pavluchenkor/iDryer-X/docs/en/v3/pcb-pinout.md

# Pinout

!!! tip "Fan Connection"
    Make sure the fan connector polarity matches the pinout on the board (Fan header). If needed, repin the fan connector accordingly.

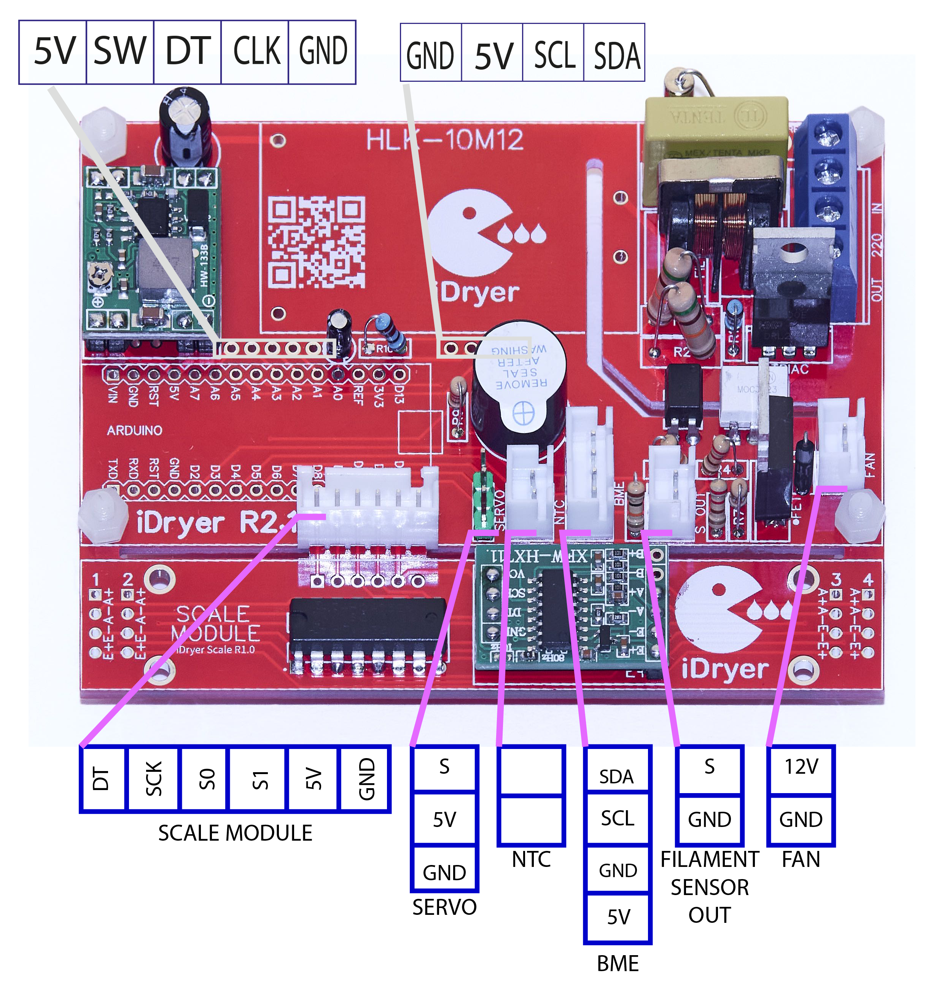
[picture p4: docs/img/pcb-pinout/pinout.png]


<!-- [![Telegram](https://img.shields.io/badge/Telegram-Join%20Group-blue)](https://t.me/iDryer)  [![YouTube](https://img.shields.io/badge/YouTube-Watch%20video-red)](https://www.youtube.com/@iDryerProject) [![Rutube](https://img.shields.io/badge/Rutube-Watch%20video-blue)](https://rutube.ru/channel/34401569/) -->
