pavluchenkor/iDryer-X/docs/ru/v3/pcb-pinout.md

# Pinout

!!! tip "Подлкючение кулера"
    Необходимо проверить соответствие полярности разъема вентилятора и разъема на плате(Fan). При необходимости следует перепиновать разъем вентилятора.
