pavluchenkor/iDryer-X/docs/en/v3/pcb.md

# Printed Circuit Board

## iDryer r2.1

You can independently order the manufacturing of the PCB and purchase the required components.
If you have basic soldering skills, assembly will be easy-components are all through-hole and large, and community members are always happy to help with advice.

!!! note "Download Files for r2.1"

```
PCB Design r2.1 on [jlcpcb.com](https://oshwlab.com/svet_team/idryer_copy_copy)

BOM for DIY assembly r2.1 on [Google Docs](https://docs.google.com/spreadsheets/d/1Y0MG9n_SadcK8cb_-e9J9ABQYqM_iH7iXZHlKbaz7wk/edit?usp=sharing)
```

## Appearance

<div class="grid cards" markdown>
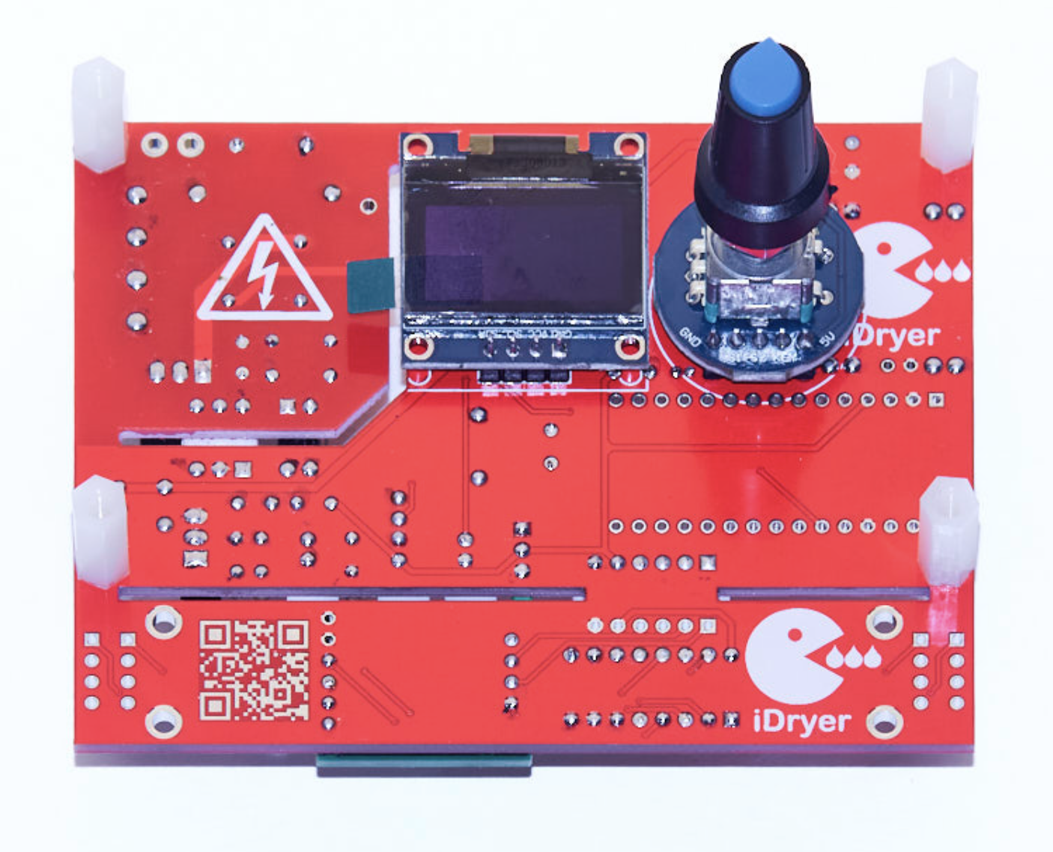
[picture p5: docs/img/pcb/img2023-12-12-1.png]
- 
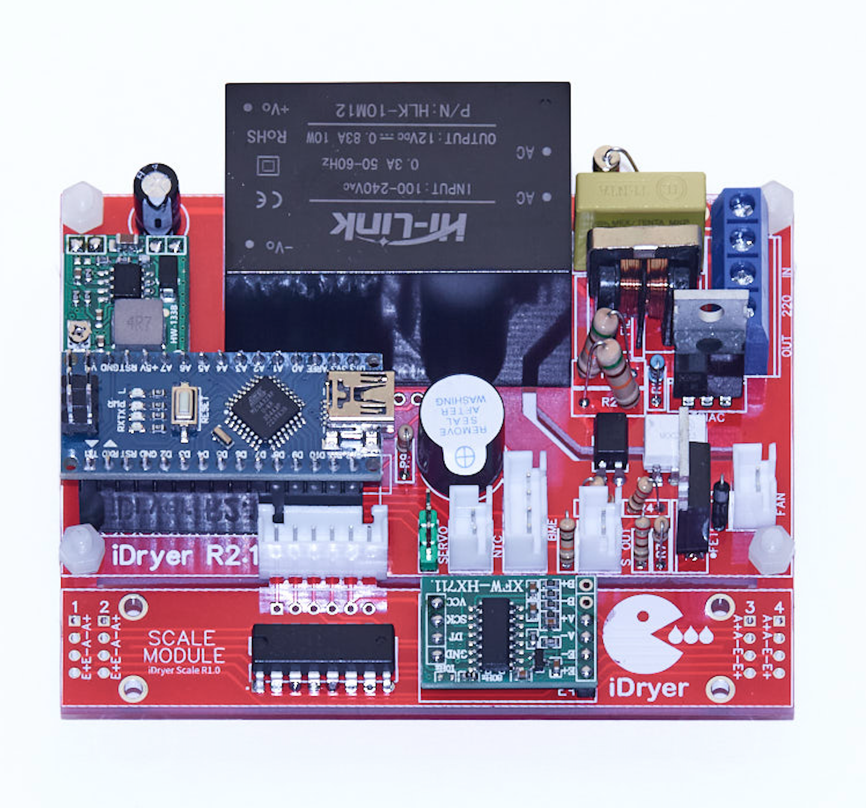
[picture p6: docs/img/pcb/img2023-12-12.png]
- 
</div>

!!! warning "Display and Encoder"
In the current case design, the display and encoder are connected using the wires included in the DIY kit.

<!-- [![Telegram](https://img.shields.io/badge/Telegram-Join%20Group-blue)](https://t.me/iDryer)  [![YouTube](https://img.shields.io/badge/YouTube-Watch%20video-red)](https://www.youtube.com/@iDryerProject) [![Rutube](https://img.shields.io/badge/Rutube-Watch%20video-blue)](https://rutube.ru/channel/34401569/) -->
