pavluchenkor/iDryer-X/docs/de/v3/before.md

# Vor der Montage

!!! warning "Bereiten Sie die erforderlichen Materialien und Geräte vor und überprüfen Sie die Vollständigkeit des Satzes."

## Materialien und Geräte

Für die Montage des Geräts benötigen Sie:

- Hochtemperatur-Silikon-Dichtstoff (z. B. Kamin- oder Automobilsilikon) mit guten Klebeigenschaften für PIR-Panel-basierte Materialien.

- 3D-Drucker und eine kleine Menge ABS-Kunststoff zum Drucken fehlender Gehäuseteile.

- Computer mit installiertem Visual Studio Code und PlatformIO

- USBASP-Programmer zum Flashen des Arduino Nano-basierten Steuerkarte.

- Lötausrüstung, einschließlich Lötkolben, Lot, Flussmittel und Reinigungsmittel für die Leiterplatte nach dem Löten.

- Multimeter zur Einstellung der Versorgungsspannung.

- Standard-Werkzeugsatz wie Schraubendreher, Messer, Seitenschneider, Elektroschrauber oder Bohrmaschine.

- Crimpzange zum Crimpen von Steckern und Verbindungen (bei Nichtvorhandensein können Hilfsmittel verwendet werden, jedoch wird eine Crimpzange für höhere Verbindungsqualität empfohlen).

## Montageempfehlungen

Lesen Sie die Anleitung und drucken Sie die erforderlichen Teile aus.

Bevor Sie Komponenten endgültig fixieren, müssen Sie sie vorher anpassen, anprobieren und überprüfen, dass sie richtig sitzen und kompatibel sind. Stellen Sie sicher, dass alle Teile korrekt installiert sind, dass nichts ihre Befestigung und weitere Montage behindert. Führen Sie erst nach vollständiger Überprüfung die endgültige Fixierung und Befestigung durch.

Wenn die Montage Elektronikkomponenten betrifft, müssen alle Arbeiten am Arbeitsplatz durchgeführt werden. Alle Baugruppen werden auf der Arbeitsfläche zusammengesetzt: Lüfter, Heizelement, Sensoren werden angeschlossen, Display, Encoder und andere Systemelemente. Nach Abschluss der Montage am Arbeitsplatz wird die Funktionsfähigkeit aller angeschlossenen Komponenten überprüft.

Dieser Ansatz vermeidet die Notwendigkeit, das bereits montierte Gerät beim Auffinden von Fehlern zu zerlegen, und macht den Montageprozess bequemer, sauberer und vorhersehbarer.
