pavluchenkor/iDryer-X/docs/de/v3/kit.md

# KIT

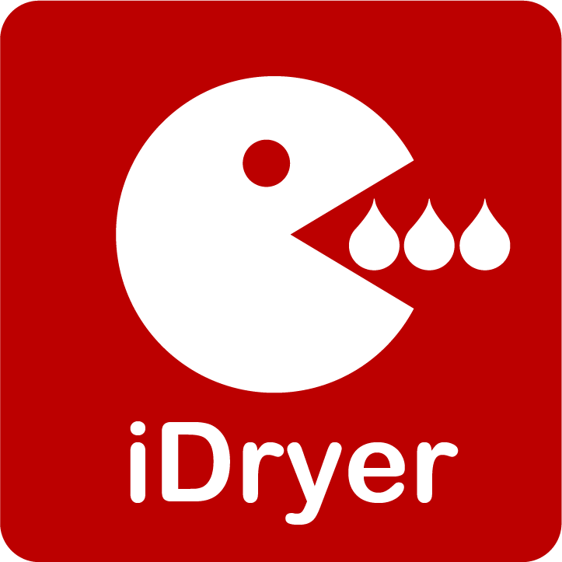
[picture p17: docs/img/kit/logoWeb1.png]


Das KIT-Set iDryer v3 enthält alle notwendigen Komponenten für den eigenständigen Aufbau des iDryer-Controllers sowie die Leiterplatte, das Display, den Encoder und Sensoren, gefräste PIR-Paneele für T-Nut- und Schwalbenschwanz-Verbindungen, Metallelemente für den Boden und Fadenhalter.
Alle elektronischen Komponenten sind bedrahtet und groß, was sie für Anfänger und fortgeschrittene Hobbybastler einfach zu montieren macht.

Erhältlich sowohl als fertig montierte Einheit als auch als Bausatz zum eigenständigen Zusammenbau.

[Inhalt des Elektronik-Kartons](https://youtube.com/shorts/1hu8ouUc0jI?si=bNsCUIabV3f5F1-T)

[iDryer-Trockner zusammenbauen](https://www.youtube.com/watch?v=QL7AUkCoISA&list=PLv8eJa-BRh3z09ve9bOKYYc3aWBMgUUt0&index=1)

KIT

!!! note "KIT-Inhalt vollständig"

    - Leiterplatte
    - ARDUINO_NANO
    - OLED-128X64-I2C
    - Rotary Encoder EC11
    - Servo SG-90 180 Grad
    - DC-DC Step Down MP1584
    - HX711
    - BME-280
    - Thermostat NC 130C
    - BLS-4 2.54mm 30cm
    - BLS-5 2.54mm 30cm
    - XH-4P-2.54 30cm
    - Thermistor
    - HLK-10M12
    - PTC-Keramikheizer (oder) wird in der PIR-Montage verwendet
    - Lüfter 7530
    - CD74HC4052E
    - MOC3023
    - 814
    - Active Buzzer 5V
    - Schalter
    - 2А 250В
    - BT137-600E
    - N Channel FET IRF840
    - Filter 10MH
    - 0.1uF 280V
    - 220uF 16-25V
    - 10uF 5-16V
    - 1N4007
    - 51K 2W
    - 10K
    - 4,7K
    - 1K
    - 220
    - XH-4P-2.54
    - XH-2P-2.54
    - KF128L-5.08-4P
    - DB301V-3.5-2P
    - PLS-5 (encoder)
    - PLS-4 (oled)
    - PLS-3 (servo)
    - 100K 5% 3950
    - Rotary encoder ЕС11
    - GY-BME280-5В
    - Delta 7530 BFB0712H
    - Heizer 220V/100W
    - KSD9700 130C
    - XH2.54 4P
    - Dupont 4P 30cm Stecker am Kabel
    - Dupont 5P 30cm Stecker am Kabel
    - Servo SG90 180
    - KF128 5.08/4P
    - Gehäusepaneele
    - Metallfußplatte
    - Metallische Fadenhalter-Wippe
    - Aluminiumrohr 10х1 86mm
    - Lager 623
    - Drucksensor
    - Verbindungsstück
    - Stromkabel mit Stecker

[KIT bestellen](https://store.idryer.org/)
