pavluchenkor/iDryer-X/docs/de/v3/load-cell.md

# Boden und Spulenhalteclips

Metallteile für Boden und Spulenhalteclips

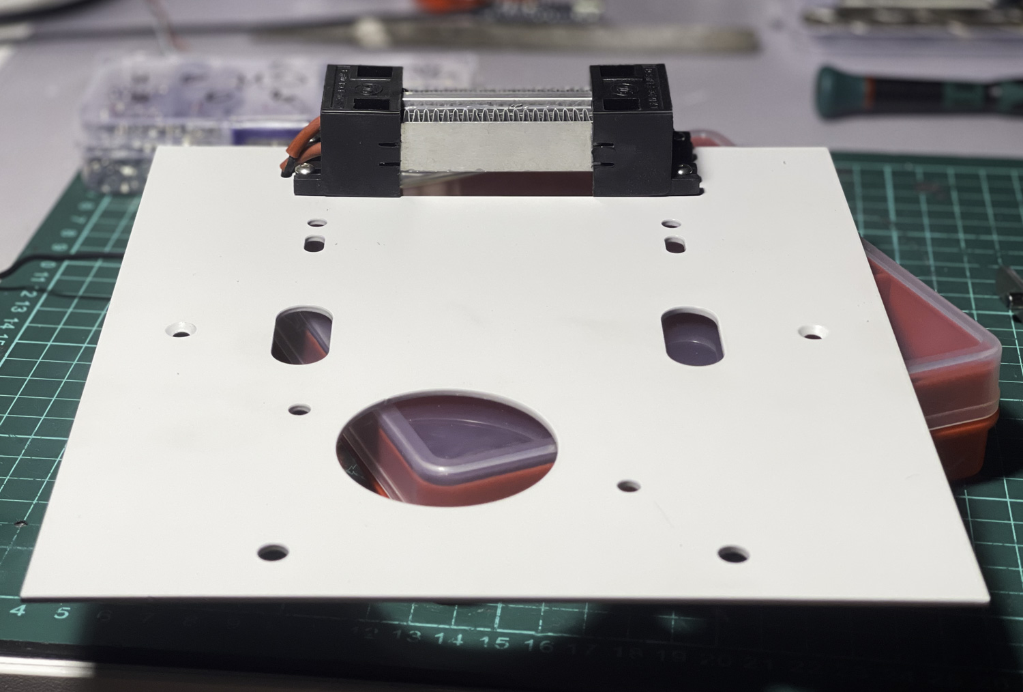
[picture p18: docs/img/load-cell/IMG_2438.jpg]

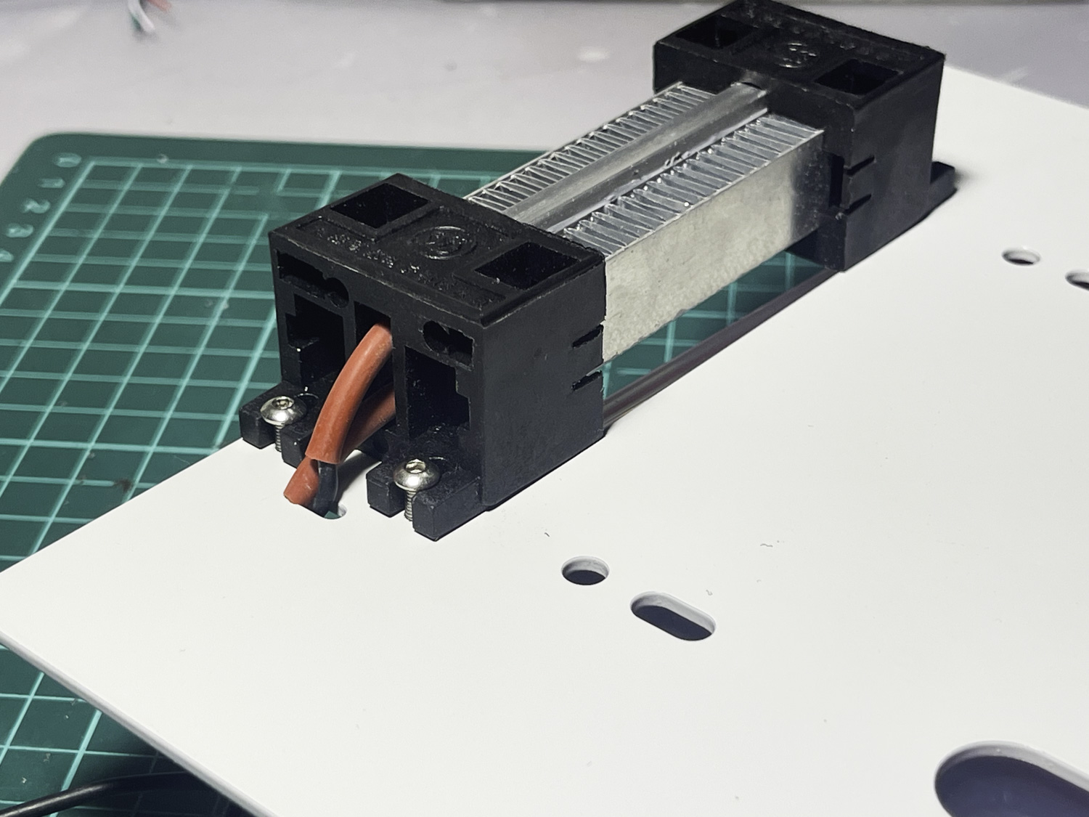
[picture p19: docs/img/load-cell/IMG_2439.jpg]

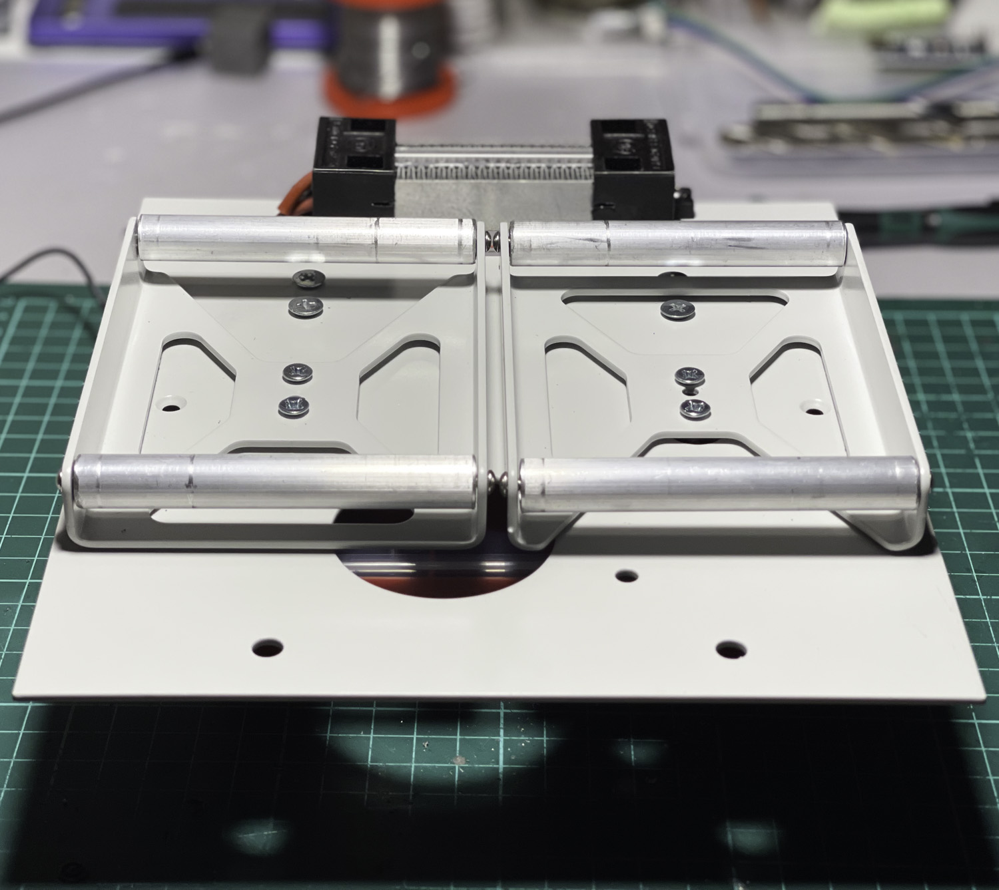
[picture p20: docs/img/load-cell/IMG_2442.jpg]

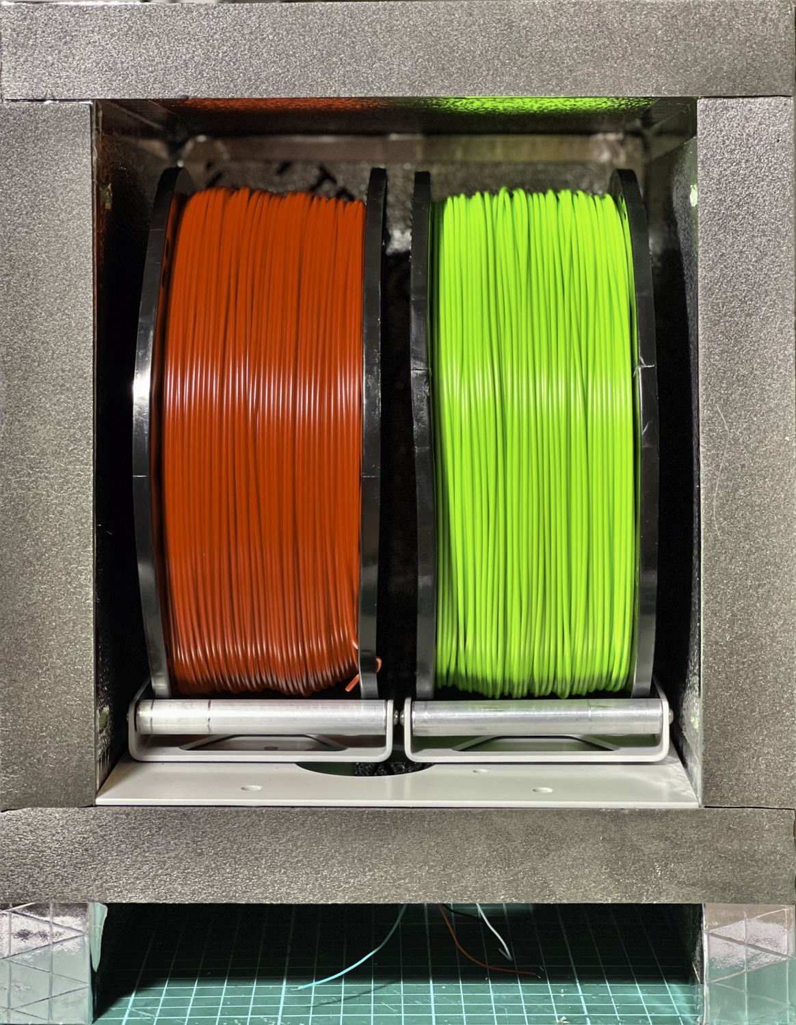
[picture p21: docs/img/load-cell/UEQO8811.jpg]


## Installation der Kraftaufnehmer

Es werden 5-kg-Kraftaufnehmer verwendet. Die Kraftaufnehmer werden mit Pfeil nach unten installiert.

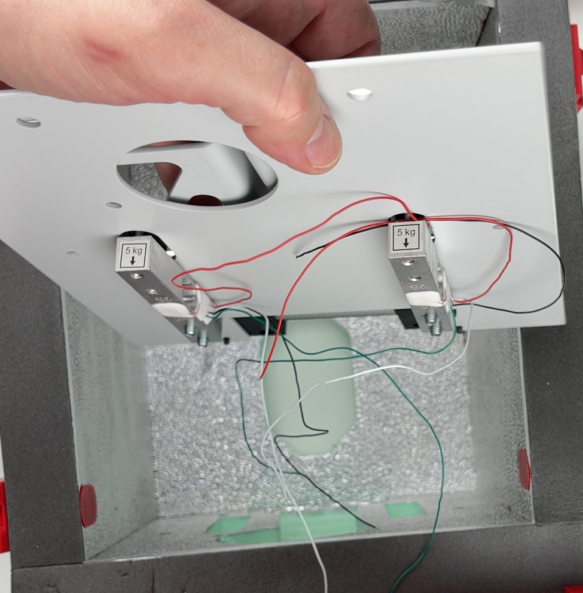
[picture p22: docs/img/load-cell/0002.png]


Es ist notwendig, mit Unterlegscheiben einen Spalt zwischen dem Boden und dem Kraftaufnehmer einzustellen, sodass das Harz, unter dem sich der Messwiderstand befindet, den Boden nicht berührt.

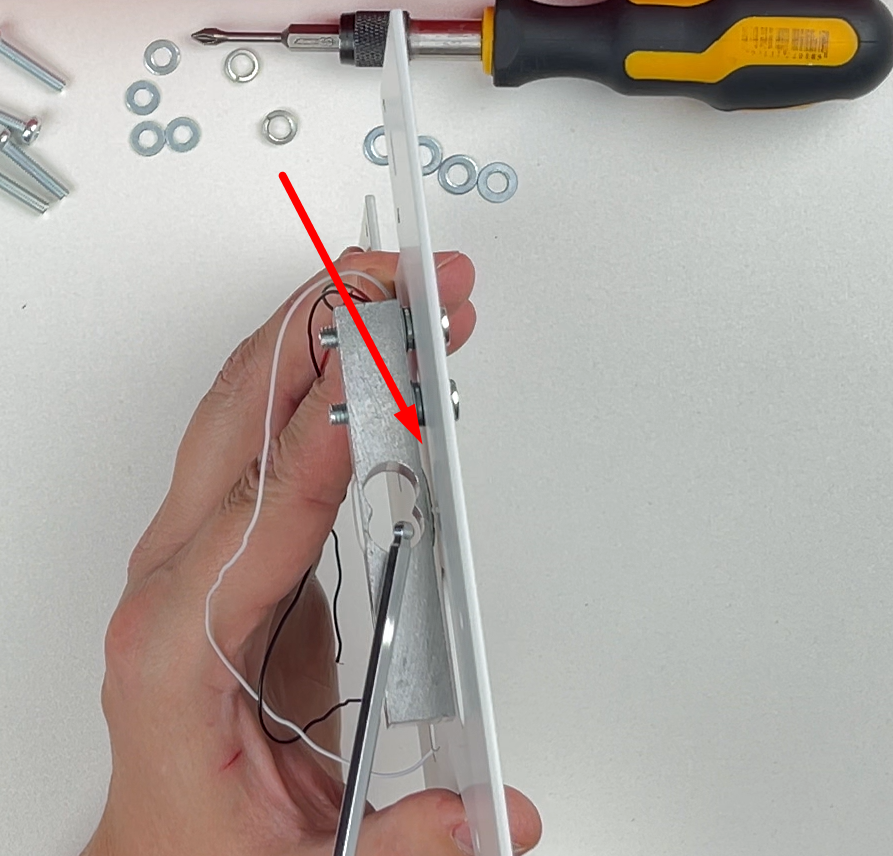
[picture p23: docs/img/load-cell/0001.png]


Je nach Hersteller des Sensors können zur Befestigung am Boden Schrauben M5 oder M4 mit einer Länge von 20 mm verwendet werden. Die Befestigung des Spulenhalteclips erfolgt meist mit M4-Schrauben, Schraubenlänge 16-20 mm.

Der Spalt zwischen dem Spulenhalteclip und dem Boden wird durch gedruckte Abstandshalter oder Unterlegscheiben eingestellt und sollte 2-4 mm betragen und die freie Bewegung des Spulenhalteclips unter dem Gewicht der Spule nicht behindern.

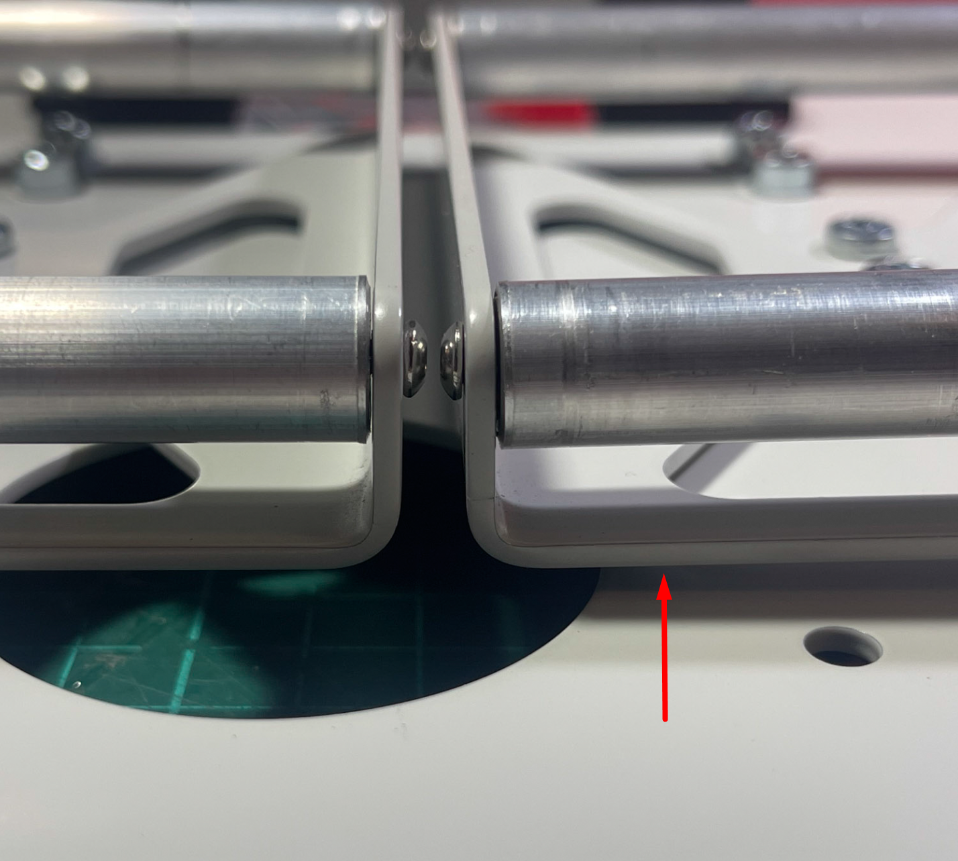
[picture p24: docs/img/load-cell/0003.png]


## Verkabelung

Die Kabel werden durch Einstiche in den Kraftaufnehmer-Nuten in den Keller geführt. Die Einstiche auf der Kellersseite werden mit Aluminiumklebeband abgedeckt.
