pavluchenkor/iDryer-X/docs/en/v3/cabinet.md

# Assembly

Before starting the assembly process, review the following materials to understand the upcoming steps:

[Assembly video on Rutube](https://rutube.ru/video/b7bb53ed416722cbda444a9ed7b17bde/)

[Assembly video on YouTube](https://www.youtube.com/watch?v=QL7AUkCoISA&list=PLv8eJa-BRh3z09ve9bOKYYc3aWBMgUUt0&ab_channel=iDryer)

## Assembling PIR Panels

Check all parts and fit them together without glue.

Prepare the floor panel as shown in the images:

<div class="grid cards" markdown>
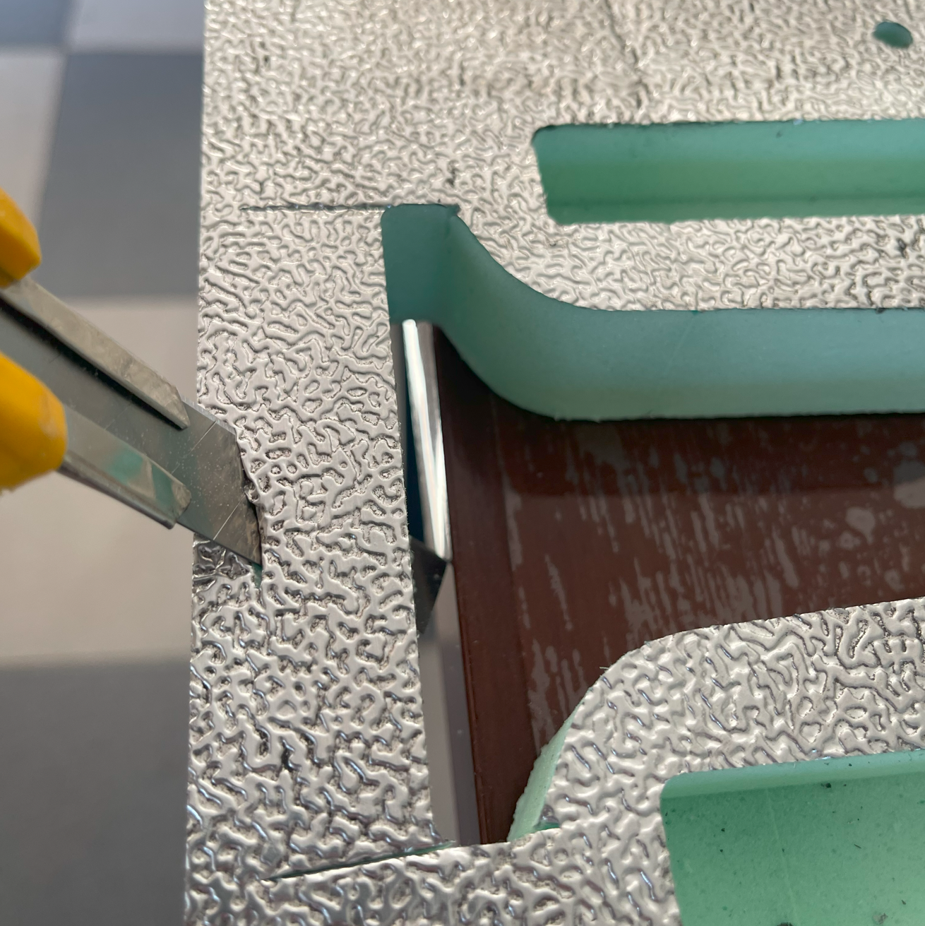
[picture p25: docs/img/cabinet/0004.png]
Preparing the iDryer floor part
- 
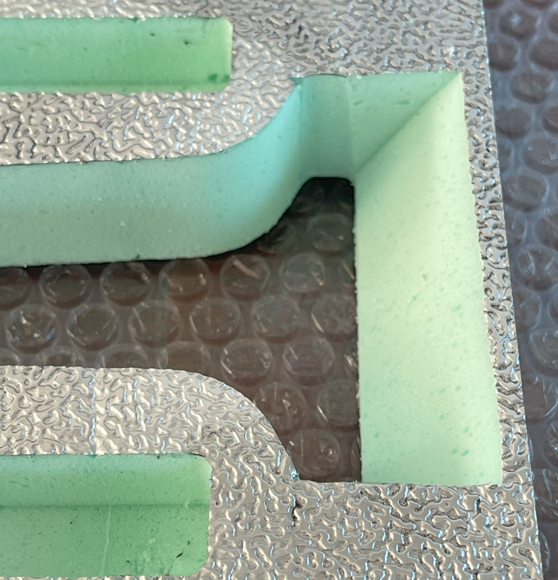
[picture p26: docs/img/cabinet/0005.png]
Preparing the floor part
- 
</div>

Alternatively, use the rotating insert from the file [iDryer\_set2.3mf](../../../CAD/v3/iDryer_set2.3mf). With this method, you don't need to bevel the floor part-just cut out the missing rectangle in the milled air duct. The offset from the edge of the floor panel should be 5 mm (groove depth in the back wall).

<div class="grid cards" markdown>
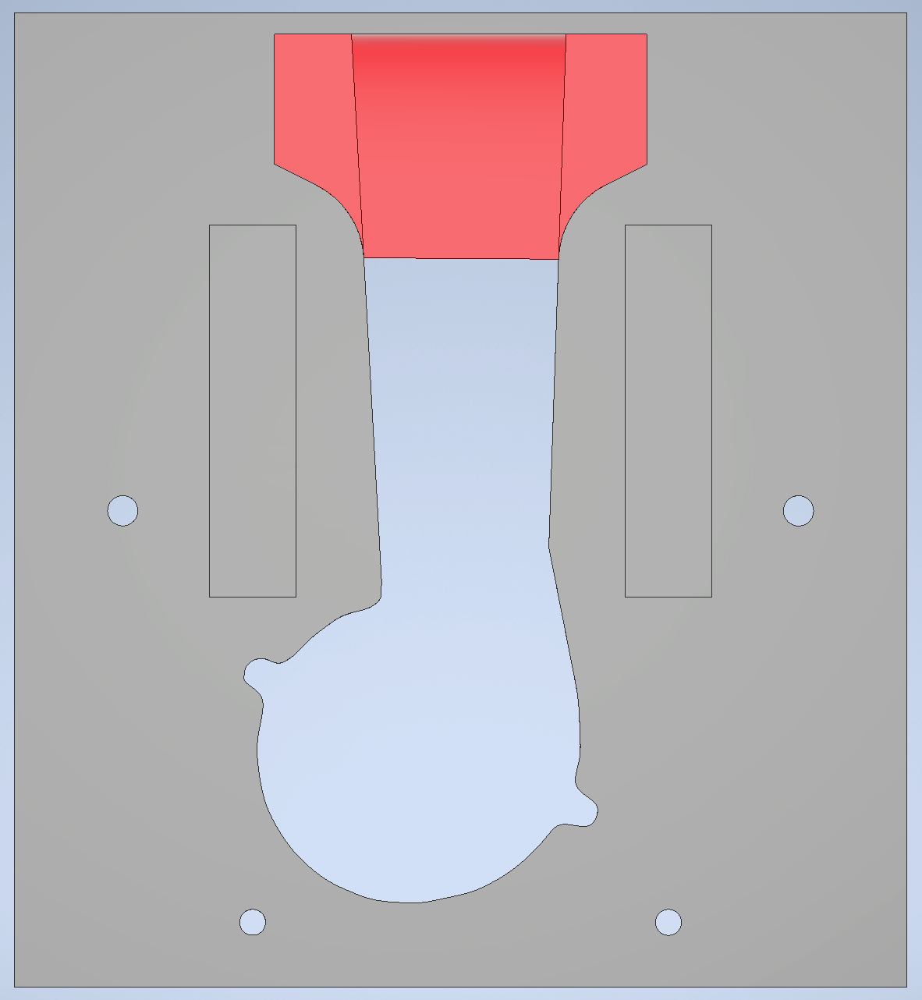
[picture p27: docs/img/cabinet/0015.png]
iDryer
- 
</div>

You will need a spatula from the printed parts kit and heat-resistant sealant.

Apply sealant to the parts:

<div class="grid cards" markdown>
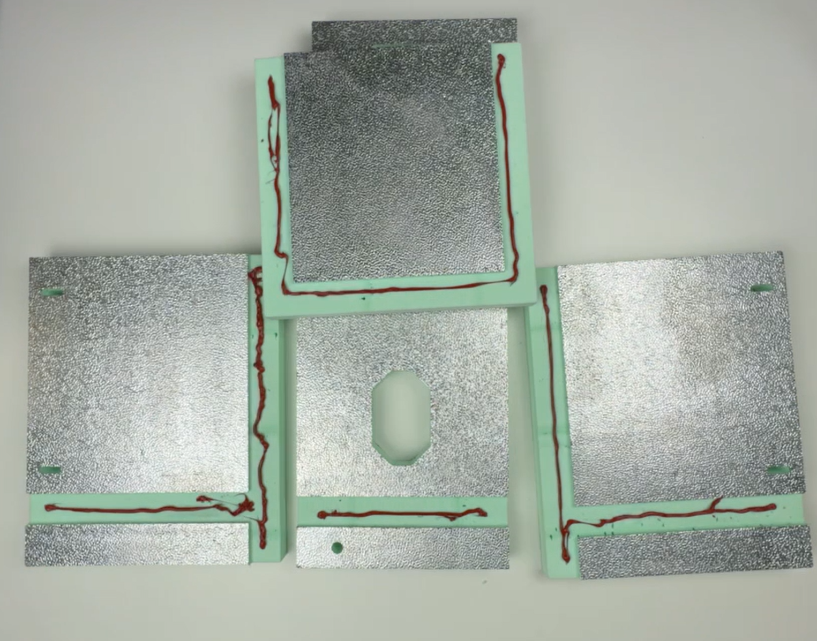
[picture p28: docs/img/cabinet/0006.png]
- 
</div>

Spread it using the spatula:

<div class="grid cards" markdown>
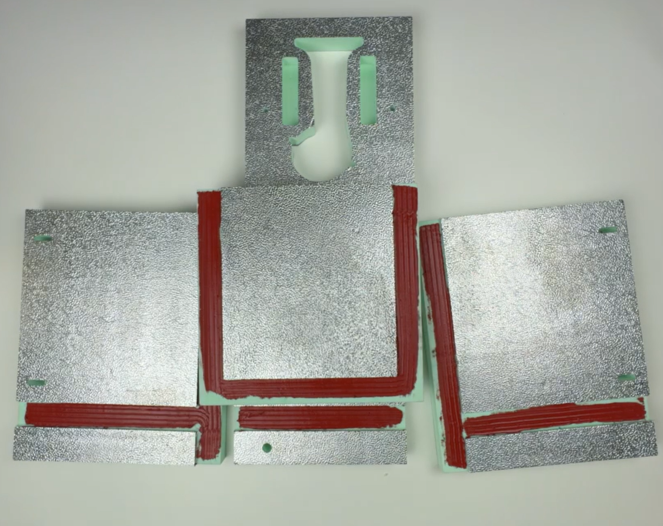
[picture p29: docs/img/cabinet/0007.png]
- 
</div>

Assemble the box:

<div class="grid cards" markdown>
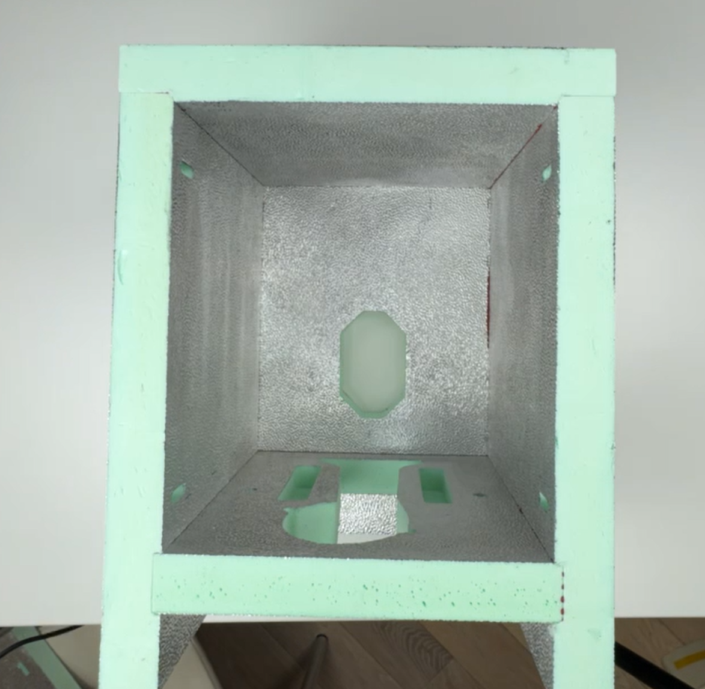
[picture p30: docs/img/cabinet/0008.png]
- 
</div>

Tape all sides of the box with masking tape:

<div class="grid cards" markdown>
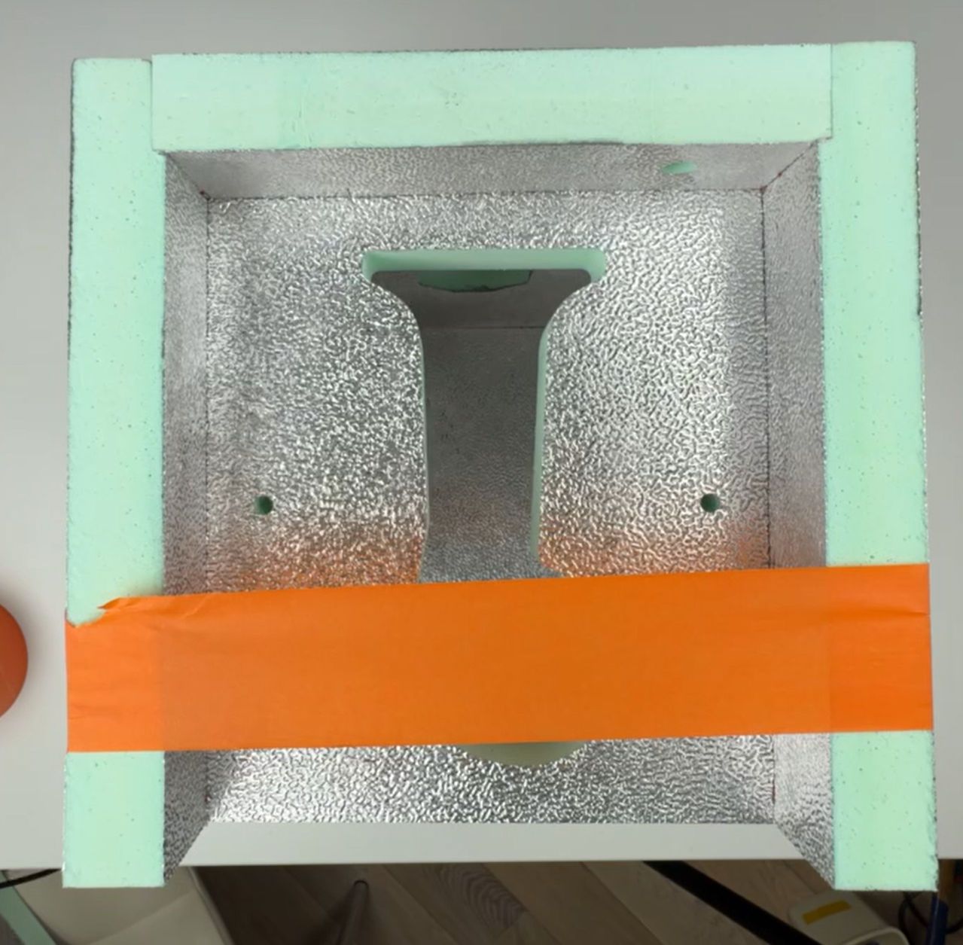
[picture p31: docs/img/cabinet/0009.png]
- 
</div>

Glue the cap and printed part:

<div class="grid cards" markdown>
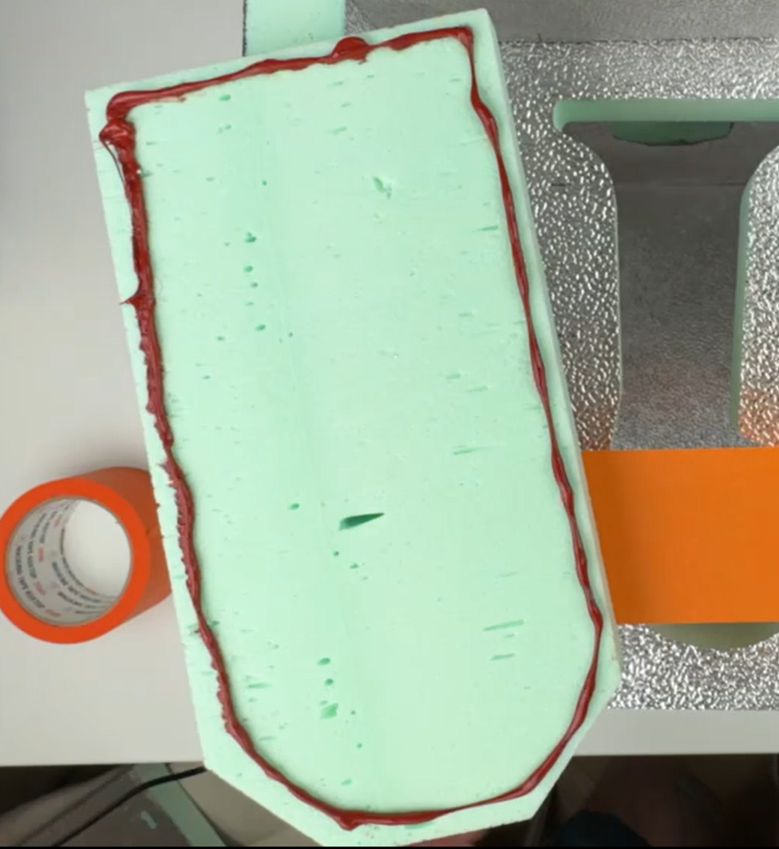
[picture p32: docs/img/cabinet/0010.png]
- 
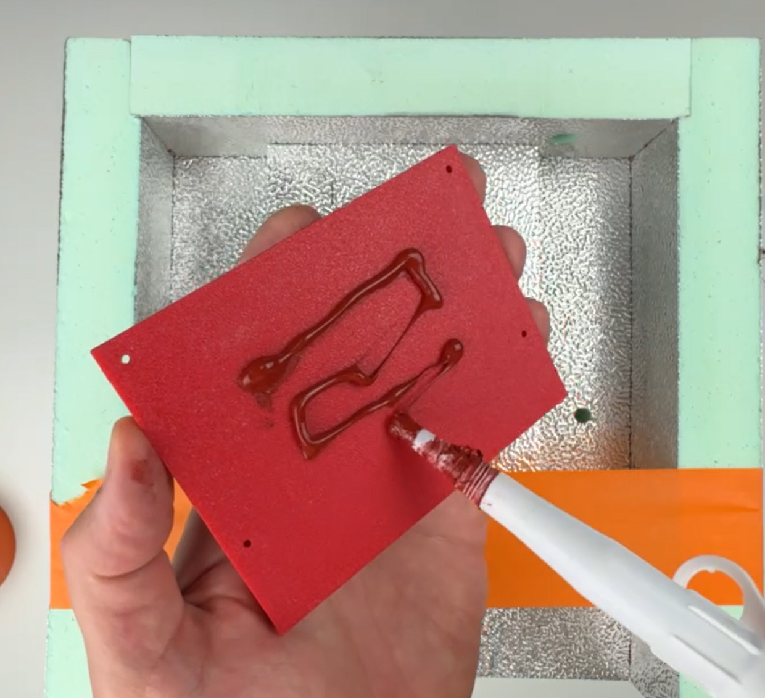
[picture p33: docs/img/cabinet/0011.png]
- 
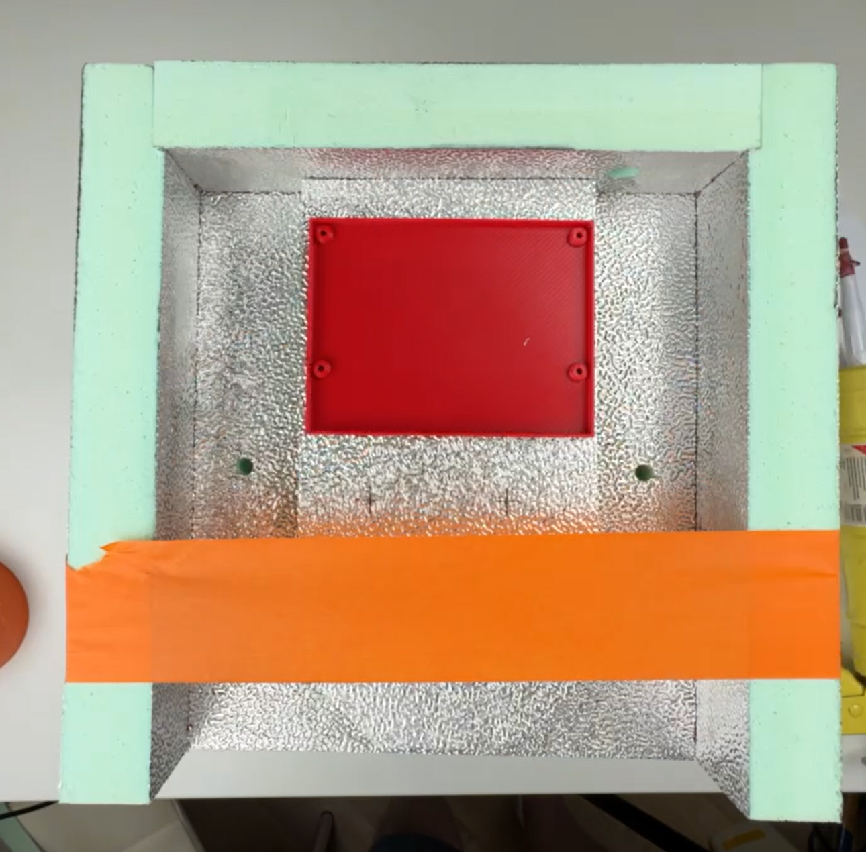
[picture p34: docs/img/cabinet/0012.png]
- 
</div>

Allow the sealant to cure fully.

## Applying Foil Tape

Cover the edge areas with aluminum tape.

Use a marking gauge for layout:

<div class="grid cards" markdown>
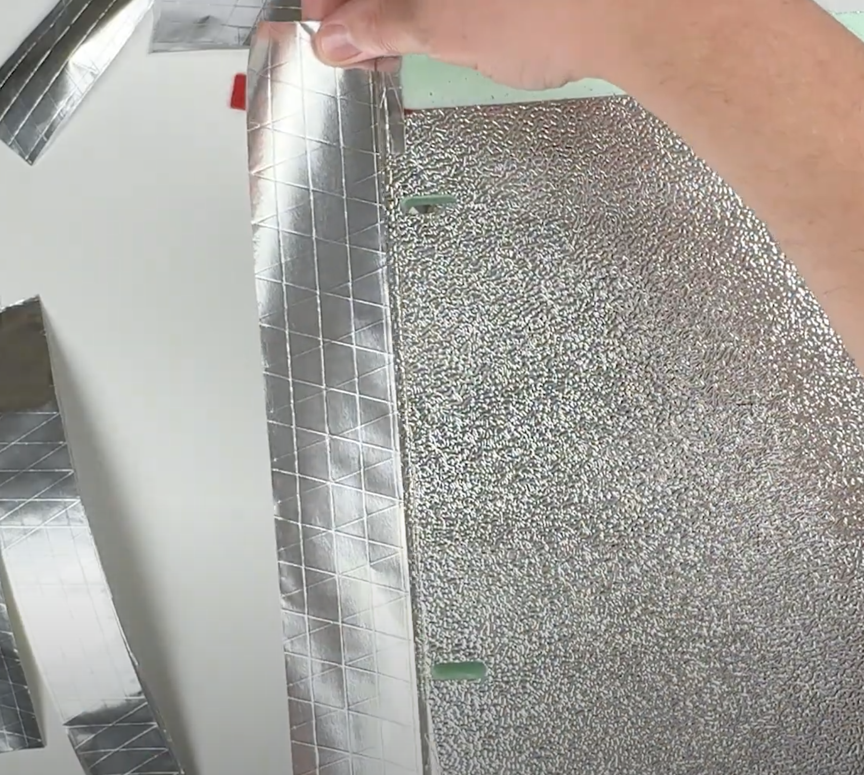
[picture p35: docs/img/cabinet/0013.png]
- 
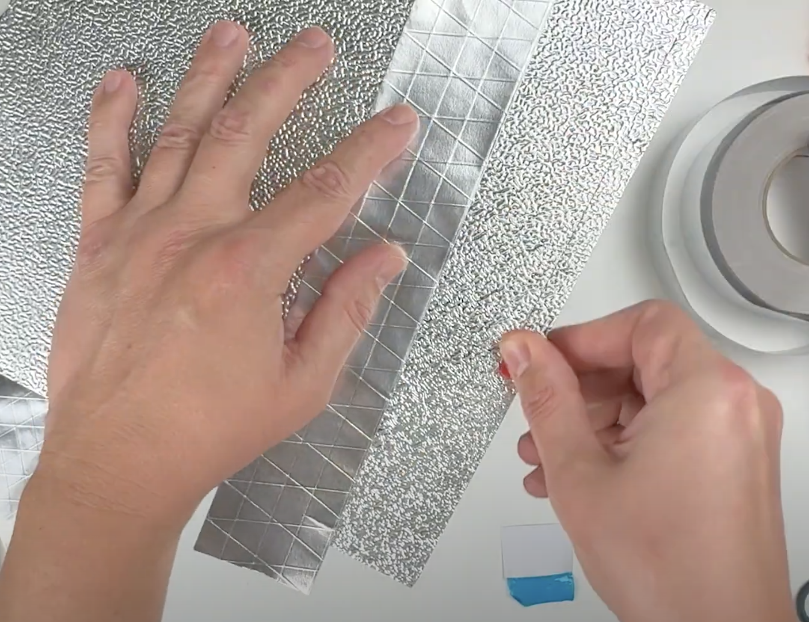
[picture p36: docs/img/cabinet/0014.png]
- 
</div>
