pavluchenkor/iDryer-X/docs/en/v3/pir-box-cad.md

# Printable Parts

Download the necessary parts and make sure you print everything you need.

!!! quote annotate "Parts in 3mf format"

    :material-download:</i> **[iDryer_set1.3mf](../../../CAD/v3/iDryer_set1.3mf)**

    :material-download:</i> **[iDryer_set2.3mf](../../../CAD/v3/iDryer_set2.3mf)**

    :material-download:</i> **[LogoPlate.3mf](../../../CAD/v3/LogoPlate.3mf)**

    :material-download:</i> **[clips.3mf](../../../CAD/v3/clips.3mf)**

    :material-download:</i> **[panel_x2.3mf](../../../CAD/v3/panel_x2.3mf)**

    :material-download:</i> **[panel_x3.3mf](../../../CAD/v3/panel_x3.3mf)**

    :material-download:</i> **[panel_x4.3mf](../../../CAD/v3/panel_x4.3mf)**

## Filament Selection

Enclosure parts should be printed from ABS, ABS CF, or other heat-resistant filaments.

## CAD Files

Full assembly models are also available for download. Use these files if you have questions about part purpose or the complete print set.

!!! quote annotate "Full enclosure model x2"

    **[PIR Enclosure x2.stp](../../../CAD/v3/x2.stp)**

!!! quote annotate "Full enclosure model x3"

    **[PIR Enclosure x3.stp](../../../CAD/v3/x3.stp)**

!!! quote annotate "Full enclosure model x4"

    **[PIR Enclosure x4.stp](../../../CAD/v3/x4.stp)**

## PIR Panel Drawings for CNC Cutting

DWG drawings of PIR foam panels for CNC routing. Before running, adjust the part layout to match your machine's table size, slab dimensions, and router bit diameter.

!!! quote annotate "PIR panel drawings (.dwg)"

    :material-download: **[Panels x2 (DWG)](../../../CAD/v3/DWG-PIR/x2.dwg)**

    :material-download: **[Panels x3 (DWG)](../../../CAD/v3/DWG-PIR/x3.dwg)**

    :material-download: **[Panels x4 (DWG)](../../../CAD/v3/DWG-PIR/x4.dwg)**

## Metal Parts Drawings for Laser Cutting

DWG drawings of metal parts for laser cutting.

!!! quote annotate "Metal laser cutting (.dwg)"

    :material-download: **[Base plate x2 (DWG)](../../../CAD/v3/DWG-LASERCUT/x2.dwg)**

    :material-download: **[Base plate x3 (DWG)](../../../CAD/v3/DWG-LASERCUT/x3.dwg)**

    :material-download: **[Base plate x4 (DWG)](../../../CAD/v3/DWG-LASERCUT/x4.dwg)**

    :material-download: **[Spool Holder (DWG)](../../../CAD/v3/DWG-LASERCUT/spoolholder.dwg)**

<!-- [![Telegram](https://img.shields.io/badge/Telegram-Join%20Group-blue)](https://t.me/iDryer)  [![YouTube](https://img.shields.io/badge/YouTube-Watch%20video-red)](https://www.youtube.com/@iDryerProject) [![Rutube](https://img.shields.io/badge/Rutube-Watch%20video-blue)](https://rutube.ru/channel/34401569/) -->
