pavluchenkor/iDryer-X/docs/en/v3/pir-box.md

# v3

## Housing Components

Housing material consists of milled PIR panels

<!-- !!! info Details for milling
    [X2 dwg](../../../CAD/v3/DWG-PIR/x2.dwg)
    [X3 dwg](../../../CAD/v3/DWG-PIR/x3.dwg)
    [X4 dwg](../../../CAD/v3/DWG-PIR/x4.dwg) -->

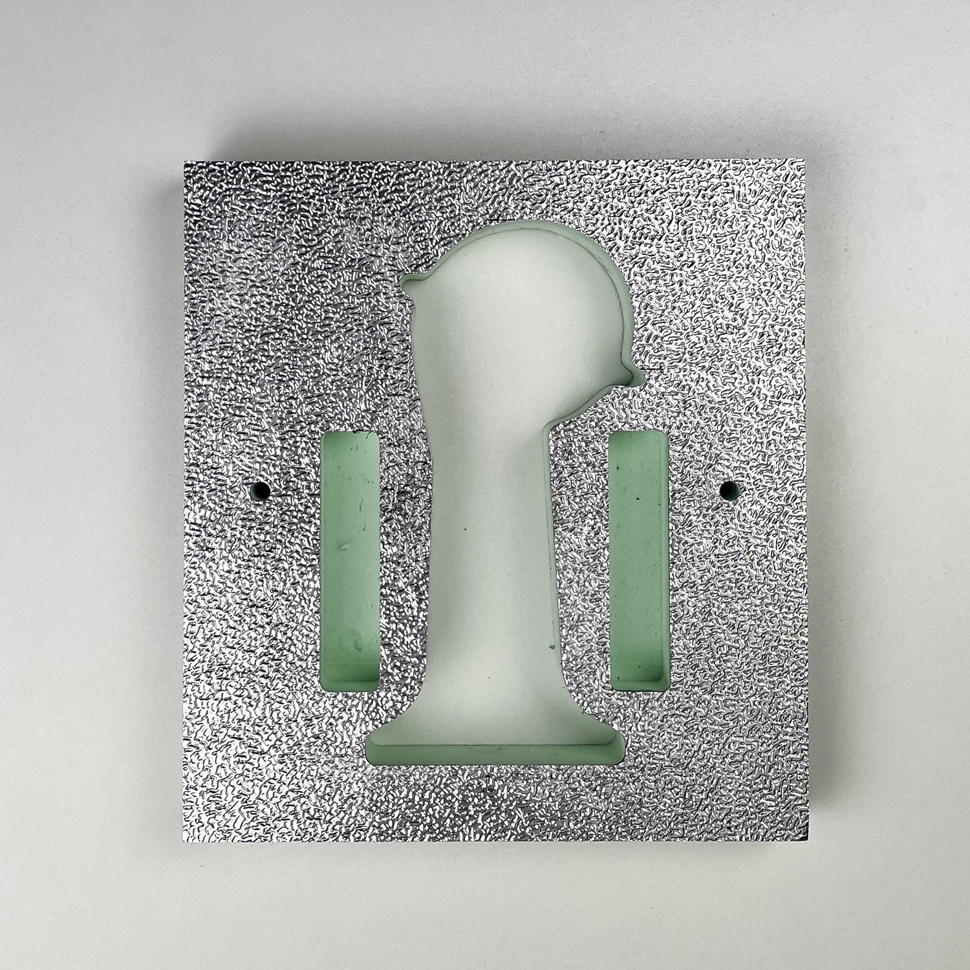
[picture p37: docs/img/pir-box-v3/IMG_2916.jpg]

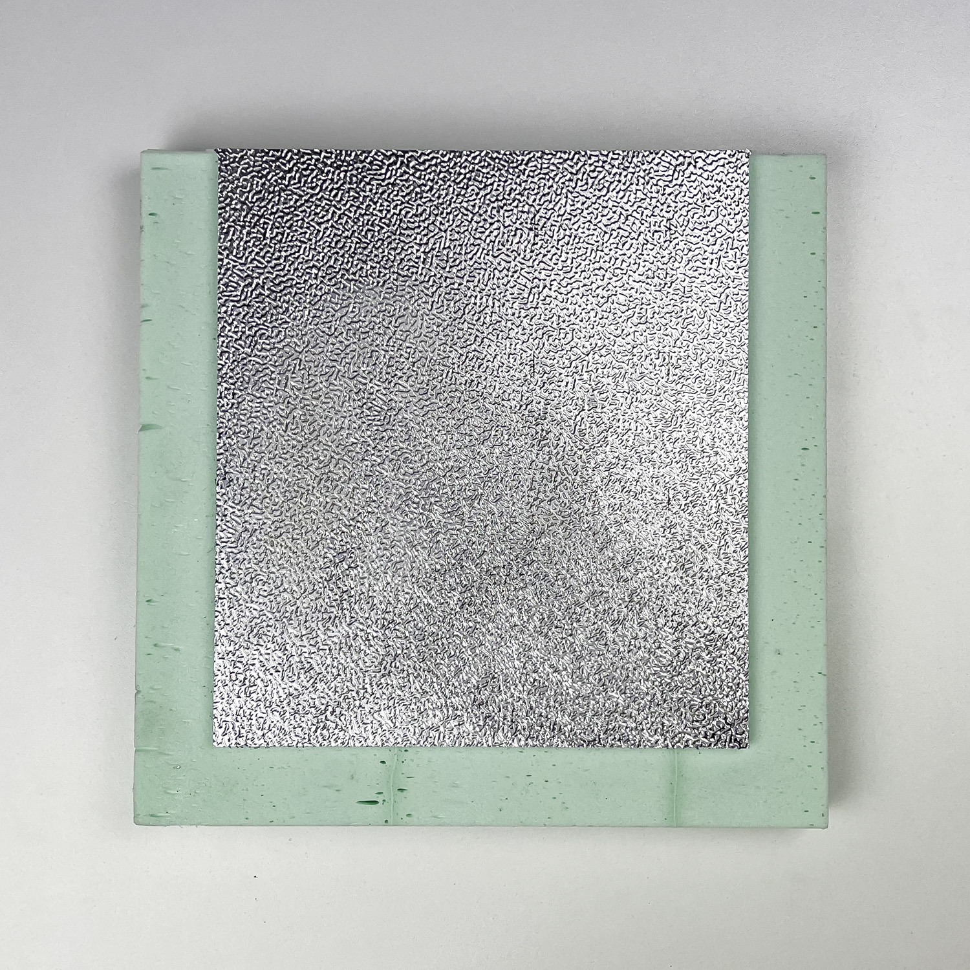
[picture p38: docs/img/pir-box-v3/IMG_2917.jpg]

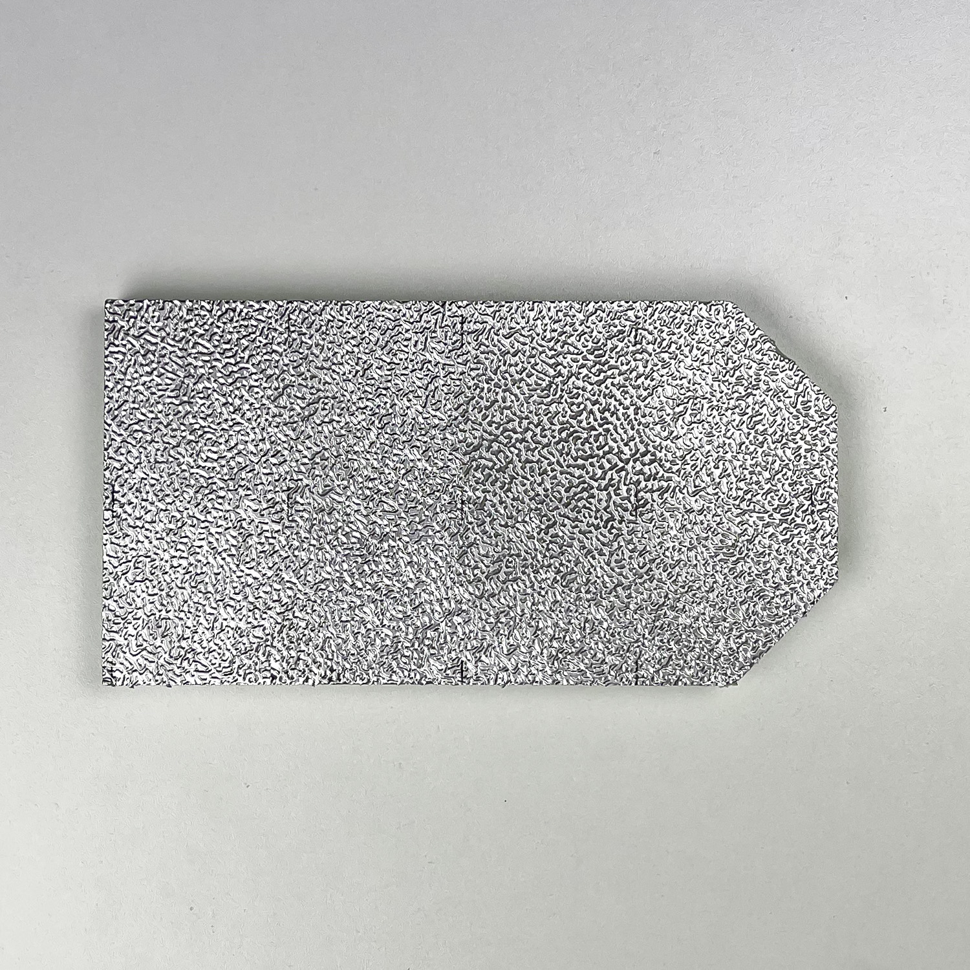
[picture p39: docs/img/pir-box-v3/IMG_2918.jpg]

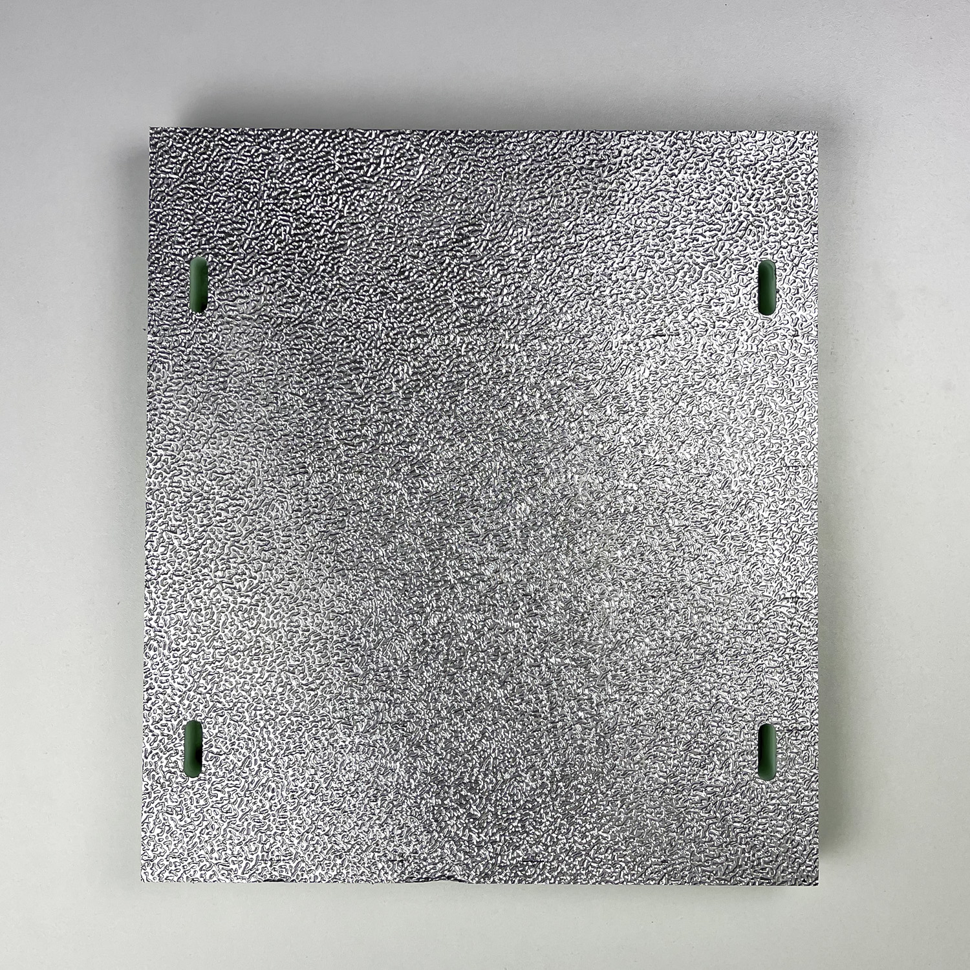
[picture p40: docs/img/pir-box-v3/IMG_2919.jpg]

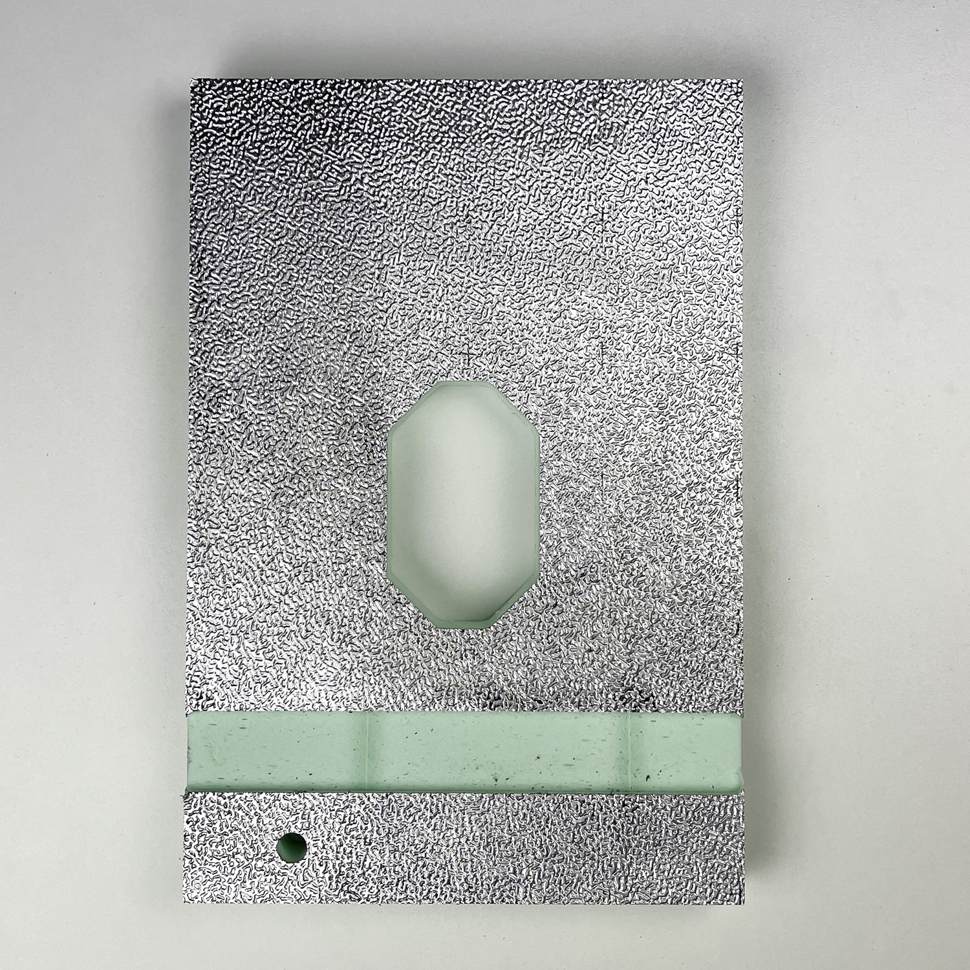
[picture p41: docs/img/pir-box-v3/IMG_2920.jpg]

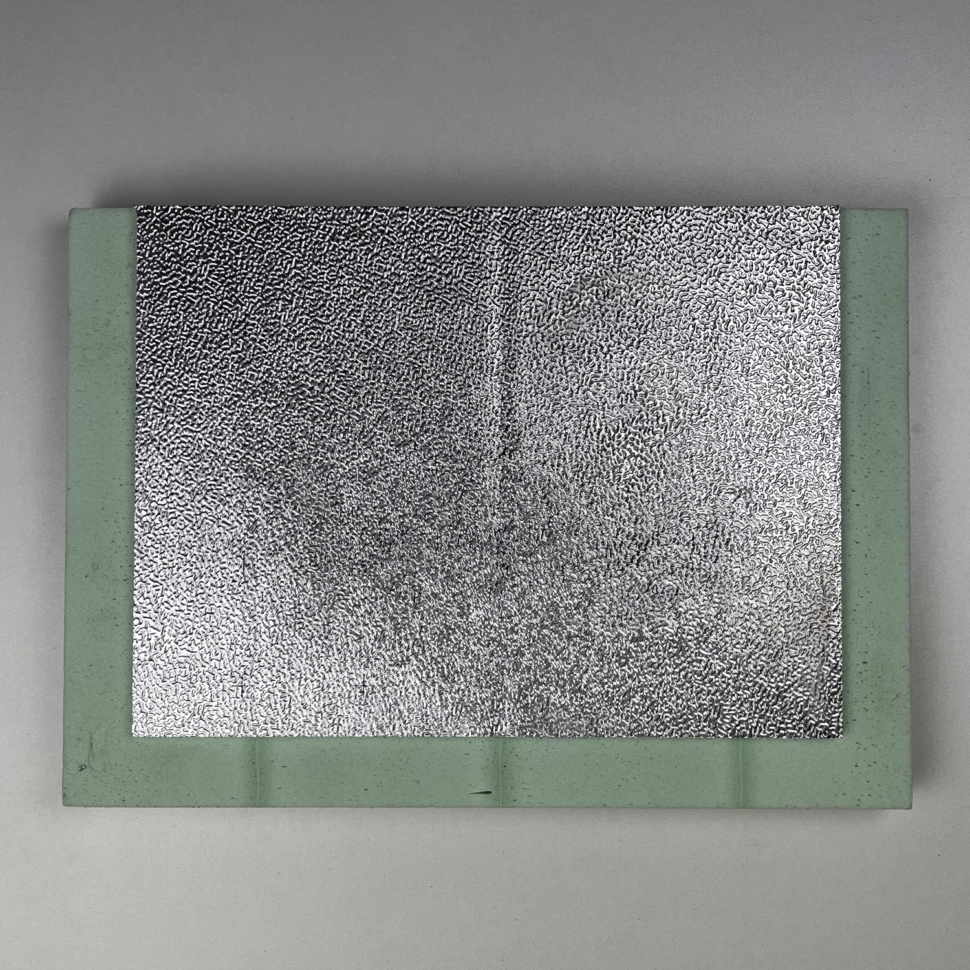
[picture p42: docs/img/pir-box-v3/IMG_2921.jpg]

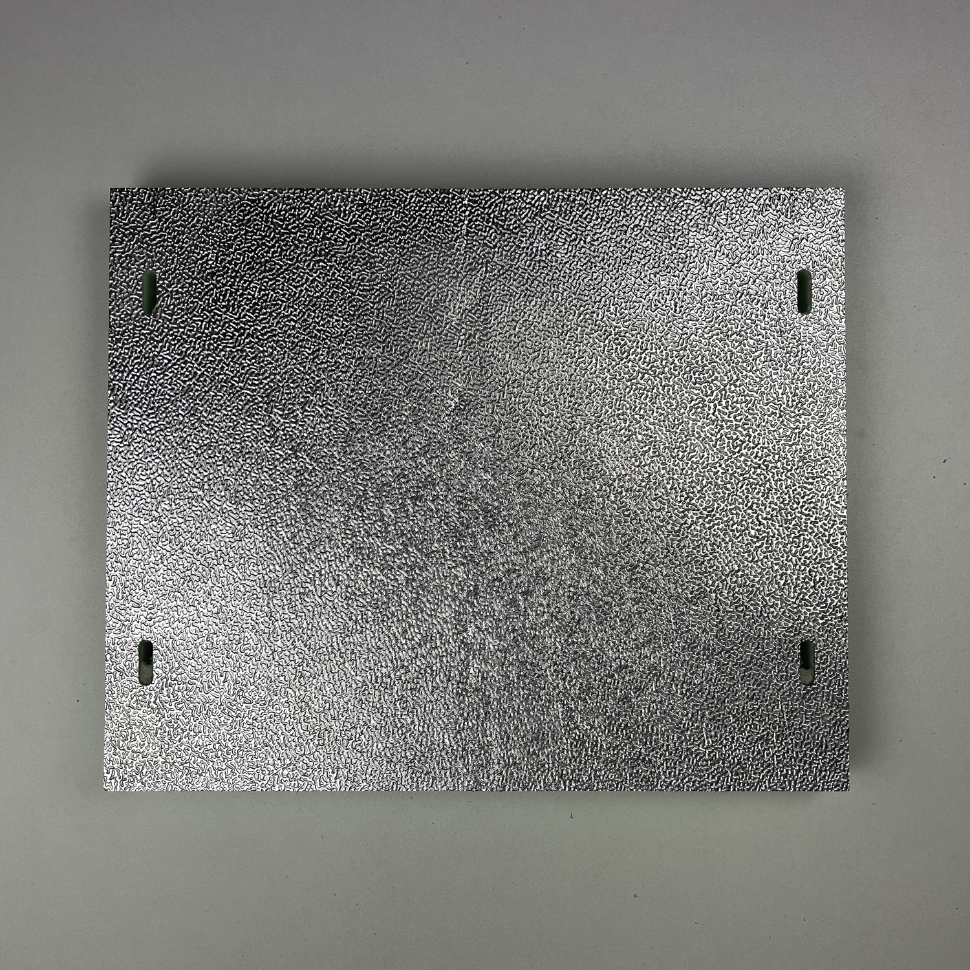
[picture p43: docs/img/pir-box-v3/IMG_2922.jpg]

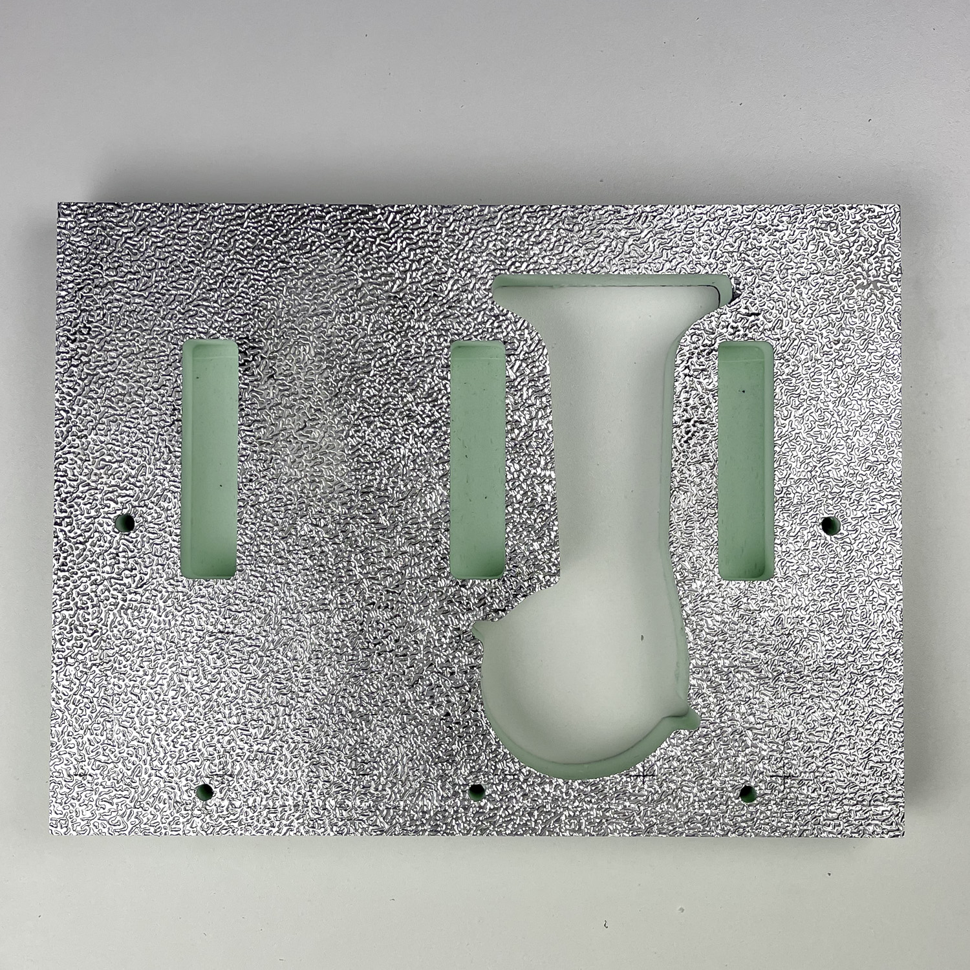
[picture p44: docs/img/pir-box-v3/IMG_2923.jpg]

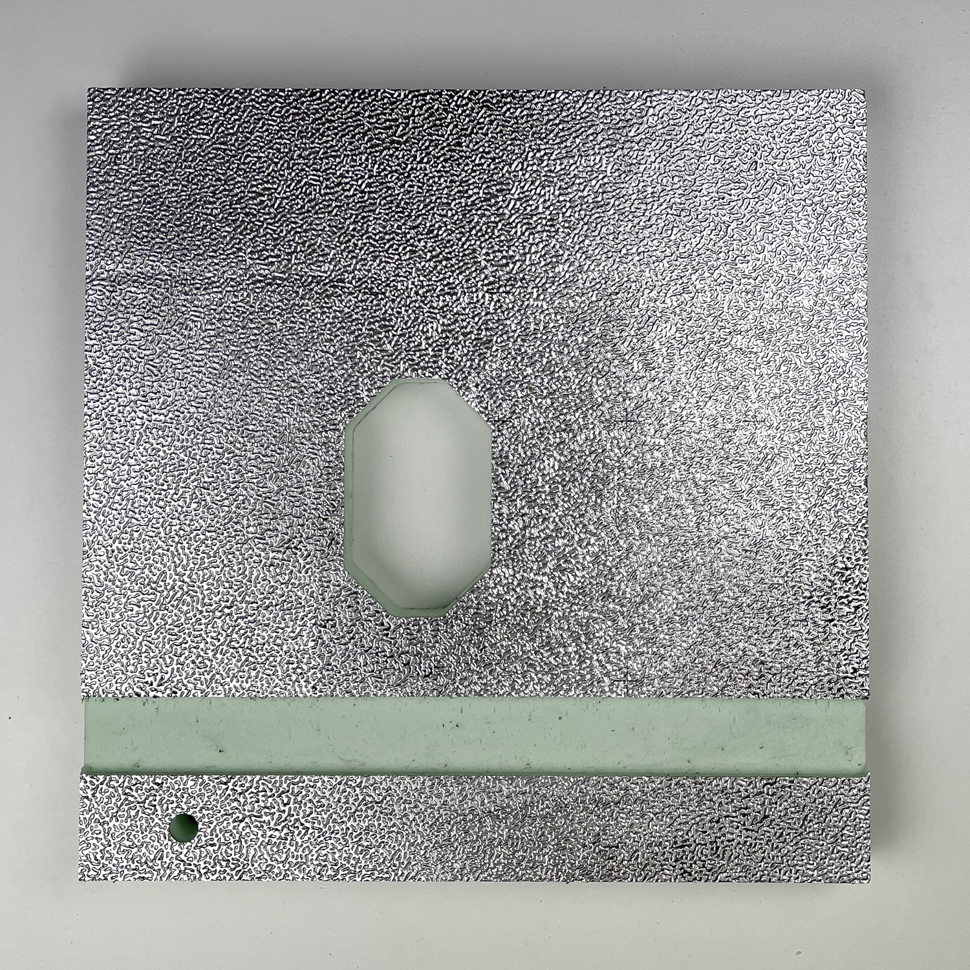
[picture p45: docs/img/pir-box-v3/IMG_2924.jpg]

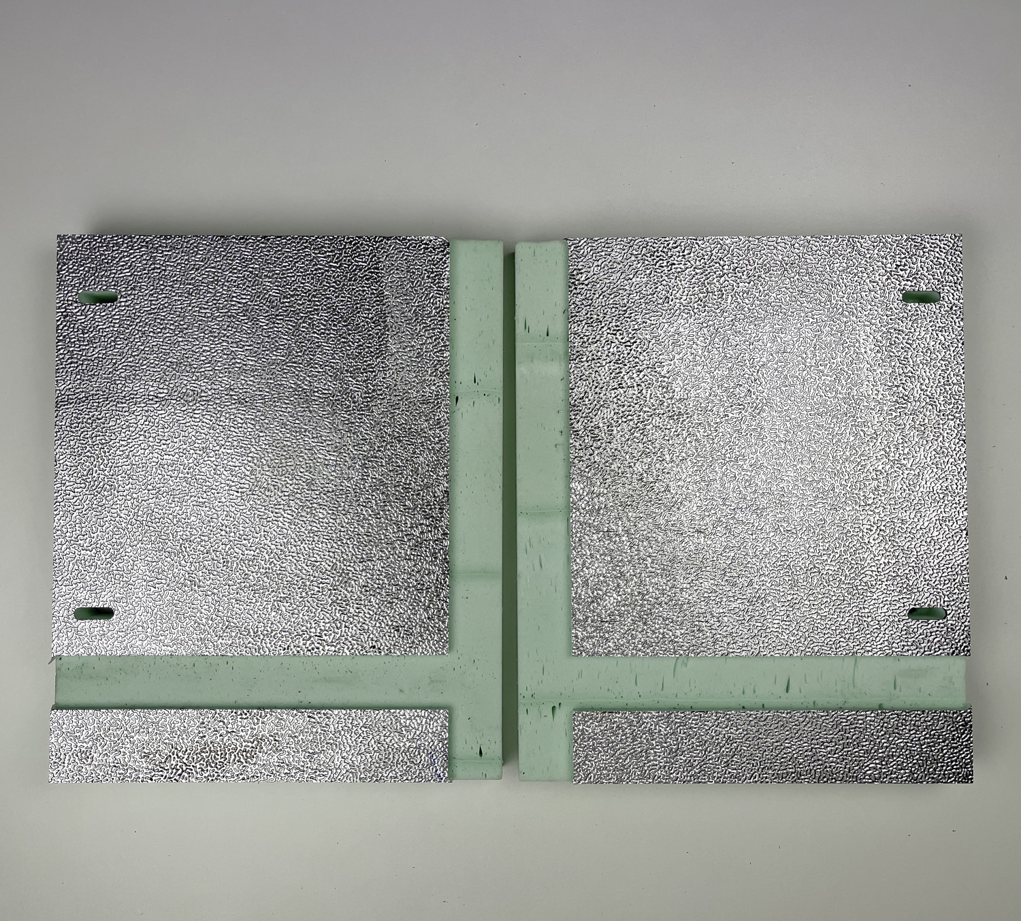
[picture p46: docs/img/pir-box-v3/IMG_2925.jpg]

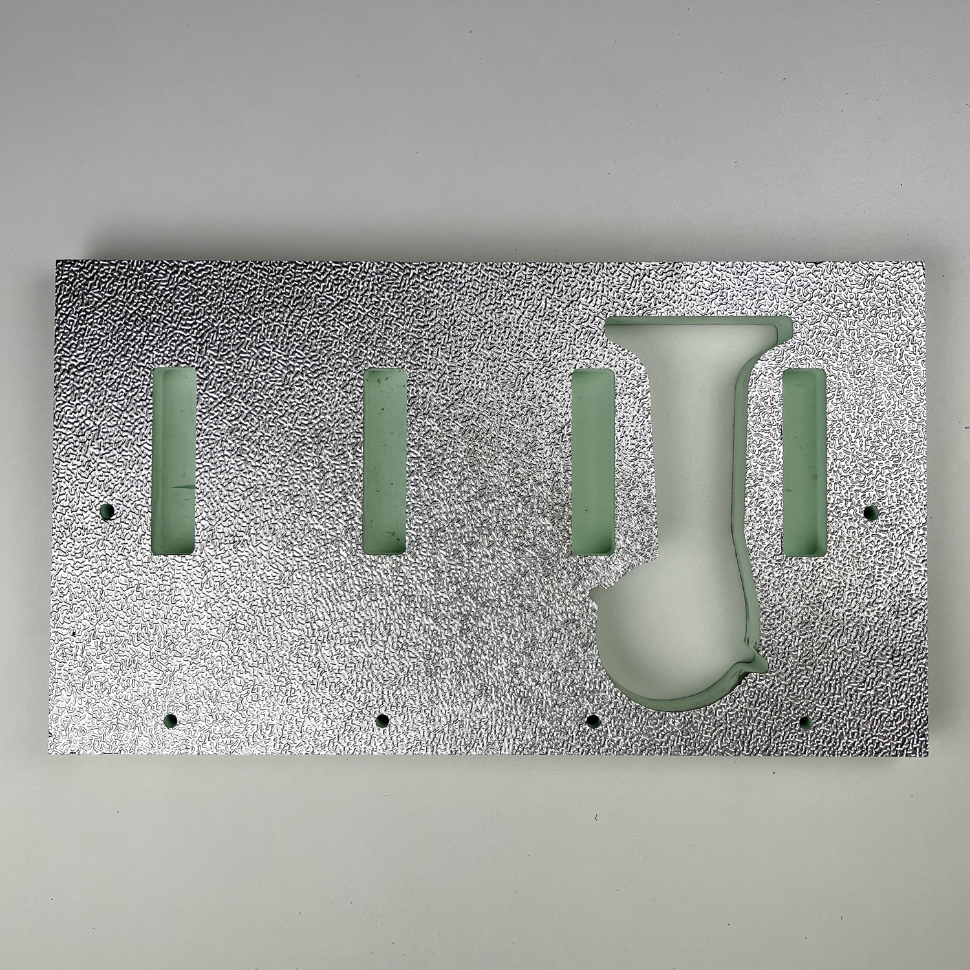
[picture p47: docs/img/pir-box-v3/IMG_2926.jpg]

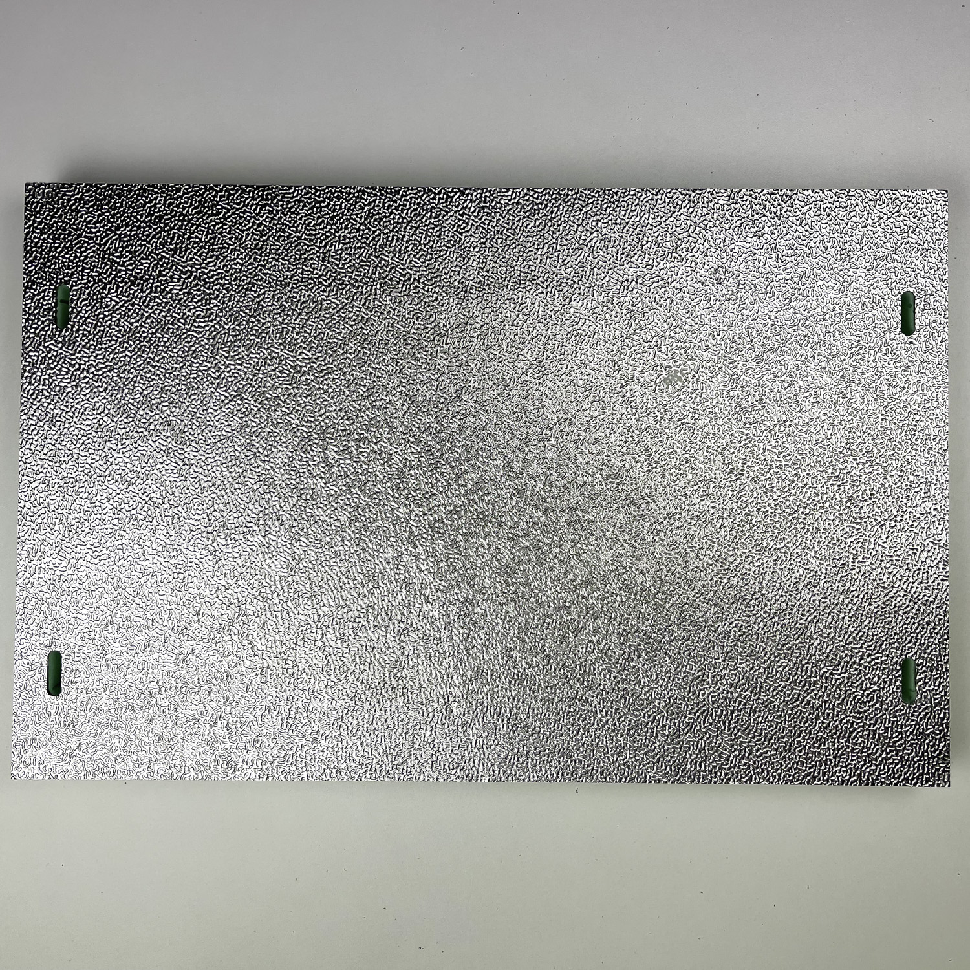
[picture p48: docs/img/pir-box-v3/IMG_2927.jpg]

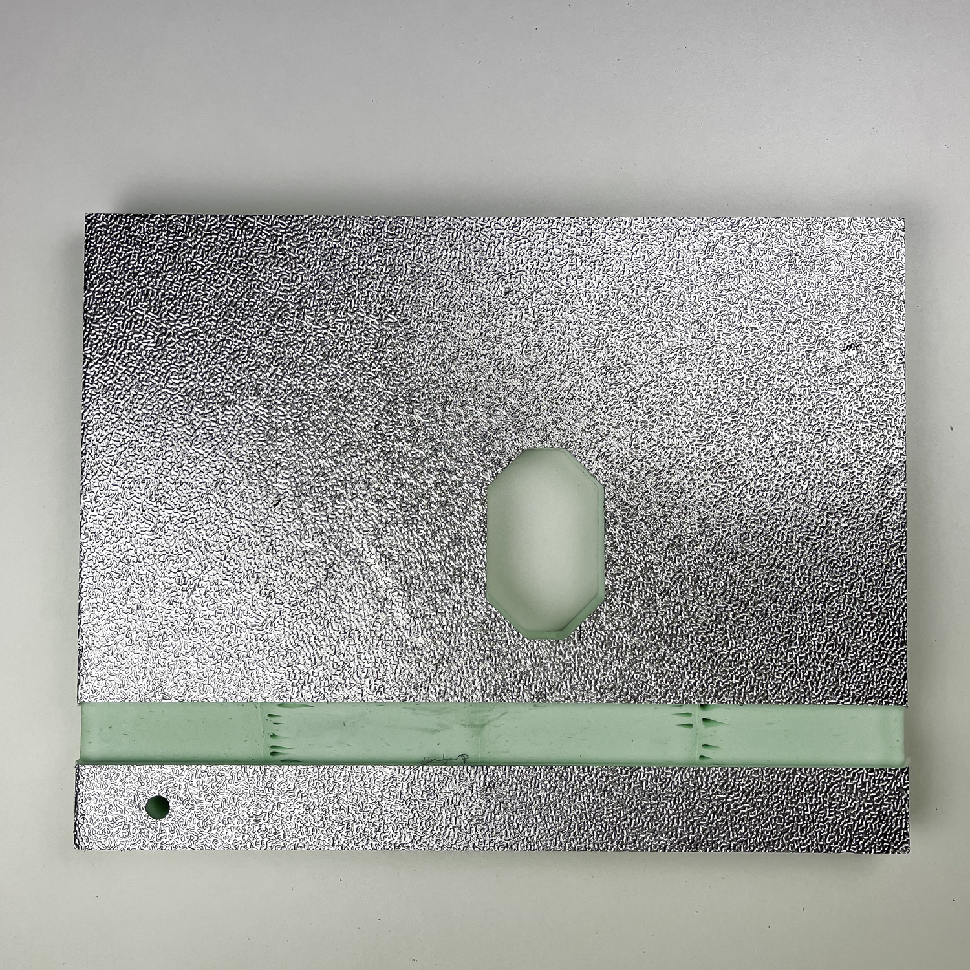
[picture p49: docs/img/pir-box-v3/IMG_2928.jpg]

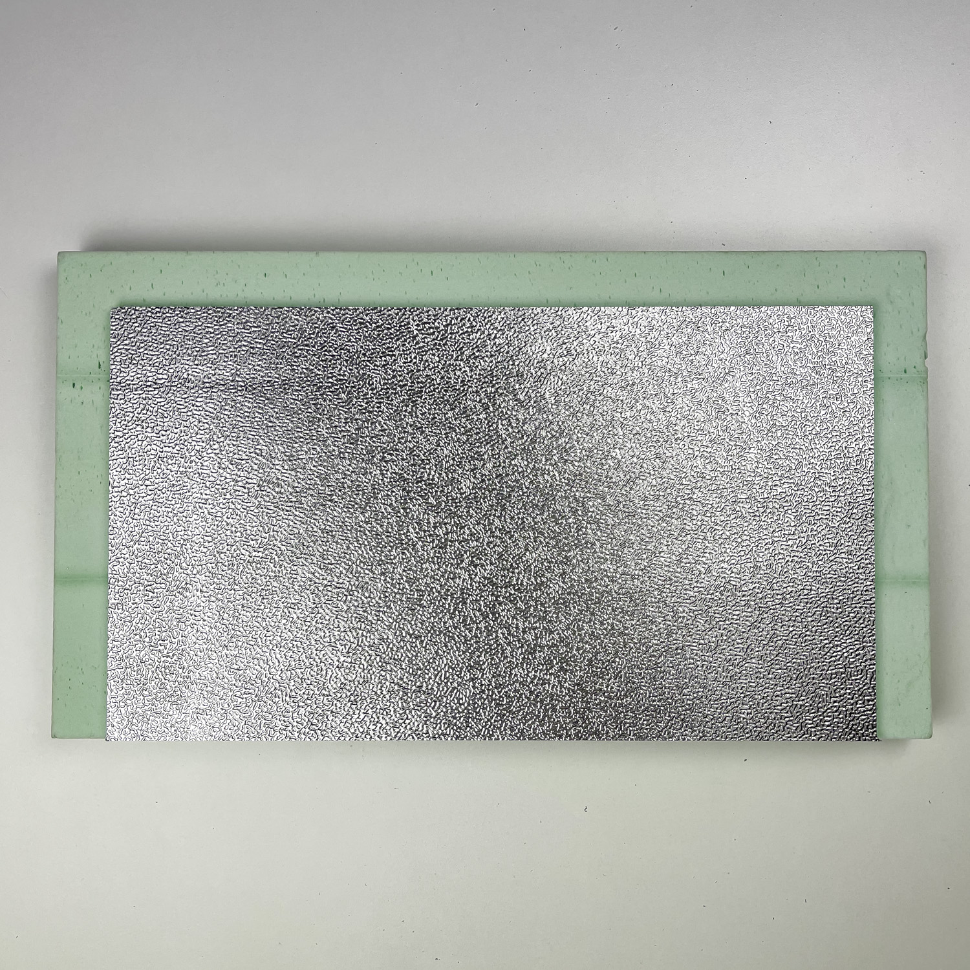
[picture p50: docs/img/pir-box-v3/IMG_2929.jpg]


## Package Contents

Supplied as a KIT set
- [KIT x2](https://store.idryer.org/product/diy-%d1%81%d1%83%d1%88%d0%b8%d0%bb%d0%ba%d0%b0-%d1%84%d0%b8%d0%bb%d0%b0%d0%bc%d0%b5%d0%bd%d1%82%d0%b0-idryer-x2-%d0%bf%d0%be%d0%bb%d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)
- [KIT x3](https://store.idryer.org/product/diy-%d1%81%d1%83%d1%88%d0%b8%d0%bb%d0%ba%d0%b0-%d1%84%d0%b8%d0%bb%d0%b0%d0%bc%d0%b5%d0%bd%d1%82%d0%b0-idryer-x3-%d0%bf%d0%be%d0%bb%d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)
- [KIT x4](https://store.idryer.org/product/diy-%d1%81%d1%83%d1%88%d0%b8%d0%bb%d0%ba%d0%b0-%d1%84%d0%b8%d0%bb%d0%b0%d0%bc%d0%b5%d0%bd%d1%82%d0%b0-idryer-x4-%d0%bf%d0%be%d0%bb%d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)

[Assembly video for KIT set](https://www.youtube.com/playlist?list=PLv8eJa-BRh3z09ve9bOKYYc3aWBMgUUt0)
