pavluchenkor/iDryer-X/docs/ru/v3/kit.md

# KIT



KIT набор iDryer v3 включает необходимые для самостоятельной сборки контроллера iDryer элементы, печатную плату, экран, энкодер и датчики, фрезерованные PIR панели для сборки в L-паз и шип-паз, металлические элементы пола и катушкодержателей.
Все электронные компоненты выводные и крупные, удобны для сборки новичками и продвинутым любителями.

Как в собранном виде так и в виде набора для самостоятельной сборки.

[Состав коробки с электроникой](https://youtube.com/shorts/1hu8ouUc0jI?si=bNsCUIabV3f5F1-T)

[Сборка сушилки iDryer](https://www.youtube.com/watch?v=QL7AUkCoISA&list=PLv8eJa-BRh3z09ve9bOKYYc3aWBMgUUt0&index=1)

KIT

!!! note "Состав KIT полный"

    - Печатная плата
    - ARDUINO_NANO
    - OLED-128X64-I2C
    - Rotary Encoder EC11
    - Сервопривод SG-90 180 градусов
    - DC-DC Step Down MP1584
    - HX711
    - BME-280
    - Thermostat NC 130C
    - BLS-4 2.54mm 30cm
    - BLS-5 2.54mm 30cm
    - XH-4P-2.54 30cm
    - Термистор
    - HLK-10M12
    - PTC керамический нагреватель (или) используется в сборке PIR
    - Кулер 7530
    - CD74HC4052E
    - MOC3023
    - 814
    - Active Buzzer 5V
    - Выключатель
    - 2А 250В
    - BT137-600E
    - N Channel FET IRF840
    - Filter 10MH
    - 0.1uF 280V
    - 220uF 16-25V
    - 10uF 5-16V
    - 1N4007
    - 51K 2W
    - 10K
    - 4,7K
    - 1K
    - 220
    - XH-4P-2.54
    - XH-2P-2.54
    - KF128L-5.08-4P
    - DB301V-3.5-2P
    - PLS-5 (encoder)
    - PLS-4 (oled)
    - PLS-3 (servo)
    - 100K 5% 3950
    - Rotary encoder ЕС11
    - GY-BME280-5В
    - Delta 7530 BFB0712H
    - Нагреватель 220V/100W
    - KSD9700 130C
    - XH2.54 4P
    - Dupont 4P 30cm разъем на проводе
    - Dupont 5P 30cm разъем на проводе
    - Серво SG90 180
    - KF128 5.08/4P
    - Панели корпуса
    - Пол  металлический
    - Качеля катушкоджателя металлическая
    - Трубка алюминиевая 10х1 86мм
    - Подшипник 623
    - Тензодатчик
    - Фиттинг
    - Кабель с вилкой

[Заказать кит](https://store.idryer.org/)
