pavluchenkor/iDryer-X/docs/ru/v3/pir-box-cad.md

# Детали для печати

Скачайте необходимы детали и удостоверьтесь, что печатаете все необходимые детали

!!! note "Детали в формате 3mf"

    [iDryer_set1.3mf](../../../CAD/v3/iDryer_set1.3mf)

    [iDryer_set2.3mf](../../../CAD/v3/iDryer_set2.3mf)

    [LogoPlate.3mf](../../../CAD/v3/LogoPlate.3mf)

    [клипсы.3mf](../../../CAD/v3/clips.3mf)

    [панель_х2.3mf](../../../CAD/v3/panel_x2.3mf)

    [панель_х3.3mf](../../../CAD/v3/panel_x3.3mf)

    [панель_х4.3mf](../../../CAD/v3/panel_x4.3mf)

## Выбор филамента

Детали корпуса печатаются из ABS или ABS CF или других температуростойких филаментов

## CAD

Так же доступны для скачивания полные сборки корпусов. Воспользуйтесь этими файлами в случае возникновения вопросов о назначении деталей и комплекте для печати.

!!! note "Полная модель корпуса x2"

    [Корпус PIR x2.stp](../../../CAD/v3/x2.stp)

!!! note "Полная модель корпуса x3"

    [Корпус PIR x3.stp](../../../CAD/v3/x3.stp)

!!! note "Полная модель корпуса x4"

    [Корпус PIR x4.stp](../../../CAD/v3/x4.stp)

## Чертежи ПИР-панелей для ЧПУ-резки

Чертежи панелей из ПИР-пенопласта в формате DWG для раскройки на ЧПУ-станке. Перед запуском раскладку деталей необходимо скорректировать в соответствии с размером рабочего стола станка, размером используемой плиты и диаметром фрезы.

!!! note "Чертежи ПИР-панелей (.dwg)"

    [Панели x2 (DWG)](../../../CAD/v3/DWG-PIR/x2.dwg)

    [Панели x3 (DWG)](../../../CAD/v3/DWG-PIR/x3.dwg)

    [Панели x4 (DWG)](../../../CAD/v3/DWG-PIR/x4.dwg)

## Чертежи металлических деталей для лазерной резки

Чертежи металлических деталей в формате DWG для лазерной резки.

!!! note "Металл лазерная резка (.dwg)"

    [Base plate x2 (DWG)](../../../CAD/v3/DWG-LASERCUT/x2.dwg)

    [Base plate x3 (DWG)](../../../CAD/v3/DWG-LASERCUT/x3.dwg)

    [Base plate x4 (DWG)](../../../CAD/v3/DWG-LASERCUT/x4.dwg)

    [Держатель катушки (DWG)](../../../CAD/v3/DWG-LASERCUT/spoolholder.dwg)
