pavluchenkor/iDryer-X/docs/ru/v3/overview.md

# iDryer V3

!!! note 

    адаптирована для работы с iDryerController и iDryerControllerV2

iDryer

## Актуальная версия

### Отличительные особенности

- высокая степень готовности документации
- файлы для самостоятельной фрезеровки и лазерной резки
- высокая степень готовности KIT набора
- детали изготовлены промышленным способом
- полная комплектация набора включает:
    - фрезерованные детали корпуса из ПИР
    - металлические детали пола и катушкодержателей
    - печатаная плата
    - электронные компоненты
    - датчики
    - метизы
    - алюминиевый скотч и уплотнитель для портала двери

### Преимущества
- Максимально адаптированы для самостоятельной сборки
- Открытый [исходный код](https://github.com/pavluchenkor/iDryerController) прошивки
- Открытый [проект электроники](https://oshwlab.com/svet_team/idryer_copy_copy)

[Доступно для покупки в виде набора для самостоятельной сборки](https://store.idryer.org/)
