pavluchenkor/iDryer-X/docs/de/v3/cabinet.md

# Montage

Lesen Sie die folgenden Materialien vor der Montage und machen Sie sich mit den weiteren Schritten vertraut

[Montagevideo Rutube](https://rutube.ru/video/b7bb53ed416722cbda444a9ed7b17bde/)

[Montagevideo Youtube](https://www.youtube.com/watch?v=QL7AUkCoISA&list=PLv8eJa-BRh3z09ve9bOKYYc3aWBMgUUt0&ab_channel=iDryer)

## Montage der PIR-Paneele

Überprüfen Sie alle Teile und verbinden Sie sie ohne Klebstoff

Bereiten Sie das Bodenteil wie im Bild gezeigt vor

Vorbereitung des iDryer-Bodenteils

Vorbereitung des Bodenteils

Oder verwenden Sie einen drehbaren Einsatz aus der Datei [iDryer_set2.3mf](../../../CAD/v3/iDryer_set2.3mf). Für die Installation muss das Bodenteil nicht unter einem Winkel zugeschnitten werden, es genügt, das fehlende Rechteck in dem gefrästen Luftkanal auszuschneiden. Der Abstand vom Rand des Bodenteils sollte 5 mm betragen (Nutentiefe in der Rückwand)

iDryer

Für die Montage wird ein Spatel aus dem Satz der gedruckten Teile und hitzebeständiger Dichtstoff benötigt

Tragen Sie den Dichtstoff auf die Teile auf

Vorbereitung der iDryer-Teile zur Montage

Glätten Sie mit dem Spatel

Vorbereitung der iDryer-Teile zur Montage

Montieren Sie die Box

Vorbereitung der iDryer-Teile zur Montage

Ziehen Sie alle Seiten der Box mit Abdeckband zusammen

Vorbereitung der iDryer-Teile zur Montage

Kleben Sie den Stöpsel und das gedruckte Teil auf

Vorbereitung der iDryer-Teile zur Montage

Vorbereitung der iDryer-Teile zur Montage

Vorbereitung der iDryer-Teile zur Montage

Lassen Sie den Dichtstoff aushärten

## Kleben mit Band

Kleben Sie die Endflächen mit Aluminiumband ab

Verwenden Sie zum Markieren eine Markiervorrichtung

iDryer mit Band abkleben

iDryer mit Band abkleben
