pavluchenkor/iDryer-X/docs/ru/v3/cabinet.md

# Сборка

Перед сборкой ознакомьтесь с данными материалами и составьте представление о дальнейших действиях

[Видео сборки Rutube](https://rutube.ru/video/b7bb53ed416722cbda444a9ed7b17bde/)

[Видео сборки Youtube](https://www.youtube.com/watch?v=QL7AUkCoISA&list=PLv8eJa-BRh3z09ve9bOKYYc3aWBMgUUt0&ab_channel=iDryer)

## Сборка PIR панелей

Проверьте все детали и соедините их без клея

Подготовьте деталь пола как показано на картинке

Подготовка детали пола iDryer

Подготовка детали пола

Или воспользуйтесь поворотной вставкой из файла [iDryer_set2.3mf](../../../CAD/v3/iDryer_set2.3mf), для установки деталь пола подрезать под углом не нужно, достаточно вырезать недостающий прямоугольник в фрезерованном воздуховоде. Отступ от края детали пола должен быть 5мм(глубина паза в задней стенке)

iDryer

Для сборки потребуется шпатель из комплекта печатных деталей и термостойкий герметик

Нанесите герметик на детали

Подготовка деталей iDryer к сборке

Разровняйте шпателем

Подготовка деталей iDryer к сборке

Соберите коробку

Подготовка деталей iDryer к сборке

Стяните малярным скотчем все стороны коробки

Подготовка деталей iDryer к сборке

Приклейте заглушку и печатаную деталь

Подготовка деталей iDryer к сборке

Подготовка деталей iDryer к сборке

Подготовка деталей iDryer к сборке

Дайте герметику время затвердеть

## Оклейка скотчем

Оклейте торцевые участки алюминиевым скотчем.

Для разметки воспользуйтесь разметочным рейсмусом

Оклейка iDryer скотчем

Оклейка iDryer скотчем
