pavluchenkor/iDryer-X/docs/ru/v3/load-cell-connect.md

# Подключение тензодатчиков

Для корректной работы системы взвешивания в iDryer требуется правильно подключить провода от тензодатчика к модулю HX711. Следуйте приведённой ниже инструкции.

## Структура подключения

В системе используются тензодатчики только с четырьмя проводами. Как правило, цветовая схема следующая:

- **Красный**: питание + (Excitation+, E+)
- **Черный**: питание - (Excitation-, E-)
- **Зеленый**: выход сигнала + (Signal+, A+)
- **Белый**: выход сигнала - (Signal-, A-)

## Схема подключения к модулю HX711

| Провод от тензодатчика | Контакт на модуле HX711 |
|:---|:---|
| Красный (E+) | E+ |
| Черный (E-) | E- |
| Зеленый (A+) | A+ |
| Белый (A-) | A- |

## Методика проверки проводов с помощью мультиметра

Если вы не уверены в цветах проводов, можно определить назначение с помощью мультиметра:

**Установите мультиметр в режим измерения сопротивления (Ом)**.

**Найдите пары проводов с близким сопротивлением**:

- Измерьте сопротивление между всеми возможными парами проводов.
- Найдите две пары проводов, между которыми сопротивление составляет около 350-450 Ом (для большинства стандартных тензодатчиков).

**Определение цепей**:

- Одна пара  - это питание (Excitation+, Excitation-).
- Другая пара - это сигнальные выходы (Signal+, Signal-).
- Как правило, черный и красный это gnd и питание соответственно

**Как определить какой провод A+, а какой A-**:

- Подключите мультиметр в режим измерения милливольт постоянного тока (mV DC).
- Подключите питание  5В к паре питающих проводов (например, от DC-DC преобразователя платы контроллера).
- Подключите щупы мультиметра к сигнальной паре.
- Если напряжение положительное, то провод к которому подключен красный щуп это и есть А+, если напряжение отрицательное, поменяйте местами щупы.
Дополнительно:
- Надавите на тензодатчик.
- Если при нажатии на тензодатчик напряжение на мультиметре увеличивается, тот провод, который подключён к красному щупу мультиметра, является A+.
- Если напряжение уменьшается (уходит в минус), поменяйте щупы местами.

## Порядок действий при подключении

- **Определите назначение каждого провода**, используя методику, описанную выше.
- **Подготовьте провода**: очистите концы от изоляции на 3-5 мм.
- **Припаяйте провода к плате HX711** в соответствии с таблицей подключения.
- **Соблюдайте правильную нумерацию тензодатчиков в соответствии с маркировкой на плате**
- **Проверьте качество пайки**: убедитесь в отсутствии замыканий между соседними контактами.

## Важные замечания

- В устройстве используются только четырёхпроводные тензодатчики.
- Неверное подключение может привести к некорректной работе весов или повреждению модулей.
- После подключения необходимо выполнить калибровку весов через меню устройства. Для этого перейдите в режим калибровки весов и следуйте указаниям на экране.
- при перезаписи EEPROM калибровка весов выполняется заново.
