pavluchenkor/iDryer-X/docs/ru/v3/load-cell.md

# Пол и катушкодержатели

Металлические детали пола и катушкодержателей

iDryer
iDryer
iDryer
iDryer

## Установка тензодатчиков

Используются тензодатчики на 5кг. Тензодатчики устанавливаются стрелкой вниз.

Зазор

Необходимо задать зазор шайбами между полом и тензодатчиком таким образом чтобы компаунд, под которым находится тензо резистор, не прикасался к полу

Зазор

В зависимости от модели производителя датчика, для крепления к полу могут применяться винты и М5 и М4 длина 20мм, крепление катушкодержателя чаще всего 4мм, длина винта 16-20мм

Зазор между катушкодержателем и полом задается печатными проставками или шайбами и должен быть 2-4мм и не препятствовать свободному перемещению катушкодержателя под весом катушки

Зазор

## Проводка

Провода проводятся в подвал через проколы в пазах для тензодатчиков. Проколы со стороны подвала закрываются алюминиевым скотчем.
