pavluchenkor/iDryer-X/PDF/v2/cut_plan_x2.pdf

Результаты раскроя ••• Cutting 3 • Версия 1.50, ноябрь, 2008 • 27.03.2024 17:52:46 | Стр. 1

1.160 0.560

0.547 0.847 0.268 0.000

0.000 0.250

Лист №: 1 (1) Количество копий: 1 Материал: Silver Размер: 1.160 x 0.560 m.
Площадь листа: 0.650 sq.m. Количество деталей: 6 Отходы: 0.245 (37.7%) Маркированные остатки: 0.000 (0.0%) Длина реза: 0.000 m. Заметки:

### Детали

№ 4 300x250 Кол-во: 2 (2) боковина | № 5 300x208 Кол-во: 1 (1) зад
№ 3 268x250 Кол-во: 1 (1) верх | № 2 268x297 Кол-во: 1 (1) дверь

### № 1 208x220 Кол-во: 1 (1) пол

4

300 250

боковина

4

300 250

боковина

5

300 208

зад

3

250 268 | верх

2

297 268

дверь | 1
220 208

пол
