pavluchenkor/iDryer-X/PDF/v2/cut_plan_x3.pdf

Результаты раскроя ••• Cutting 3 • Версия 1.50, ноябрь, 2008 • 27.03.2024 17:50:13 | Стр. 1

1.160 0.560

0.250 0.300 0.000 250 300 боковина | 368 297 2 дверь | 308 300 зад
368 250 3 верх | 300 250 4 боковина | 308 220 1 пол

0.000 0.618

Лист №: 1 (1) Количество копий: 1 Материал: Silver Размер: 1.160 x 0.560 m.
Площадь листа: 0.650 sq.m. Количество деталей: 6 Отходы: 0.138 (21.3%) Маркированные остатки: 0.000 (0.0%) Длина реза: 0.000 m. Заметки:

### Детали

№ 2 368x297 Кол-во: 1 (1) дверь | № 3 368x250 Кол-во: 1 (1) верх
№ 4 300x250 Кол-во: 2 (2) боковина | № 5 300x308 Кол-во: 1 (1) зад

### № 1 308x220 Кол-во: 1 (1) пол

4

5
