pavluchenkor/iDryer-X/PDF/v2/cut_plan_x4.pdf

Результаты раскроя ••• Cutting 3 • Версия 1.50, ноябрь, 2008 • 27.03.2024 17:42:38 | Стр. 1

1.160 0.560

0.250 0.300 0.000 250 300 | 468 297 2 | 408 300 5
408 220 1 | 468 250 3

0.000 0.718

Лист №: 1 (1) Количество копий: 1 Материал: Silver Размер: 1.160 x 0.560 m.
Площадь листа: 0.650 sq.m. Количество деталей: 5 Отходы: 0.106 (16.4%) Маркированные остатки: 0.000 (0.0%) Длина реза: 0.000 m. Заметки:

### Детали

№ 2 468x297 Кол-во: 1 (1) | № 1 408x220 Кол-во: 1 (1)
№ 3 468x250 Кол-во: 1 (1) | № 4 300x250 Кол-во: 1 (1)

### № 5 300x408 Кол-во: 1 (1)

4

Результаты раскроя ••• Cutting 3 • Версия 1.50, ноябрь, 2008 • 27.03.2024 17:42:38 | Стр. 2

1.160 0.560 0.000

0.000

Лист №: 1 (2) Количество копий: 1 Материал: Silver Размер: 1.160 x 0.560 m.
Площадь листа: 0.650 sq.m. Количество деталей: 1 Отходы: 0.575 (88.5%) Маркированные остатки: 0.000 (0.0%) Длина реза: 0.000 m. Заметки:

### Детали № 4 300x250 Кол-во: 1 (1)

4

250 300
