pavluchenkor/iDryer-X/PDF/v2/cut_plan_x4_single_sheet.pdf

Результаты раскроя ••• Cutting 3 • Версия 1.50, ноябрь, 2008 • 27.03.2024 17:57:12 | Стр. 1

1.160 0.560 0.300 0.000

0.000 | 0.250 | 0.718

Лист №: 1 (1) Количество копий: 1 Материал: Silver Размер: 1.160 x 0.560 m.
Площадь листа: 0.650 sq.m. Количество деталей: 7 Отходы: 0.031 (4.8%) Маркированные остатки: 0.000 (0.0%) Длина реза: 0.000 m. Заметки:

### Детали

№ 6 260x250 Кол-во: 1 (1) боковина 2 склеить | № 4 300x250 Кол-во: 1 (1) боковина
№ 1 408x220 Кол-во: 1 (1) пол | № 3 468x250 Кол-во: 1 (1) верх
№ 5 300x408 Кол-во: 1 (1) зад | № 2 468x297 Кол-во: 1 (1) дверь

### № 7 40x250 Кол-во: 1 (1) боковина 1 склеить

6

4

250 300 боковина | 468 297 2 дверь | 408 300 зад
250 260 боковина 2 склеить | 468 250 3 верх | 408 220 1 пол

5

боковина 1 склеить18
