pavluchenkor/iDryer-X/docs/de/v1/alternative-case.md

# Gehäuse aus EPP

Trocknungsgehäuse aus EPP (extrudiertes Polypropylen)

Polypropylen hat eine geringe Feuchtigkeitsaufnahme. Es ist durch gute elektroiusolierungseigenschaften in einem breiten Temperaturbereich gekennzeichnet.
Maximale Betriebstemperatur: 120 °C
Es gibt ein breites Sortiment an vorgefertigten Boxen verschiedener Größen auf dem Markt.

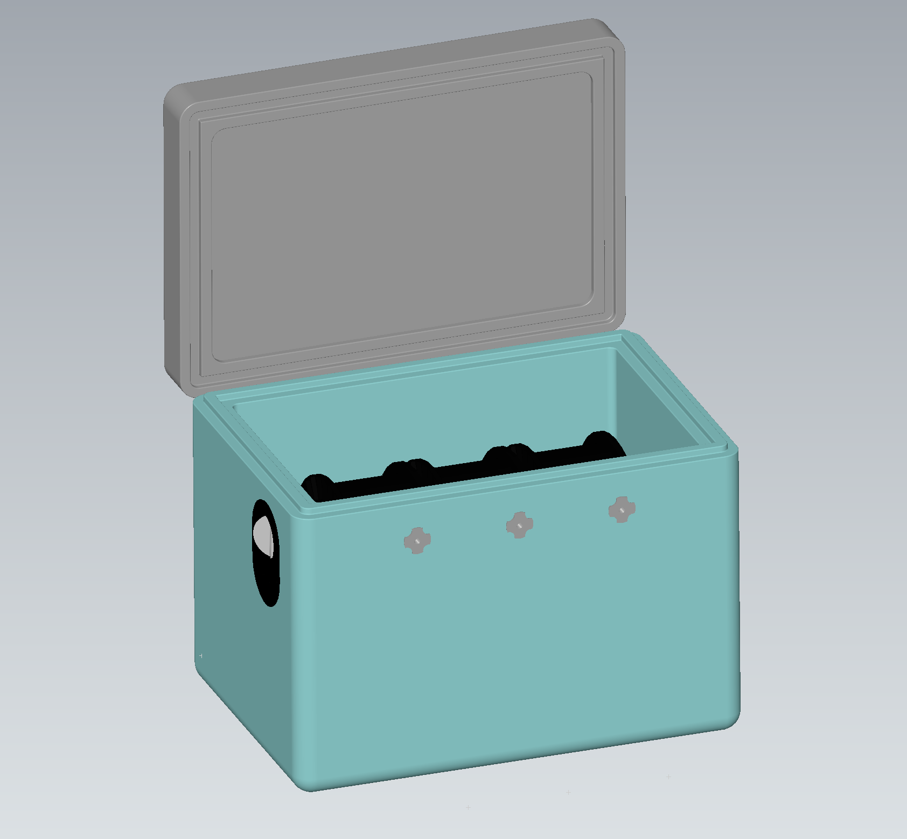
[picture p52: docs/img/alternative-case/alternativeCase1.png]


Diskussion hier

[Gruppe](https://t.me/iDryer){ .md-button }

[Diskussion 2 ](https://t.me/iDryer/2175)

[Diskussion 3 ](https://t.me/iDryer/2304)

[Diskussion 4 ](https://t.me/iDryer/1244)

[Diskussion 5 ](https://t.me/iDryer/1244)
