pavluchenkor/iDryer-X/docs/de/v1/heater.md

# Heizer mit Kühler
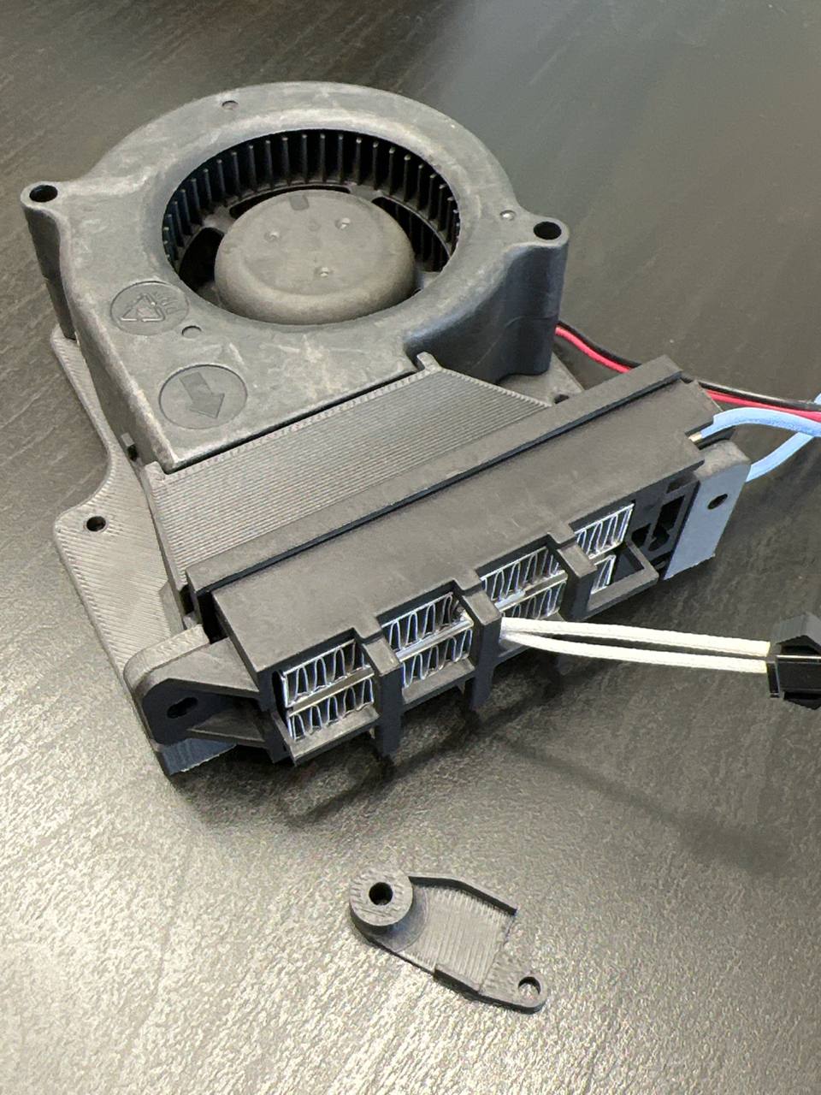
[picture p53: docs/img/heater/photo_2023-09-15_15-37-05.jpg]
Auslegung


Modul von [@gungrel](https://t.me/gungrel)

!!! note "Druckdateien"

    [BME280-Halterung.stl](../../../CAD/common/heater/mount_bme280.stl)

    [PTC-Heizer-Modul 100W 220V 7530 7525.stp](../../../CAD/common/heater/PTC_100W_220V_7530_7525.stp)

## Komponenten kaufen

[Lüfter für das Modul auf AliExpress](https://aliexpress.ru/item/1691802504.html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)

[2 Lüfter für das Modul auf AliExpress](https://aliexpress.ru/item/1005002255060284.html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)

[Heizelement auf AliExpress](https://aliexpress.ru/item/32319632955.html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)
