pavluchenkor/iDryer-X/docs/de/v1/pcb-case.md

# Gehäuse des Controllers r2

Laden Sie die beiden Dateien herunter und drucken Sie diese aus [entwickelt von @gungrel](https://t.me/gungrel)

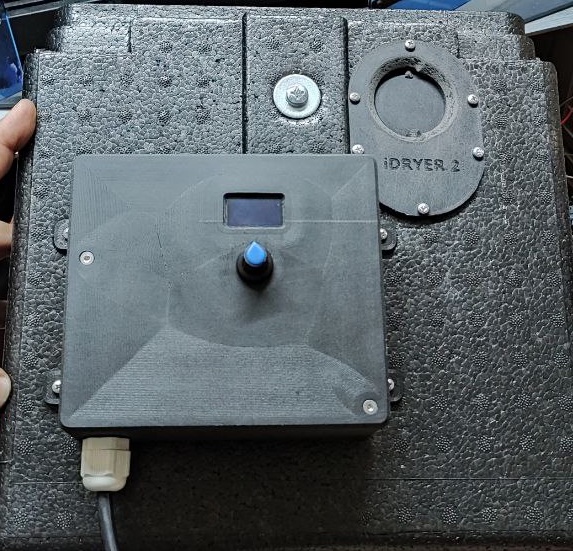
[picture p54: docs/img/pcb-case/Assembly_ebox.jpg]
Assembly ebox

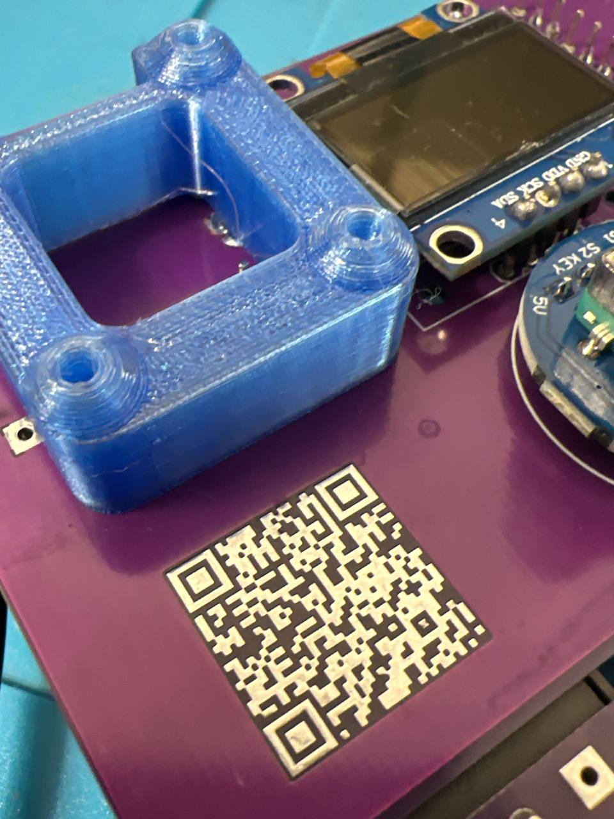
[picture p55: docs/img/pcb-case/screen_stand.jpg]
screen stand


## Dateien

!!! note "Druckdateien"

    [iDryer v1 prototype](../../../CAD/common/pcb-case/Assembly_ebox.stp) - Gehäuse

    [iDryer v2](../../../CAD/common/pcb-case/screen_stand.stp) - Bildschirmabstandshalter
