pavluchenkor/iDryer-X/docs/de/v1/pcb-r2.md

# Leiterplatte

## r2

***Veraltete Version ohne Waage, Filamentendschalter, aber mit Unterstützung für 24V-Heizer***

!!! warning annotate "Download-Dateien r2"

    PCB Design r2 
    [oshwlab](https://oshwlab.com/svet_team/idryer) 
    [easyeda](https://easyeda.com/editor#project_id=2e5c7e9f855c4382b6348d0dd1a322dc)

    Stückliste für den manuellen Zusammenbau r2 [google docs](https://docs.google.com/spreadsheets/d/13WdUZXiJUIk1PS-rFiE8_W3LRcMZVskWiTUnrRRYlAE/edit?usp=sharing)

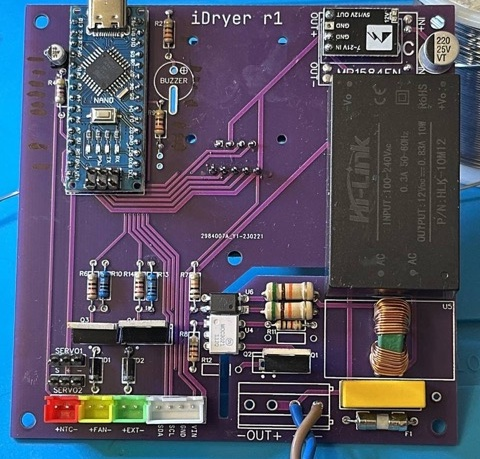
[picture p56: docs/img/pcb-r2/photo_2023-09-15_15-46-01-web.jpeg]


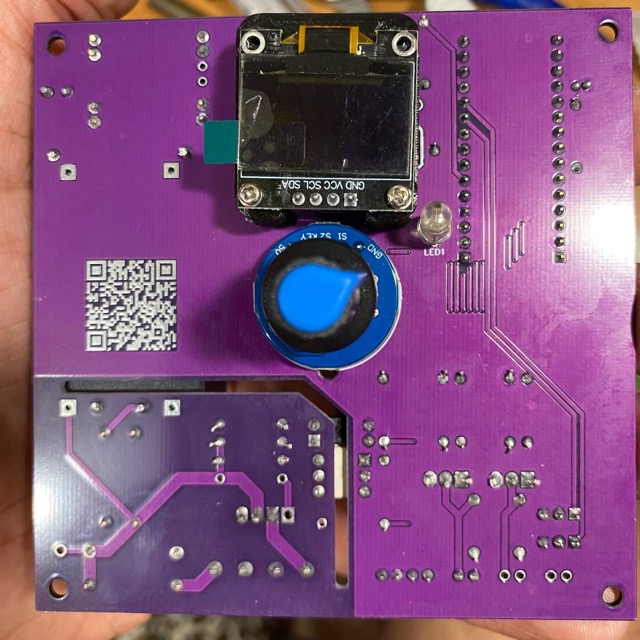
[picture p57: docs/img/pcb-r2/photo_2023-09-15_15-45-55-web.jpeg]


Weitere Fotos können Sie in unserer Telegram-Gruppe in diesem Beitrag ansehen:
[Zusammenbauergebnis eines Gruppenmitglieds](https://t.me/iDryer/3103)
