pavluchenkor/iDryer-X/docs/de/v2/pir.md

# Vorteile von PIR

PIR-Platte ist ein kostengünstiges und leicht erhältliches Material für die Herstellung des Trocknergehäuses.

### Vorteile
- Preis
- Bearbeitungskomfort und Einfachheit
- akzeptables Aussehen
- Wärmeleitfähigkeit zählt zu den niedrigsten unter Dämmstoffen
- Keine Abgabe schädlicher Stoffe beim Erhitzen

### Nachteile
- Kann durch Stoßbelastung verformt werden

Dies macht PIR-Platten insgesamt zu einem geeigneten Material für die Verwendung als Trocknergehäuse sowie als Wärmeisolierung der aktiven Thermokammer.
