pavluchenkor/iDryer-X/docs/de/v2/x3.md

# iDryer x3 Filamenttrockner

## Merkmale

- Anzahl der Spulen: 3
- Trocknungstemperatur: bis 110 °C
- Heizerkontrolle der Temperatur: ja
- Kammerlufttemperaturkontrolle: ja
- Trocknungszeit: unbegrenzt
- Erzwungene Belüftung: ja
- Filamentwägung: ja
- Voreinstellungen: ja
- Filamenttypen: PLA, ABS, HIPS, PETG, SBS, Flex, PA6, PA12, PC, ABS, ASA, PP, POM und weitere

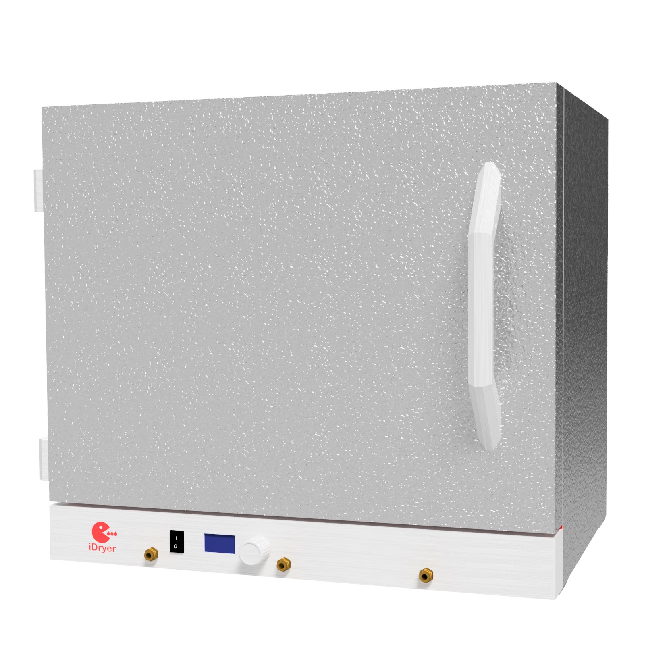
[picture p85: docs/img/x3/x3_1.jpg]

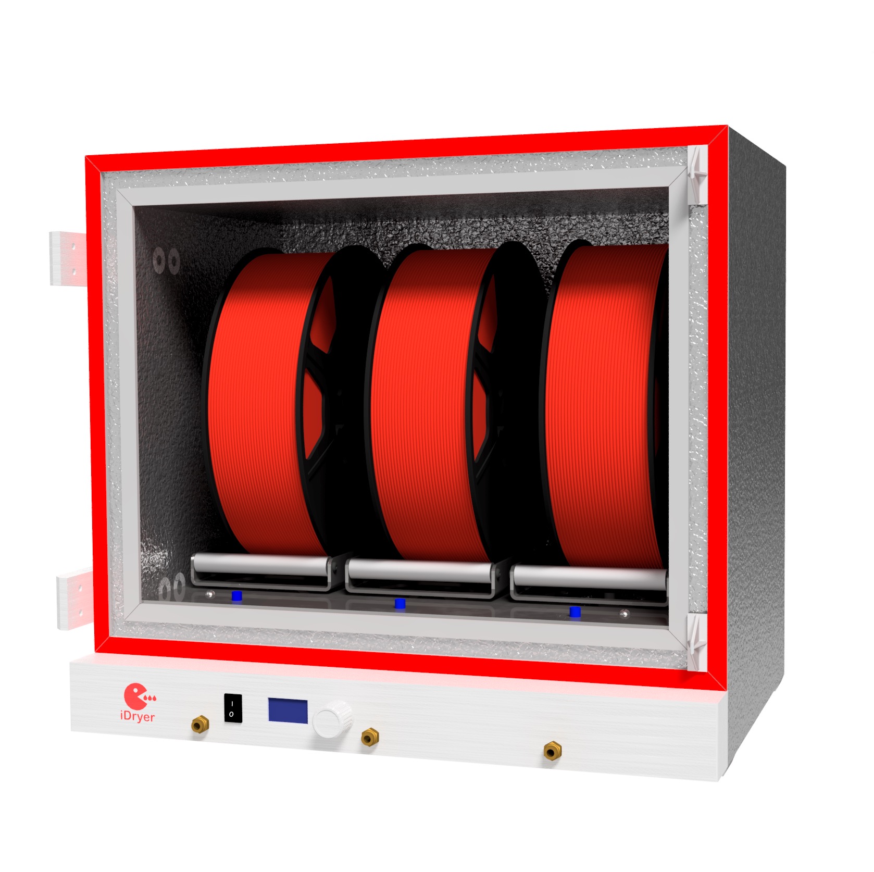
[picture p86: docs/img/x3/x3_2.jpg]

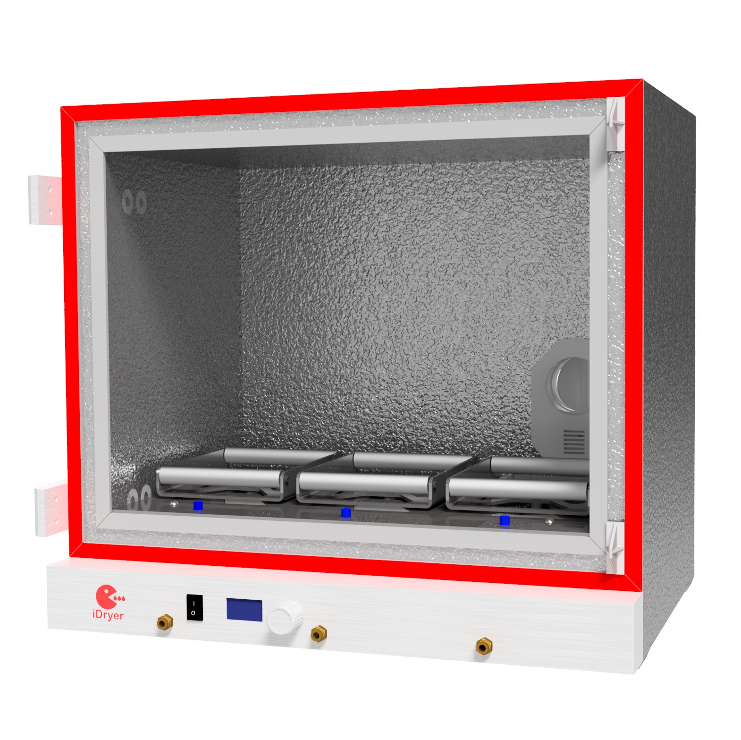
[picture p87: docs/img/x3/x3_3.jpg]


!!! info "Komplettes Gehäusemodell"

    [Gehäuse PIR x3](../../../CAD/v2/PIRx3.stp)

    Material der gedruckten Teile - ABS oder ABS CF

!!! note "Schnittplan"

    [Schnittplan](../../../PDF/v2/cut_plan_x3.pdf)

!!! warning "Wichtig"

    Alle Teile im Inneren des Gehäuses müssen aus Materialien gedruckt werden, die 100 °C und höher aushalten.

    Der Luftkanal im Trocknerkellerraum muss isoliert werden. Die Wärmeisolierung des Luftkanals im x3-Projekt dient zu Demonstrationszwecken und kann in derselben Form verwendet oder mit beliebigem Wärmeisoliermaterial beklebt werden. Wenn dies nicht erfolgt, wird die Aufheizgeschwindigkeit reduziert und der Stromverbrauch wird erheblich erhöht!
