pavluchenkor/iDryer-X/docs/en/v1/air-damper-v0.md

# Damper


(*original damper prototype*)

## Final Version

The final version of the chamber ventilation damper. This model is designed for enclosures with a 30mm wall thickness. However, by adjusting the thickness of the "Diffuser" part, it can be adapted to any housing. Installation is simplified-only a hexagonal through-hole needs to be cut. The diffuser is printed with minimal infill, providing effective thermal insulation.

!!! quote annotate "CAD files [by @gungrel](https://t.me/gungrel)"

    :material-download:</i> **[Damper Final.stp](../../../CAD/common/air-damper-air-damper-v0/damper_final.stp)**

## Older Version

Designed for regular chamber ventilation.

Requires purchase of [SG90 9g servo motor](https://aliexpress.ru/item/32962841728.html?sku_id=66666348213&spm=.search_results.16.6c0b4aa6tK2QUa)

!!! quote annotate "CAD files [by @gungrel](https://t.me/gungrel)"

    :material-download:</i> **[air damper.stp](../../../CAD/common/air-damper-air-damper-v0/air_damper.stp)** - air damper.stp

!!! quote annotate "Printable files"

    :material-download:</i> **[air_damper_back.stl](../../../CAD/common/air-damper-air-damper-v0/STL/air_damper_back.stl)**

    :material-download:</i> **[air_damper_diffuser.stl](../../../CAD/common/air-damper-air-damper-v0/STL/air_damper_diffuser.stl)**

    :material-download:</i> **[air_damper_flap.stl](../../../CAD/common/air-damper-air-damper-v0/STL/air_damper_flap.stl)**

    :material-download:</i> **[air_damper_front.stl](../../../CAD/common/air-damper-air-damper-v0/STL/air_damper_front.stl)**

<!-- [![Telegram](https://img.shields.io/badge/Telegram-Join%20Group-blue)](https://t.me/iDryer)  [![YouTube](https://img.shields.io/badge/YouTube-Watch%20video-red)](https://www.youtube.com/@iDryerProject) [![Rutube](https://img.shields.io/badge/Rutube-Watch%20video-blue)](https://rutube.ru/channel/34401569/) -->
