pavluchenkor/iDryer-X/docs/en/v1/pcb-case.md

# Controller Enclosure r2

Download and print the two files [designed by @gungrel](https://t.me/gungrel):

<div class="image-container">
  <div class="custom-image">
    spool holder
  </div>
  <div class="custom-image">
    spool holder
  </div>
</div>

## Files

!!! quote annotate "Printable Files"

    :material-download:</i> **[iDryer v1 prototype](../../../CAD/common/pcb-case/Assembly_ebox.stp)** - Enclosure

    :material-link:</i>** [iDryer v2](../../../CAD/common/pcb-case/screen_stand.stp)** - Screen stand

<!-- [![Telegram](https://img.shields.io/badge/Telegram-Join%20Group-blue)](https://t.me/iDryer)  [![YouTube](https://img.shields.io/badge/YouTube-Watch%20video-red)](https://www.youtube.com/@iDryerProject) [![Rutube](https://img.shields.io/badge/Rutube-Watch%20video-blue)](https://rutube.ru/channel/34401569/) -->
