pavluchenkor/iDryer-X/docs/en/v1/pir-box.md

# PIR Enclosure

PIR boards are a cheap and accessible material for building the iDryer enclosure.

## Advantages

* Low cost
* Easy and simple to work with
* Decent appearance
* Among the lowest thermal conductivity among insulation materials
* No harmful emissions when heated

## Disadvantages

* Can deform from impact

<div class="image-container">
  <div class="custom-image">
    iDryer enclosure assembly
  </div>
  <div class="custom-image">
    iDryer enclosure assembly
  </div>
</div>

<div class="image-container">
  <div class="custom-image">
    iDryer enclosure assembly
  </div>
  <div class="custom-image">
    iDryer enclosure assembly
  </div>
</div>

<div class="image-container">
  <div class="custom-image">
    iDryer enclosure assembly
  </div>
  <div class="custom-image">
    iDryer enclosure assembly
  </div>
</div>

iDryer

!!! quote annotate "Full enclosure model"

    :material-download:</i> **[PIR_box_assembly_r2_1.stp](../../../CAD/v1/PIR_box_assembly_r2_1.stp)** - Among the most cost-effective optimal materials is ABS CF10, which is easy to print, doesn't require an enclosure, and performs well at the dryer’s working temperature. Both the spool holders and the air duct with the heater are printed from ABS CF10.

!!! warning annotate "Important"

    All internal parts of the enclosure must be printed from materials that can withstand 100°C or higher.

## Fabrication (\~60 minutes)

* Review the images
* Print the cutting plan file
* Print the knife fixture file
* Mark the sheet
* Cut the parts
* Bevel edges where needed
* Glue the parts (use dedicated PIR panel adhesive foam or any polyurethane-based glue)
* Seal edges and joints with aluminum tape
* Print the hinges, attach them with thin double-sided tape to the body and door, and screw them in with 25-30 mm long, 4-5 mm diameter screws. This method has been tested and proven reliable.

!!! quote annotate "Download files"

    :material-download:</i> **[Knife Fixture.stp](../../../CAD/v1/knife_fixture.stp)** - Knife fixture

    :material-download:</i>** [Cutting Plan.pdf](../../../CAD/v1/cutting_plan.pdf)** - Cutting plan

!!! warning annotate "Important"

    Note! The rear wall is glued from two parts to optimize material usage.

<div class="image-container">
  <div class="custom-image">
    iDryer enclosure assembly
  </div>
  <div class="custom-image">
    iDryer enclosure assembly
  </div>
</div>

<div class="image-container">
  <div class="custom-image">
    iDryer enclosure assembly
  </div>
  <div class="custom-image">
    iDryer enclosure assembly
  </div>
</div>

<div class="image-container">
  <div class="custom-image">
    iDryer enclosure assembly
  </div>
  <div class="custom-image">
    iDryer enclosure assembly
  </div>
</div>

<div class="image-container">
  <div class="custom-image">
    iDryer enclosure assembly
  </div>
  <div class="custom-image">
    iDryer enclosure assembly
  </div>
</div>

<div class="image-container">
  <div class="custom-image">
    iDryer enclosure assembly
  </div>
  <div class="custom-image">
    iDryer enclosure assembly
  </div>
</div>

<!-- [![Telegram](https://img.shields.io/badge/Telegram-Join%20Group-blue)](https://t.me/iDryer)  [![YouTube](https://img.shields.io/badge/YouTube-Watch%20video-red)](https://www.youtube.com/@iDryerProject) [![Rutube](https://img.shields.io/badge/Rutube-Watch%20video-blue)](https://rutube.ru/channel/34401569/) -->
