pavluchenkor/iDryer-X/docs/en/v1/scale-module.md

# Spool Holder



Designed for storing spools and tracking remaining filament, displaying the amount left on screen and signaling through a dedicated output.

## Printable Version

The top part of the module serves as a convenient alternative to existing spool holders.
It uses 694 bearings or equivalents (11x4x4) and a 4mm bronze rod from a hardware store as an axle.
Printed from composite ABS or any filament capable of withstanding the maximum drying temperature + 10-15°C.

You’ll need to purchase a [load cell module and HX711](https://aliexpress.ru/item/32860114708.html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)

Models can be easily adapted for available bearing sizes.

!!! quote annotate "Files for 3D printing"

```
:material-download:</i> **[Narrow Scale.stp](../../../CAD/common/scale-module/scale_narrow.stp)**

:material-download:</i>** [Scale.stp](../../../CAD/common/scale-module/scale.stp)**
```

<div class="image-container">
  <div class="custom-image">
    spool holder
  </div>
  <div class="custom-image">
    spool holder
  </div>
  <div class="custom-image">
    spool holder
  </div>
</div>

<div class="image-container">
  <div class="custom-image">
    spool holder
  </div>
  <div class="custom-image">
    spool holder
  </div>
</div>

## Metal Versions

Several metal versions have been developed by community members.

### By @gungrel

A bent metal spool holder designed for 623 bearings. The base supports 1, 2, 3, or 4 spools. Aluminum tube 12x1mm is used as the roller.

!!! quote annotate "Laser cut and bending model [by @gungrel](https://t.me/gungrel)"

```
:material-download:</i>** [Spool Holder Bending Final.stp](../../../CAD/common/scale-module/spool_holder_bending_final.stp)
```

### Remix [by @Kekht](https://t.me/Kekht)

*based on the earlier design [by @gungrel](https://t.me/gungrel)*

**Modifications:**

Max spool width - 83.6mm

Uses 686 bearings and aluminum tube - outer diameter 15mm, inner 13mm

Printed nylon anchors and M3 screws are used to secure bearings

Anchor hole diameter is 8mm; by changing only the anchors, any bearings or tubes can be used (max tube diameter 23mm)

Anchors are best printed from nylon (pure or composite). After removing screws, rollers detach easily

Side holes allow attaching supports for nonstandard spools (e.g., cardboard or samples)

A spacer for the load cell is included, allowing cable tie routing

Mounting holes for legs (two types) or custom printed brackets (also two variants for different screw types), enabling modular stacking

```
Bending setup:
Radius for 3mm steel - 2.7
Radius for 2mm steel - 1.8
Minimum flange - 14mm
K-factor - 0.44
```

<div class="video-wrapper">
  <iframe width="1280" height="720" src="https://www.youtube.com/embed/iAZZLo_1NXo?si=j_zRWY-Wy7RiXFXJ" frameborder="0" allowfullscreen></iframe>
</div>

!!! quote annotate "Remix [by @Kekht](https://t.me/Kekht) of the original [by @gungrel](https://t.me/gungrel)"

```
:material-download:</i>** [SpoolHolderWeightModule_v1_3_2.STEP](../../../CAD/common/scale-module/SpoolHolderWeightModule_v1_3_2.STEP)

:material-download:</i>** [Rollers_Holder_v1_3.DXF](../../../CAD/common/scale-module/Rollers_Holder_v1_3.DXF)

:material-download:</i>** [Base_Single_v1_2.DXF](../../../CAD/common/scale-module/Base_Single_v1_2.DXF)
```

### Design by Sasha

<div class="image-container">
  <div class="custom-image">
    spool holder
  </div>
  <div class="custom-image">
    spool holder
  </div>
</div>

!!! quote annotate "Milling model"

```
:material-download:</i> **[Sasha.STEP](../../../CAD/common/scale-module/Sasha.STEP)

[designed by Sasha](https://t.me/iDryer/9446)
```

<!-- [![Telegram](https://img.shields.io/badge/Telegram-Join%20Group-blue)](https://t.me/iDryer)  [![YouTube](https://img.shields.io/badge/YouTube-Watch%20video-red)](https://www.youtube.com/@iDryerProject) [![Rutube](https://img.shields.io/badge/Rutube-Watch%20video-blue)](https://rutube.ru/channel/34401569/) -->
