pavluchenkor/iDryer-X/docs/en/v2/pir.md

# Advantages of PIR

PIR panels are a cheap and accessible material for building the dryer enclosure.

### Pros

* Low cost
* Easy to work with and process
* Acceptable appearance
* One of the lowest thermal conductivity values among insulation materials
* Does not emit harmful substances when heated

### Cons

* Can be deformed by impact

All this makes PIR panels a convenient material for use as a dryer enclosure, as well as for insulating an active heated chamber.

<!-- [![Telegram](https://img.shields.io/badge/Telegram-Join%20Group-blue)](https://t.me/iDryer)  [![YouTube](https://img.shields.io/badge/YouTube-Watch%20video-red)](https://www.youtube.com/@iDryerProject) [![Rutube](https://img.shields.io/badge/Rutube-Watch%20video-blue)](https://rutube.ru/channel/34401569/) -->
