pavluchenkor/iDryer-X/docs/en/v2/x2.md

# iDryer x2 Filament Dryer

## Features

* Spool capacity: 2
* Drying temperature: up to 100°C
* Heater temperature control: yes
* Air temperature monitoring in chamber: yes
* Drying time: unlimited
* Forced ventilation: yes
* Filament weighing: yes
* Presets: yes
* Supported filament types: PLA, ABS, HIPS, PETG, SBS, Flex, PA6, PA12, PC, ABS, ASA, PP, POM, and others

iDryer x2
iDryer x2
iDryer x2

!!! quote annotate "Full enclosure model"

    **[PIR Enclosure x2.stp](../../../CAD/v2/PIRx2.stp)**

    Recommended material for printed parts - ABS or ABS CF

!!! quote annotate "Cutting Plan"

    **[cut_x2.pdf](../../../PDF/v2/cut_plan_x2.pdf)**

!!! warning annotate "Important"

    All internal parts of the enclosure must be printed from materials that can withstand 100°C or higher.

    The air duct in the lower compartment must be insulated. The insulation solution used in the x4 project is provided for reference and can be reused as-is or replaced with any thermal insulation material. If not insulated, warm-up time will increase significantly and power consumption will rise.

<!-- [![Telegram](https://img.shields.io/badge/Telegram-Join%20Group-blue)](https://t.me/iDryer)  [![YouTube](https://img.shields.io/badge/YouTube-Watch%20video-red)](https://www.youtube.com/@iDryerProject) [![Rutube](https://img.shields.io/badge/Rutube-Watch%20video-blue)](https://rutube.ru/channel/34401569/) -->
