pavluchenkor/iDryer-X/docs/en/v2/x4.md

# iDryer x4 Filament Dryer

## Features

* Number of spools: 4
* Drying temperature: up to 100°C
* Heater temperature control: yes
* Air temperature control in the chamber: yes
* Drying time: unlimited
* Forced ventilation: yes
* Filament weighing: yes
* Presets: yes
* Supported filament types: PLA, ABS, HIPS, PETG, SBS, Flex, PA6, PA12, PC, ABS, ASA, PP, POM, and others

iDryer x4
iDryer x4
iDryer x4

!!! quote annotate "Full Enclosure Model"

    **[PIR x4 Enclosure.stp](../../../CAD/v2/PIRx4.stp)**

    Material for printed parts: ABS or ABS CF

!!! quote annotate "Cutting Layout"

    **[x4 cutting layout.pdf](../../../PDF/v2/cut_plan_x4.pdf)**

    **[x4 one-sheet cutting layout.pdf](../../../PDF/v2/cut_plan_x4_single_sheet.pdf)**

!!! warning annotate "Important"

    All internal parts inside the enclosure must be printed with materials that can withstand heating to 100°C or higher.

    The air duct insulation shown in the x4 project is provided for reference. You may use it as is or insulate the air duct with any thermal insulation material. Failure to do so will result in slower heating and significantly increased power consumption!

<!-- [![Telegram](https://img.shields.io/badge/Telegram-Join%20Group-blue)](https://t.me/iDryer)  [![YouTube](https://img.shields.io/badge/YouTube-Watch%20video-red)](https://www.youtube.com/@iDryerProject) [![Rutube](https://img.shields.io/badge/Rutube-Watch%20video-blue)](https://rutube.ru/channel/34401569/) -->
