pavluchenkor/iDryer-X/docs/ru/v1/air-damper-v0.md

# Заслонка


(*первородная заслонка*)

## Финальный вариант
Финальный вариант заслонки проветривания камеры. Данная модель рассчитана на толщину стенки сушилки 30мм. Но меняя толщину детали Диффузор можно подогнать под любой корпус. Монтаж упрощен - нужно вырезать сквозное шестигранное отверстие. Диффузор печатается с минимальным заполнением, что даёт хорошую теплоизоляцию.

!!! info "CAD файлы [от @gungrel](https://t.me/gungrel)"

    [Воздушная заслонка](../../../CAD/common/air-damper-air-damper-v0/damper_final.stp)

## Старый вариант

предназначена для регулярного проветривания камеры

Потребуется покупка сервопривода [SG90 9g](https://aliexpress.ru/item/32962841728.html?sku_id=66666348213&spm=.search_results.16.6c0b4aa6tK2QUa)

!!! info "CAD файлы [от @gungrel](https://t.me/gungrel)"

    [Воздушная заслонка](../../../CAD/common/air-damper-air-damper-v0/air_damper.stp)

!!! note "Файлы для печати"

    [air_damper_back.stl](../../../CAD/common/air-damper-air-damper-v0/STL/air_damper_back.stl)

    [air_damper_diffuser.stl](../../../CAD/common/air-damper-air-damper-v0/STL/air_damper_diffuser.stl)

    [air_damper_flap.stl](../../../CAD/common/air-damper-air-damper-v0/STL/air_damper_flap.stl)

    [air_damper_front.stl](../../../CAD/common/air-damper-air-damper-v0/STL/air_damper_front.stl)
