pavluchenkor/iDryer-X/docs/ru/v1/heater.md

# Нагреватель  с кулером
Разметка

Модуль от [@gungrel](https://t.me/gungrel)

!!! note "Файлы для печати"

    [Крепление бме280.stl](../../../CAD/common/heater/mount_bme280.stl)

    [Модуль нагревателя PTC 100W 220V 7530 7525.stp](../../../CAD/common/heater/PTC_100W_220V_7530_7525.stp)

## Покупка комплектующих

[Вентилятор для модуля на али](https://aliexpress.ru/item/1691802504.html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)

[2 вентилятора для модуля на али](https://aliexpress.ru/item/1005002255060284.html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)

[Нагревательный элемент на али](https://aliexpress.ru/item/32319632955.html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)
