pavluchenkor/iDryer-X/docs/ru/v1/pcb-case.md

# Корпус контроллера r2

скачайте и распечатайте два файла [разработано @gungrel](https://t.me/gungrel)

Assembly ebox
screen stand

## Файлы

!!! note "Файлы для печати"

    [iDryer v1 prototype](../../../CAD/common/pcb-case/Assembly_ebox.stp) - Корпус

    [iDryer v2](../../../CAD/common/pcb-case/screen_stand.stp) - проставка экрана
