pavluchenkor/iDryer-X/docs/ru/v1/alternative-case.md

# Корпус из EPP

Корпус сушилки из EPP (экструзионный полипропилен)

Полипропилен имеет низкое влагопоглощение. Характеризуется хорошими электроизоляционными свойствами в широком диапазоне температур.
Максимальная температура эксплуатации 120 °C
На рынке представлен широкий ассортимент готовых коробов разных размеров.



Обсуждение тут

[Группа](https://t.me/iDryer){ .md-button }

[Обсуждение 2 ](https://t.me/iDryer/2175)

[Обсуждение 3 ](https://t.me/iDryer/2304)

[Обсуждение 4 ](https://t.me/iDryer/1244)

[Обсуждение 5 ](https://t.me/iDryer/1244)
