pavluchenkor/iDryer-X/docs/ru/v1/scale-module.md

# Катушкодержатель



Предназначен для хранения катушек и отслеживания остатка филамента, отображения остатка на экране и сигнализации через сигнальный выход

## Печатный вариант
Верхняя часть модуля является удобной альтернативой существующим держателям катушек.
Используются 694 подшипники или их аналоги (11х4х4) и бронзовый прут d4 из хозяйственного магазина в качестве оси.
Печатается из композитного ABS или любого пластика способного выдерживать максимальную планируемую температуру сушки + 10-15 градусов.

Потребуется покупка [load cell module и HX711](https://aliexpress.ru/item/32860114708.html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)

Модели легко переделать под имеющиеся в наличии подшипники

!!! note "Файлы для печати на 3д принтере"

    [Весы узкие.stp](../../../CAD/common/scale-module/scale_narrow.stp)

    [Весы.stp](../../../CAD/common/scale-module/scale.stp)

катушкодержатель
катушкодержатель
катушкодержатель

катушкодержатель
катушкодержатель

## Металлические варианты
 Участниками группы разработано несколько вариантов из металла.

### От @gungrel
Катушкодержатель металл гибка под подшипники 623. В сборке основания под 1,2,3 и 4 катушки. В качестве ролика используется трубка алюминиевая 12х1

!!! info "Модель для лазерной резки и гибки [от @gungrel](https://t.me/gungrel)"

    [Катушкодержатель гибка финал.stp](../../../CAD/common/scale-module/spool_holder_bending_final.stp)

### Ремикс [от @Kekht](https://t.me/Kekht)
*на раннюю версию держателя [от @gungrel](https://t.me/gungrel)*

**Особенности модификации:**

  Максимальная ширина катушки - 83.6мм

  Используются подшипники 686 и алюминиевая трубка - диаметр внешний 15мм внутренний 13мм

  Для крепления подшипников используются печатные анкерные вставки и винты М3

  Диаметр отверстия под анкера 8мм, поэтому изменив только акнеры возможно использования любых подшипников и трубок (максимальный диаметр трубки 23мм)

  Анкера лучше печатать из полиамида (чистого или композитного). При необходимости снять ролики после выкручивания винтов анкера извлекаются без усилий

  По бокам держателя есть дополнительные отверстия, к которым можно крепить стойки-держатели для нестандартных катушек (картонных например) или пробников

  Предусмотрена проставка под тензодатчик, позволяющая дополнительно закрепить на стяжку его провода

  Предусмотрены отверстия для крепления ножек (в модели два варианта) или специальных крепежных печатных пластин (тоже два варианта под разный тип винтов), позволяющих скреплять держатели в "батарею".

    Раскрой сделан под гибку со следующими параметрами:
    Радиус для 3мм стали -  2,7
    Радиус для 2мм стали - 1,8
    Минимальная полка - 14мм
    Коэф.К - 0,44

[Видео](https://www.youtube.com/embed/iAZZLo_1NXo?si=j_zRWY-Wy7RiXFXJ)

!!! info "Ремикс [от @Kekht](https://t.me/Kekht) на раннюю версию держателя [от @gungrel](https://t.me/gungrel)"

    [SpoolHolderWeightModule_v1_3_2.STEP](../../../CAD/common/scale-module/SpoolHolderWeightModule_v1_3_2.STEP)

    [Rollers_Holder_v1_3.DXF](../../../CAD/common/scale-module/Rollers_Holder_v1_3.DXF)

    [Base_Single_v1_2.DXF](../../../CAD/common/scale-module/Base_Single_v1_2.DXF)

### Вариант от Саши

катушкодержатель
катушкодержатель

!!! note "Модель для фрезеровки"

    [Sasha.STEP](../../../CAD/common/scale-module/Sasha.STEP)

    [разработано Саша](https://t.me/iDryer/9446)
