pavluchenkor/iDryer-X/docs/ru/v2/x2.md

# Сушилка филамента iDryer x2

## Особенности

- Количество катушек: 2
- Температура сушки: до 110С
- Контроль температуры нагревателя: да
- Контроль температуры воздуха в камере: да
- Время сушки: не ограничено
- Принудительное проветривание: да
- Взвешивание филамента: да
- Пресеты: да
- Типы филамента: PLA, ABS, HIPS, PETG, SBS, Flex, PA6, PA12, PC, ABS, ASA, PP, POM и другие

iDryer x2
iDryer x2
iDryer x2

!!! info "Полная модель корпуса"

    [Корпус PIR x2](../../../CAD/v2/PIRx2.stp)

    Материал печатных деталей - ABS или ABS CF

!!! note "Раскрой"

    [раскрой х2](../../../PDF/v2/cut_plan_x2.pdf)

!!! warning "Важно"

    Все детали находящиеся внутри корпуса печатаются из материалов выдерживающих нагревание 100С и выше.

    Воздуховод в подвале сушилки необходимо изолировать, теплоизоляция воздуховода в проекте x4 представлена для ознакомления, можно использовать в таком же виде или оклеить воздуховод любым теплоизоляционным материалом. Если этого не сделать, скорость прогрева будет снижена, а потребление электричества увеличится значительно!
