pavluchenkor/iDryer-X/docs/img/pcb-r2/IMG_20230921_230123.jpg

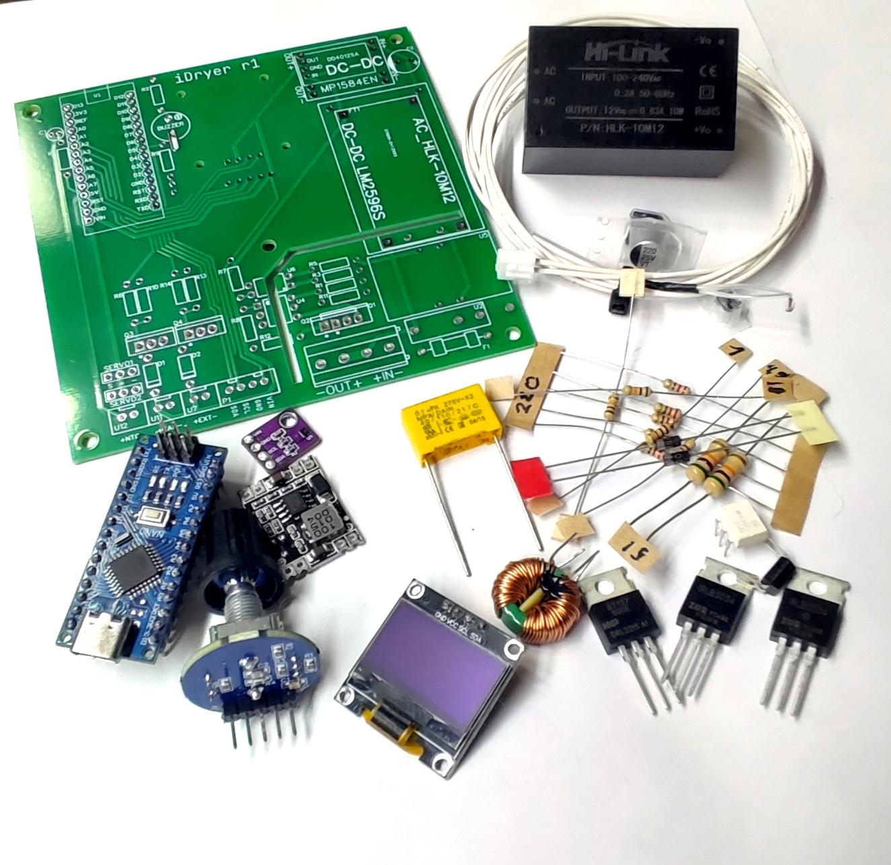
docs/img/pcb-r2/IMG_20230921_230123.jpg
