pavluchenkor/iDryer-X/docs/img/pir-box-v3/0015.jpeg

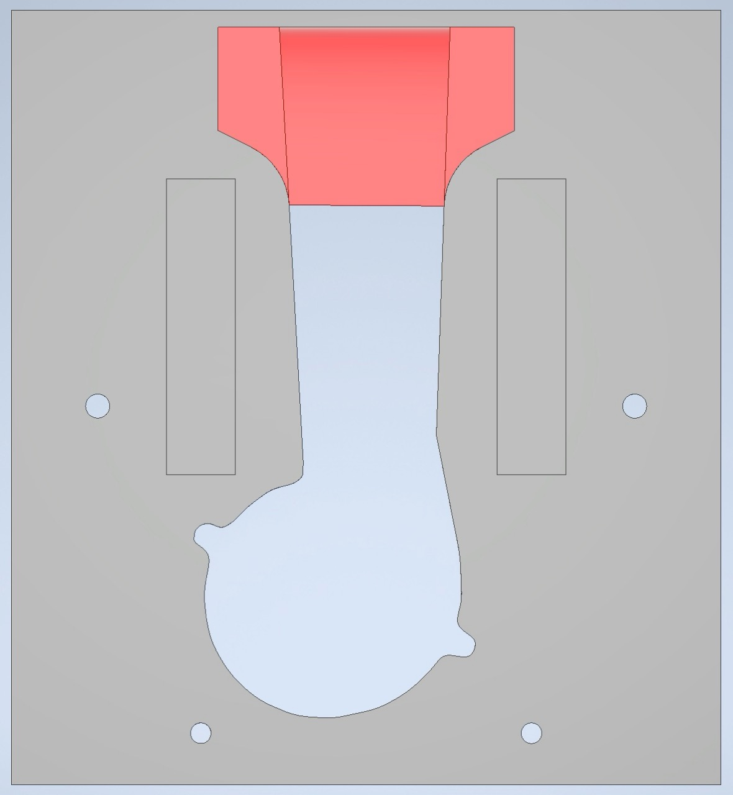
docs/img/pir-box-v3/0015.jpeg
