pavluchenkor/iDryer-X/docs/img/pir-box-v3/IMG_2509.jpg

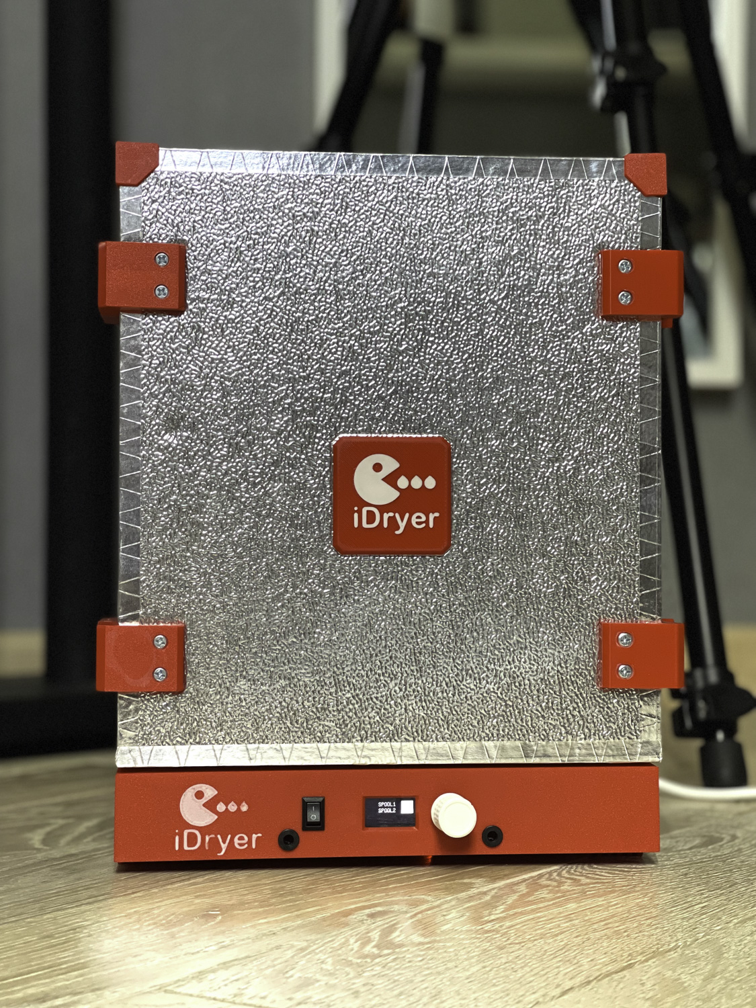
docs/img/pir-box-v3/IMG_2509.jpg
