pavluchenkor/iDryer-X/docs/img/pir-box-v3/IMG_E2515.jpg

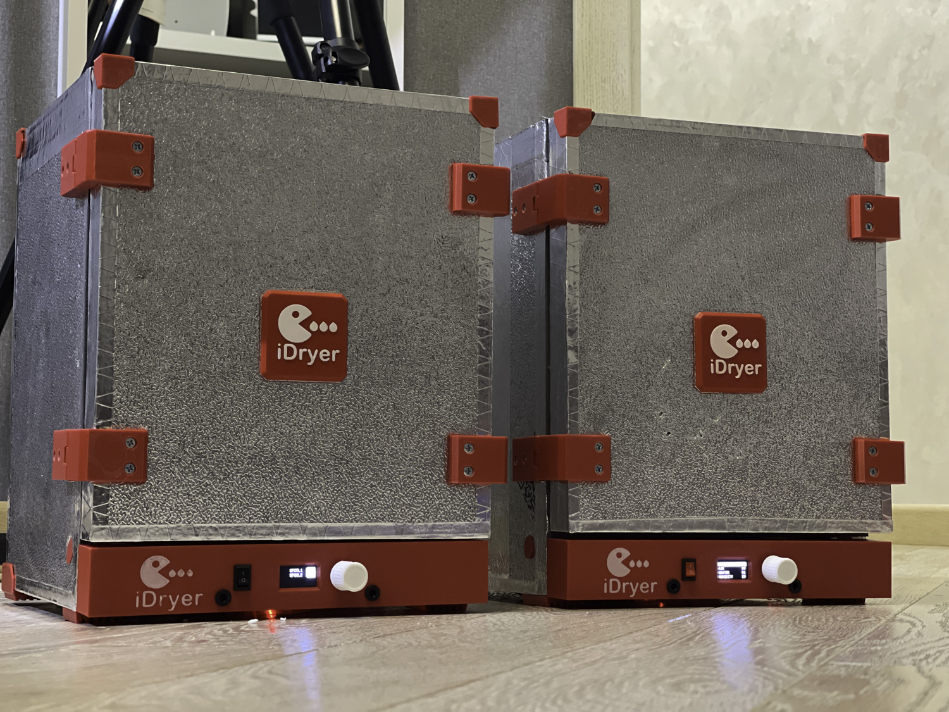
docs/img/pir-box-v3/IMG_E2515.jpg
