pavluchenkor/iDryer-X/docs/img/scale-module/camphoto_959030623-web.jpeg

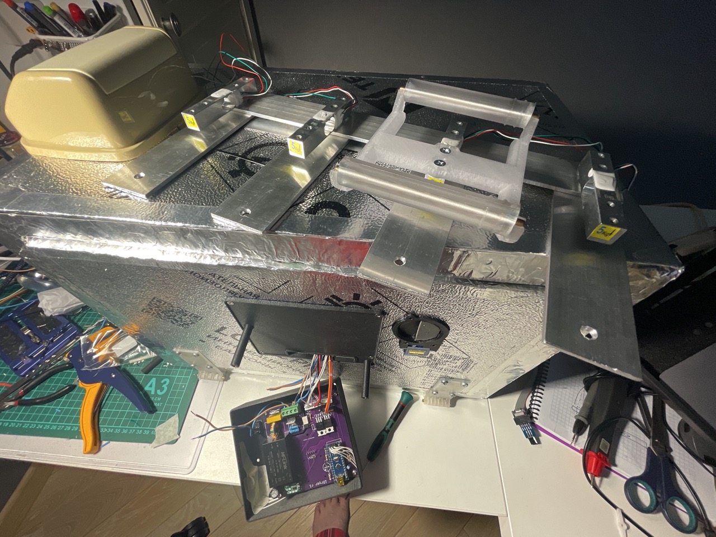
docs/img/scale-module/camphoto_959030623-web.jpeg
