pavluchenkor/iDryer-X/docs/img/scale-module/camphoto_1483920592-web.jpeg

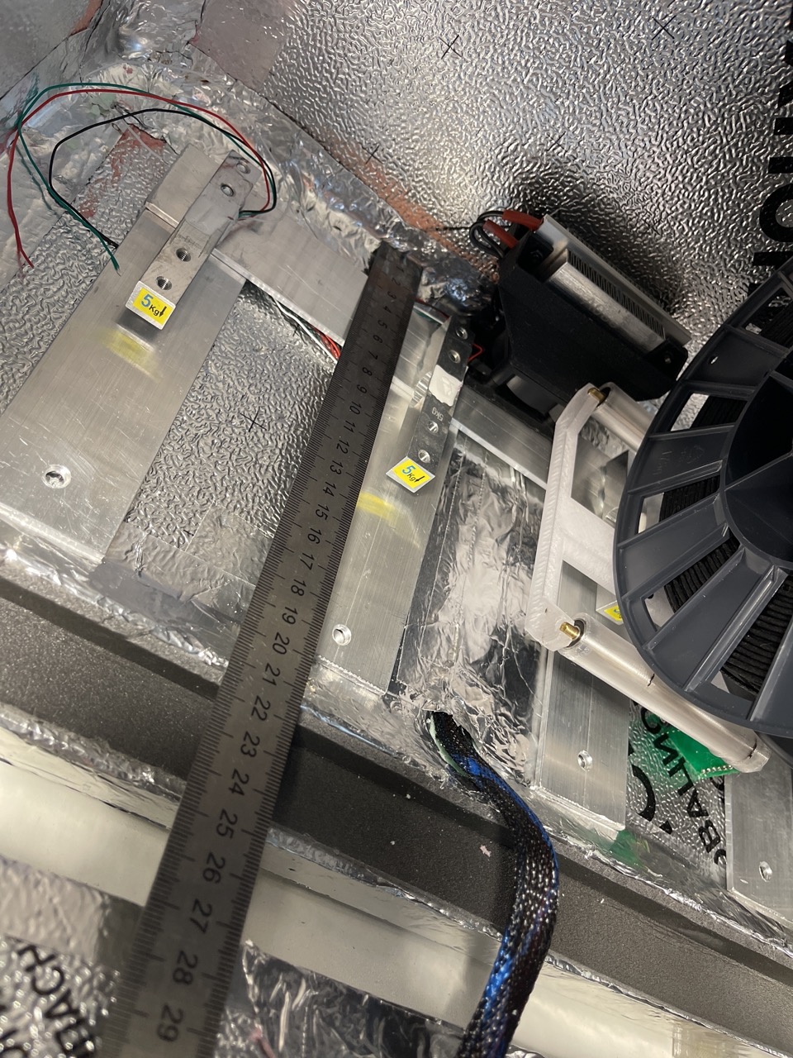
docs/img/scale-module/camphoto_1483920592-web.jpeg
