pavluchenkor/iDryer-X/docs/img/scale-module/camphoto_1932422408-web.jpeg

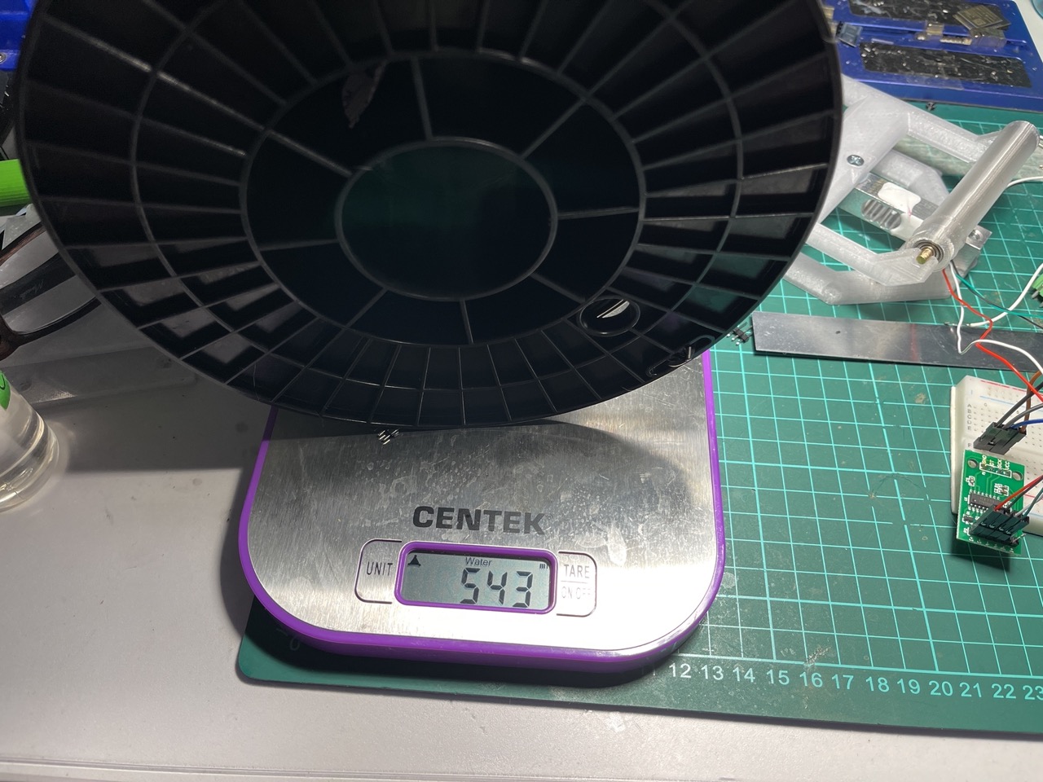
docs/img/scale-module/camphoto_1932422408-web.jpeg
