pavluchenkor/iDryer-X/docs/img/scale-module/IMG_8885-web.jpeg

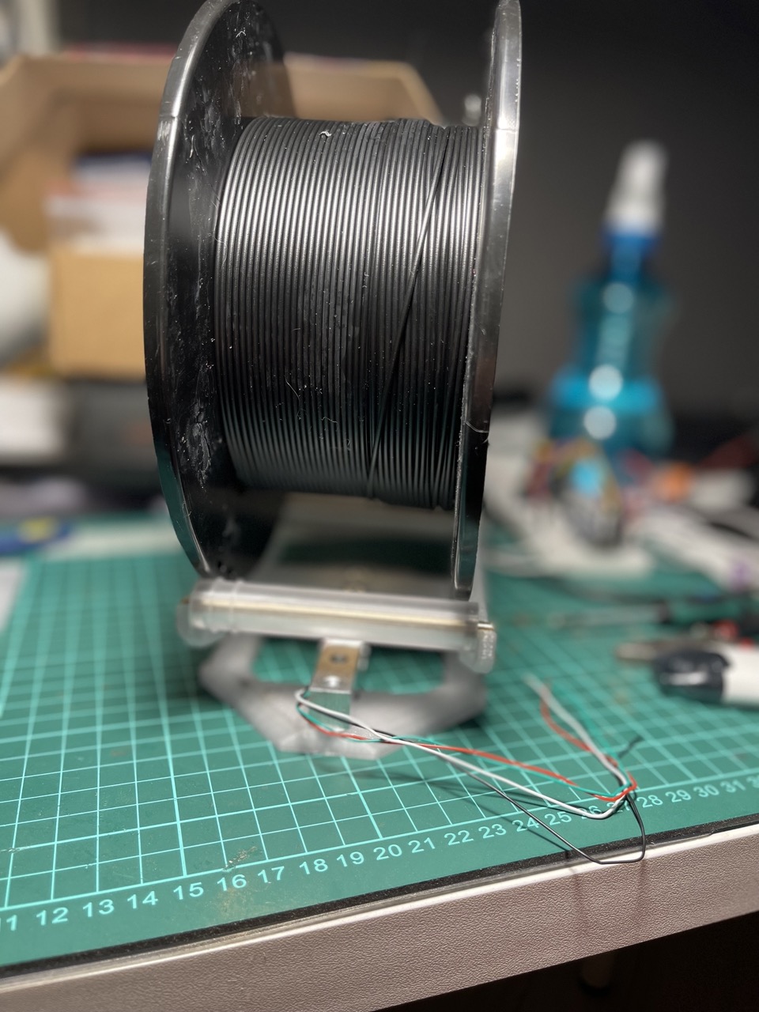
docs/img/scale-module/IMG_8885-web.jpeg
