pavluchenkor/iDryer-X/docs/img/scale-module/IMG_9169-web.jpeg

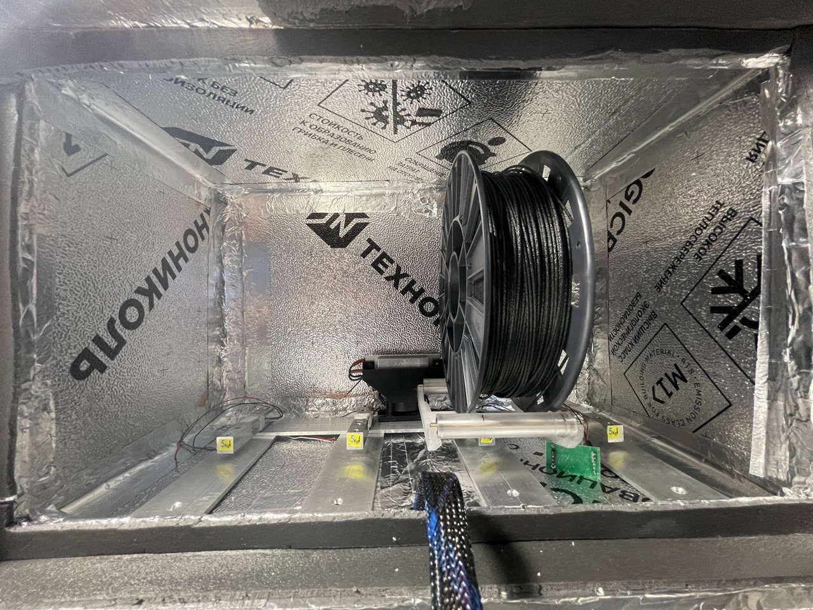
docs/img/scale-module/IMG_9169-web.jpeg
