pavluchenkor/iDryer-X/docs/img/scale-module/IMG_9196-web.jpeg

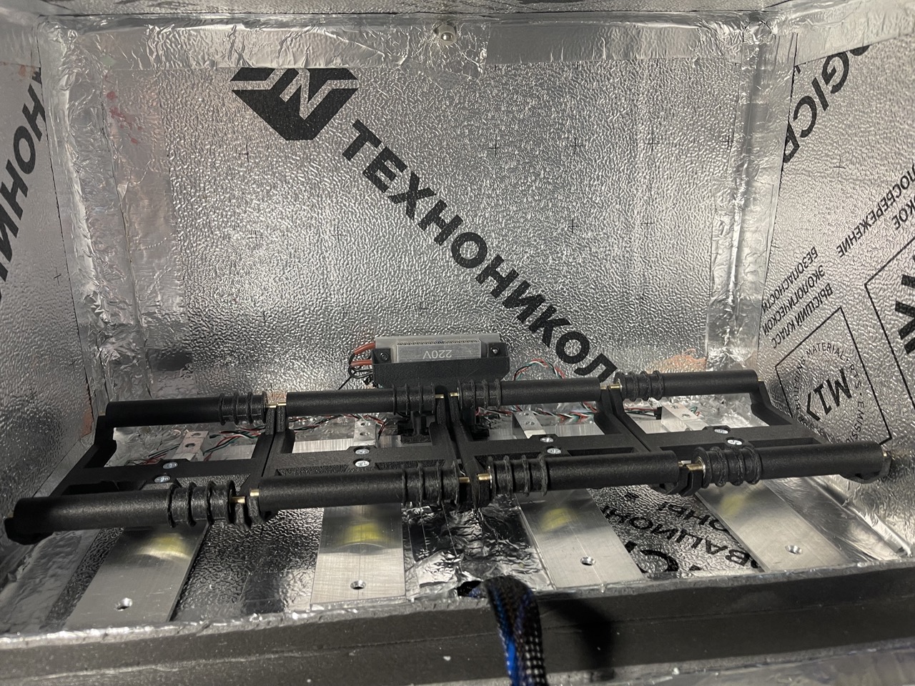
docs/img/scale-module/IMG_9196-web.jpeg
