pavluchenkor/iDryer-X/docs/ru/v3/bom.md

# BOM

## Компоненты платы

Модули, микросхемы, радиоэлементы и разъёмы, устанавливаемые непосредственно на PCB.

| Шелкография | Наименование | Кол-во | Ссылка |
|---|---|---|---|
| ARDUINO | ARDUINO_NANO | 1 | [link](https://item.taobao.com/item.htm?abbucket=13&id=553901711109&ns=1&skuId=5179378853807) |
| HX711 | HX711 | 1 | [link](https://item.taobao.com/item.htm?abbucket=13&id=772757780485&skuId=5462260771003) |
| HLK-10M12 | HLK-10M12 | 1 | [link](https://detail.tmall.com/item.htm?abbucket=13&id=598533750362&skuId=5742634447589) |
| MP1584 | DC-DC Step Down MP1584 | 1 | [link](https://item.taobao.com/item.htm?id=552800241410&skuId=3816633172390) |
| HC4052E | CD74HC4052E | 1 | — |
| MOC 3023 | MOC3023 | 1 | — |
| FOD814 | 814 | 1 | — |
| BUZZER | Active Buzzer 5V | 1 | — |
| FUSE | 2А 250В | 1 | — |
| TRIAC | BT137-600E | 1 | — |
| FET | N Channel FET IRF840 | 1 | — |
| FILTER | Filter 10MH | 1 | — |
| C1 | 0.1uF 280V | 1 | — |
| C2 | 220uF 16-25V | 1 | — |
| C3 | 10uF 5-16V | 1 | — |
| D1 | 1N4007 | 1 | — |
| R2,R3 | 51K 2W | 1 | — |
| R5,R7,R8 | 10K | 3 | — |
| R10 | 4,7K | 1 | — |
| R1 | 1K | 1 | — |
| R4,R6,R9 | 220 | 3 | — |
| BME | XH-4P-2.54 (разъём на плате) | 1 | [link](https://item.taobao.com/item.htm?abbucket=5&id=595936735363&skuId=5548845452199) |
| FAN, NTC, S_OUT | XH-2P-2.54 (разъём на плате) | 3 | [link](https://item.taobao.com/item.htm?abbucket=15&id=526365951224&skuId=3133698971007) |
| OUT__220__IN | KF128L-5.08-4P | 1 | [link](https://item.taobao.com/item.htm?id=41736391110&skuId=4948738009329) |
| REL | DB301V-3.5-2P | 1 | [link](https://item.taobao.com/item.htm?id=795608144319) |
| — | PLS-5 (encoder) | 1 | — |
| — | PLS-4 (oled) | 1 | — |
| — | PLS-3 (servo) | 1 | — |
| — | PBS-15 | 2 | — |

## Внешние устройства

Устройства, подключаемые к плате кабелями.

| Наименование | Кол-во | Ссылка |
|---|---|---|
| OLED-128X64-I2C | 1 | [link](https://item.taobao.com/item.htm?id=780489039126&skuId=5333147697116) |
| Rotary Encoder EC11 | 1 | [link](https://item.taobao.com/item.htm?id=577872767337) |
| Сервопривод SG-90 180 градусов | 1 | [link](https://item.taobao.com/item.htm?abbucket=13&id=769258388058&skuId=5447912547856) |
| BME-280/SHT31 | 1 | [BME280](https://item.taobao.com/item.htm?abbucket=13&id=598587877472&skuId=4936313153704) / [SHT31](https://item.taobao.com/item.htm?abbucket=13&id=714320660099&skuId=5173572879522) |
| Thermostat NC 130C (REL) | 1 | [link](https://item.taobao.com/item.htm?id=596464000063&skuId=4151732057790) |
| Термистор 100K | 1 | [link](https://item.taobao.com/item.htm?id=561074337090&skuId=4438343254554) |
| PTC 100Вт нагреватель (PIR) | 1 | [link](https://item.taobao.com/item.htm?id=35448812843&skuId=39150743208) |
| Кулер 7530 (FAN) | 1 | [link](https://item.taobao.com/item.htm?id=614197186147) |
| Выключатель | 1 | [link](https://item.taobao.com/item.htm?ft=t&id=622870366400&skuId=4572045682040) |
| BLS-4 2.54mm 30cm (кабель encoder) | 1 | [link](https://item.taobao.com/item.htm?id=680088945332&skuId=4878700837791) |
| BLS-5 2.54mm 30cm (кабель oled) | 1 | [link](https://item.taobao.com/item.htm?id=680088945332&skuId=4878700837793) |
| XH-4P-2.54 30cm (кабель BME) | 1 | [link](https://item.taobao.com/item.htm?abbucket=5&id=595936735363&skuId=5548845452199) |

## Метизы и дополнительные материалы

| Наименование | x2 | x3 | x4 | Ссылка |
|---|---|---|---|---|
| Винт м4х20 (тензодатчик-катушкодержатель) | 4 | 6 | 8 | [link](https://www.vseinstrumenti.ru/product/vint-dobroga-s-polutsilindricheskoj-golovkoj-m4x20-mm-tsink-din-7985-500-sht-tsb-00033786-12329549/) |
| Шайба м4х1мм DIN125 (тензодатчик-катушкодержатель) | 4 | 6 | 8 | [link](https://www.vseinstrumenti.ru/product/shajba-dinfix-nerzh-a2-m4-din-125-500-sht-00-00002263-3587760/) |
| Винт м4(м5)х16 (пол-тензодатчик) | 4 | 6 | 8 | [link](https://www.vseinstrumenti.ru/product/vint-dobroga-p-tsilindr-m5x20-mm-tsink-din-7985-250-sht-tsb-00033795-12874948/) |
| Шайба м4(5)х1мм DIN125 (пол-тензодатчик) | 4 | 6 | 8 | [link](https://www.vseinstrumenti.ru/product/shajba-dinfix-nerzh-a2-m5-din-125-500-sht-00-00002266-3587778/) |
| Гровер | 4 | 6 | 8 | [link](https://www.vseinstrumenti.ru/product/shajba-pruzhinnaya-partner-din-127b-tsink-m5-500-sht-korobka-805270-14668325/) |
| Саморез | 18 | 18 | 18 | [link](https://www.vseinstrumenti.ru/product/okonnyj-furniturnyj-samorez-daxmer-4-1x20-mm-bel-tsink-ostryj-1000-sht-336822-7589402/) |
| Винт м3х25 (заслонка серво) | 6 | 6 | 6 | [link](https://www.vseinstrumenti.ru/product/potajnoj-vint-metiznyj-dvor-m3x25-din-965-200-sht-4607159066534-1120715/) |
| Саморез пластик м2х4 (экран) | 4 | 4 | 4 | — |
| НШвИ (наконечник на провод) | 6 | 6 | 6 | [link](https://www.vseinstrumenti.ru/product/shtyrevoj-vtulochnyj-izolirovannyj-nakonechnik-stekker-nshvi-0-5-8-ld405-058-opt-upakovka-100-sht-39431-1943131/) |
| Винт м3х8(10) (катушкодержатель) | 8 | 12 | 16 | [link](https://gayka-bolt.ru/product/vint-s-polukrugloj-golovkoj-m3h8-din-7380-10-9/) |
| Провод | — | — | — | [link](https://www.vseinstrumenti.ru/product/provod-pugv-ng-a-ls-oreol-1h0-75-belyj-50m-00-00003863-4671174/) |

## Скотч и лента

|		|	x2	|	x3	|	x4	|
|	-	|	-	|	-	|	-	|
|	Скотч алюминиевый армированый(mm)	|	5000	|	5500	|	6200	|
|	Лента Кнауф Дихтунгсбанд(mm)	|	1200	|	1400	|	1600	|
