pavluchenkor/iDryer-X/CAD/common/alternative-case/epp_assembly.stp

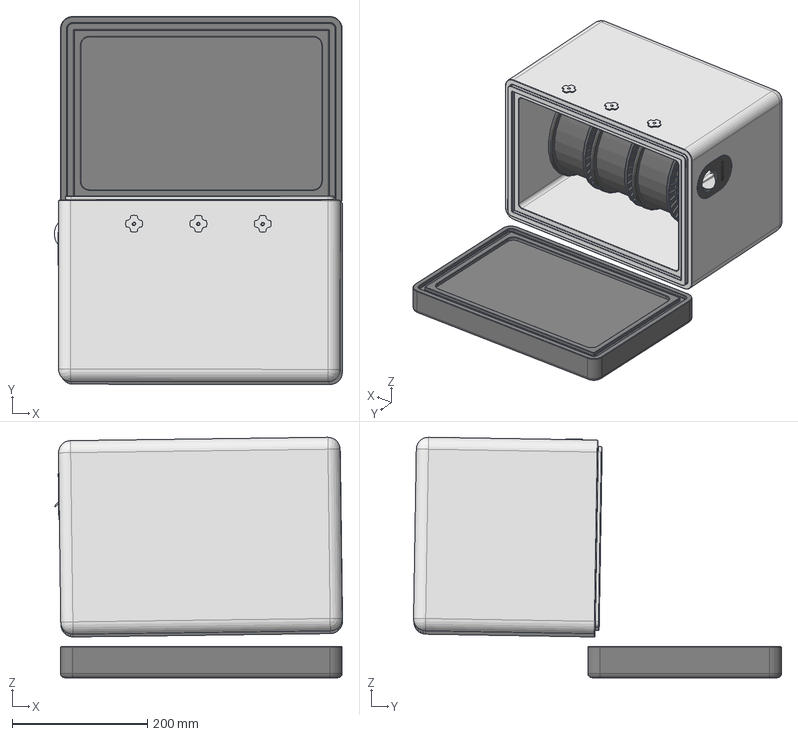
[picture p101: CAD file, 2026-06-23]
CAD/common/alternative-case/epp_assembly.stp
425.6 x 543.5 x 355.3 mm
основание весов
Друг2
Датчик x 3
Узкие весы гибка x 3
FD plast spool x 3
ТРубка 16х1 x 6
SKF_W 605-2Z x 12
Анкер x 6
DIN 7991 - M3x10 x 6
крышка Друг2
SG90 - Micro Servo 9g - Tower Pro.1_Pea
SG90 - Micro Servo 9g - Tower Pro.6_BS EN ISO 7045 - M2 x 4 - Z - 4S
Корпус заслонки
лепесток заслонки
дифузор заслонки внут
штуцер филамента x 3
PTC_Heater_24V_100W_Aliexpress_v3_MIR
крон 7525 левый
рассеиватель
