pavluchenkor/iDryer-X/CAD/common/pcb-case/Assembly_ebox.stp

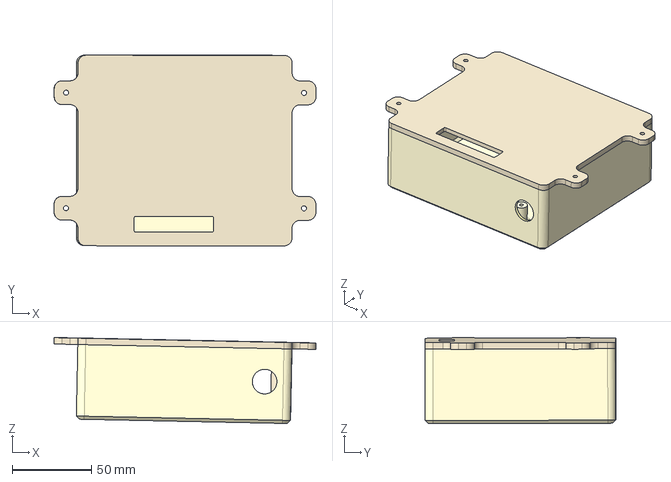
[picture p102: CAD file, 2026-06-23]
CAD/common/pcb-case/Assembly_ebox.stp
165.0 x 120.1 x 54.2 mm
box_lower
