pavluchenkor/iDryer-X/CAD/common/air-damper-air-damper-v0/air_damper.stp

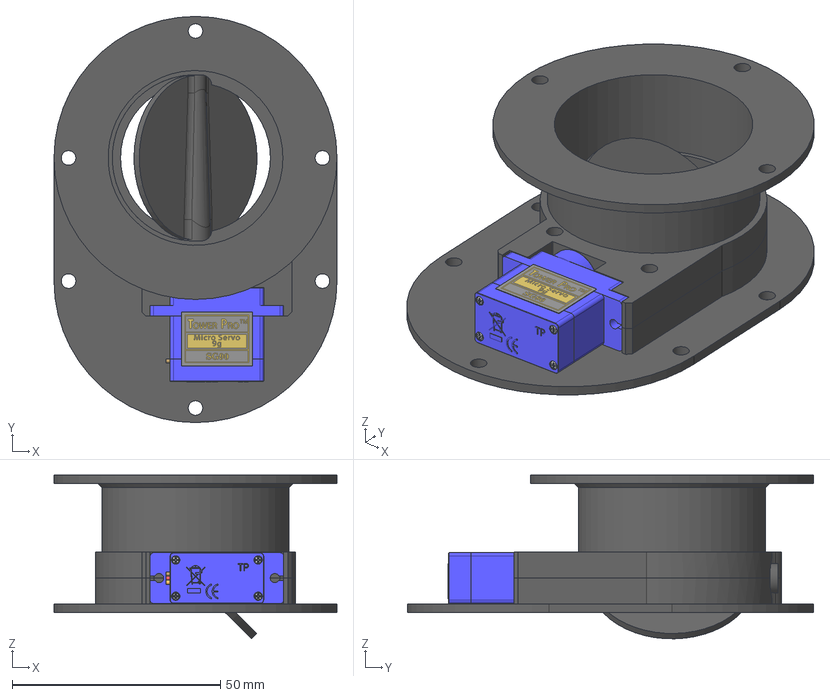
[picture p103: CAD file, 2026-06-23]
CAD/common/air-damper-air-damper-v0/air_damper.stp
68.0 x 97.6 x 39.3 mm
SG90 - Micro Servo 9g - Tower Pro.1_Pea
SG90 - Micro Servo 9g - Tower Pro.6_BS EN ISO 7045 - M2 x 4 - Z - 4S
Корпус заслонки
лепесток заслонки
дифузор заслонки внут
