pavluchenkor/iDryer-X/CAD/common/air-damper-air-damper-v0/STL/air_damper_flap.stl

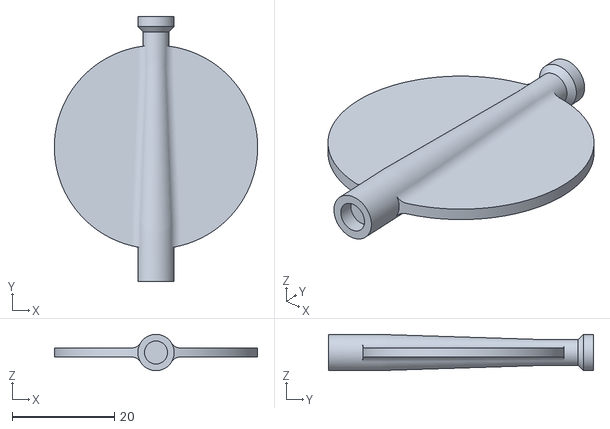
[picture p104: CAD file, 2026-06-23]
CAD/common/air-damper-air-damper-v0/STL/air_damper_flap.stl
39.7 x 51.7 x 7.10
