pavluchenkor/iDryer-X/CAD/common/heater/PTC_100W_220V_7530_7525.stp

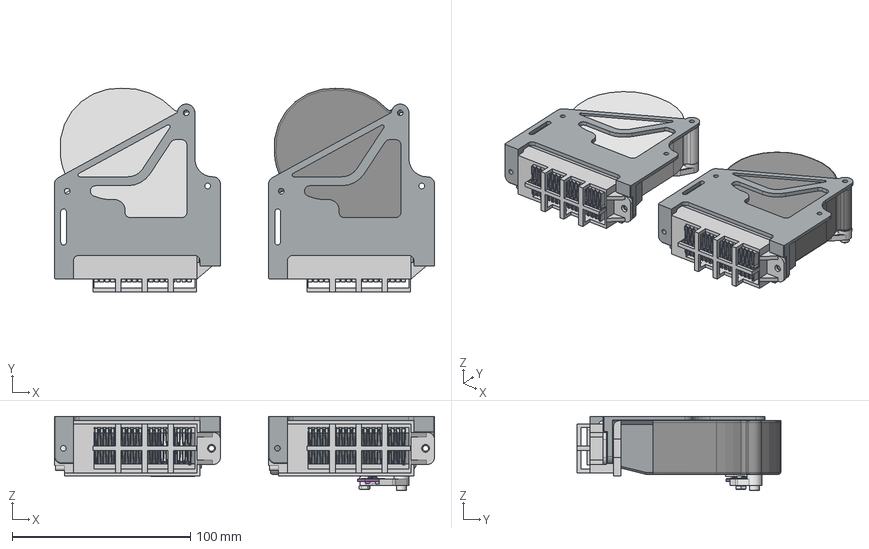
[picture p105: CAD file, 2026-06-23]
CAD/common/heater/PTC_100W_220V_7530_7525.stp
213.0 x 114.1 x 41.7 mm
GY-BME280 x 2
PTC_Heater_24V_100W_Aliexpress_v3_MIR x 2
крон 7525 левый
Защита провода бме280 x 2
крон 7530 левый
Винт с полукруглой головкой и шестигранным шлицем ГОСТ ISO 7380-1 - M3x6
ISO 4032 - M3
ISO 4762 - M3 x 30
