pavluchenkor/iDryer-X/CAD/common/scale-module/for 3D printing/scale_narrow.stp

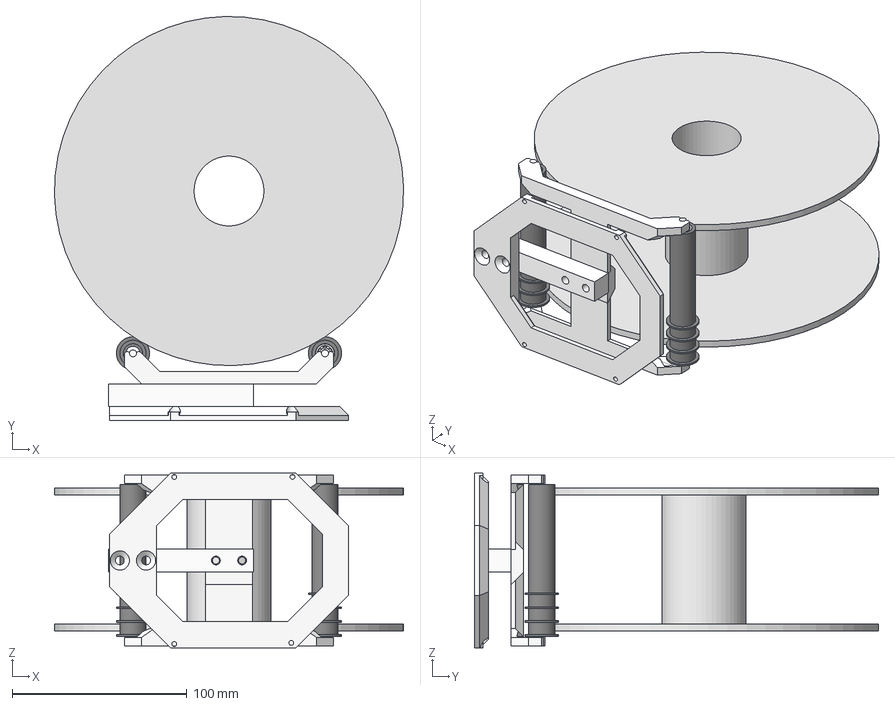
[picture p106: CAD file, 2026-06-23]
CAD/common/scale-module/for 3D printing/scale_narrow.stp
199.9 x 231.4 x 100.0 mm
Платформа
Датчик
Деталь17
Ось
Ось_1
Катушка мелкая
Rolling bearing 70000B S719/4 GB/T 292-94 x 2
Вал2 x 2
