pavluchenkor/iDryer-X/CAD/common/scale-module/for cutting metal/Sasha.STEP

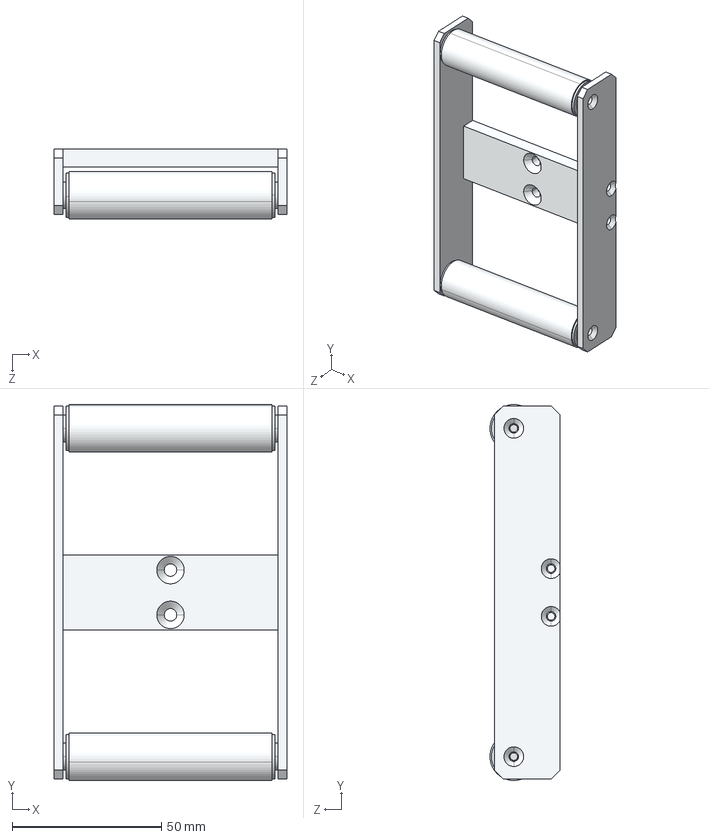
[picture p107: CAD file, 2026-06-23]
CAD/common/scale-module/for cutting metal/Sasha.STEP
78.0 x 126.0 x 23.5 mm
櫻蠉錪2
櫻蠉錪1 x 2
櫻蠉錪3 x 2
F695 Bearing x 4
櫻蠉錪4 x 4
櫻蠉錪5 x 2
