pavluchenkor/iDryer-X/CAD/v3/clips.3mf

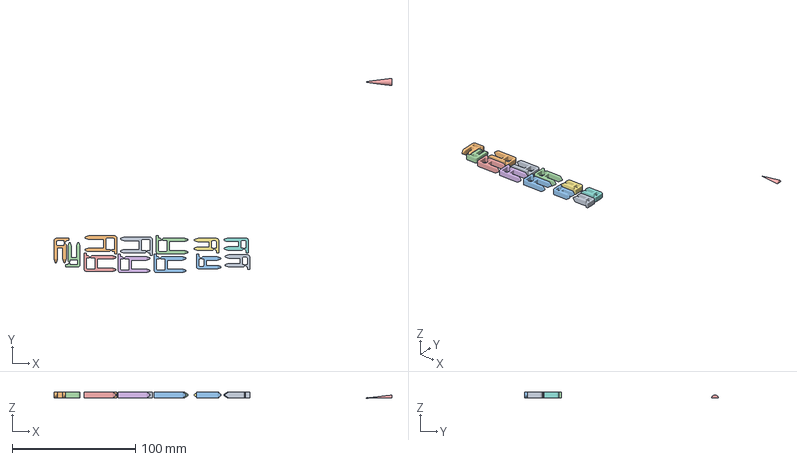
[picture p108: CAD file, 2026-06-23]
CAD/v3/clips.3mf
274.1 x 157.6 x 5.00 mm
Фиксатор провода большой.stl x 6
Фиксатор провода малый.stl x 6
Клин кабельного ввода.stl
