pavluchenkor/iDryer-X/CAD/common/air-damper-air-damper-v0/damper_final.stp

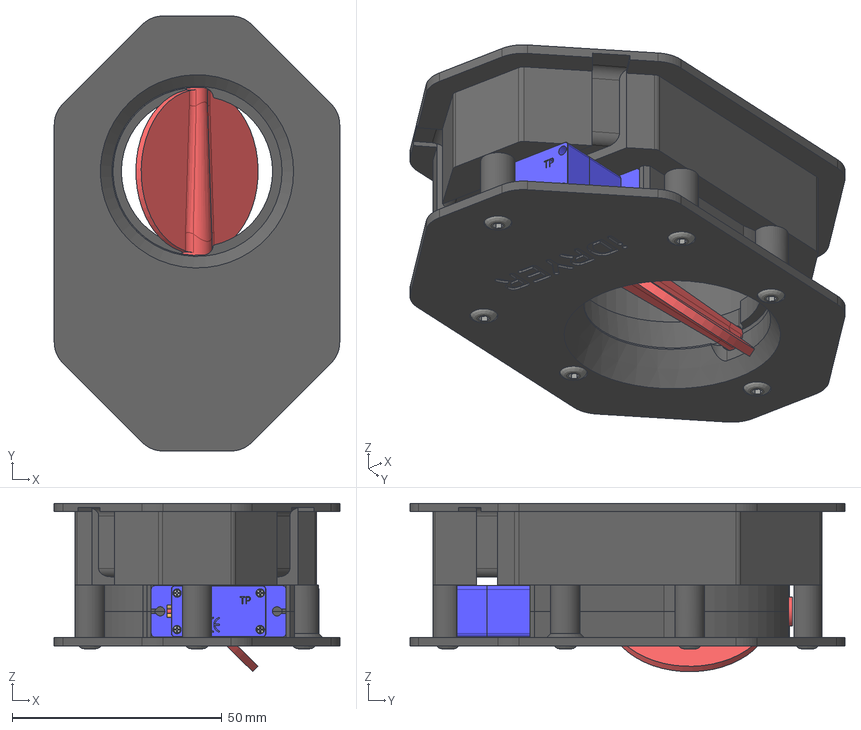
[picture p109: CAD file, 2026-06-23]
CAD/common/air-damper-air-damper-v0/damper_final.stp
68.0 x 103.6 x 40.1 mm
SG90 - Micro Servo 9g - Tower Pro.1_Pea
SG90 - Micro Servo 9g - Tower Pro.6_BS EN ISO 7045 - M2 x 4 - Z - 4S
Корпус заслонки
лепесток заслонки
дифузор заслонки внут
ISO 7380-1 - M3 x 20 x 6
ISO 7380-1 - M3 x 10 x 3
