pavluchenkor/iDryer-X/CAD/common/air-damper-air-damper-v0/STL/air_damper_back.stl

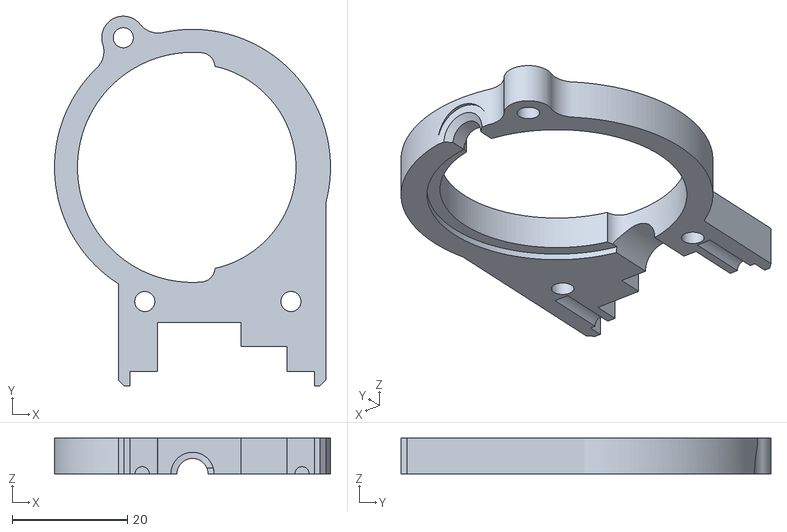
[picture p110: CAD file, 2026-06-23]
CAD/common/air-damper-air-damper-v0/STL/air_damper_back.stl
48.0 x 64.3 x 6.25
