pavluchenkor/iDryer-X/CAD/common/heater/mount_bme280.stl

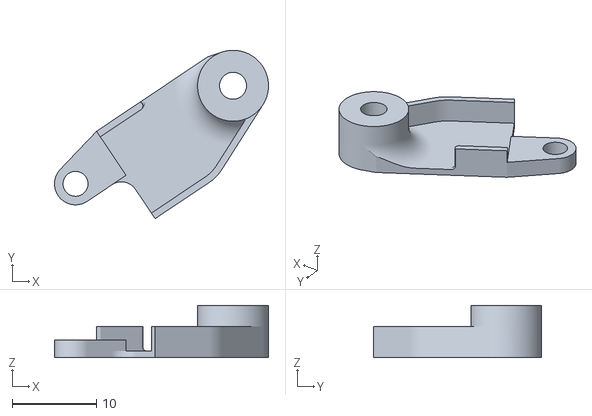
[picture p111: CAD file, 2026-06-23]
CAD/common/heater/mount_bme280.stl
25.4 x 20.0 x 6.21
