pavluchenkor/iDryer-X/CAD/common/pcb-case/screen_stand.stp

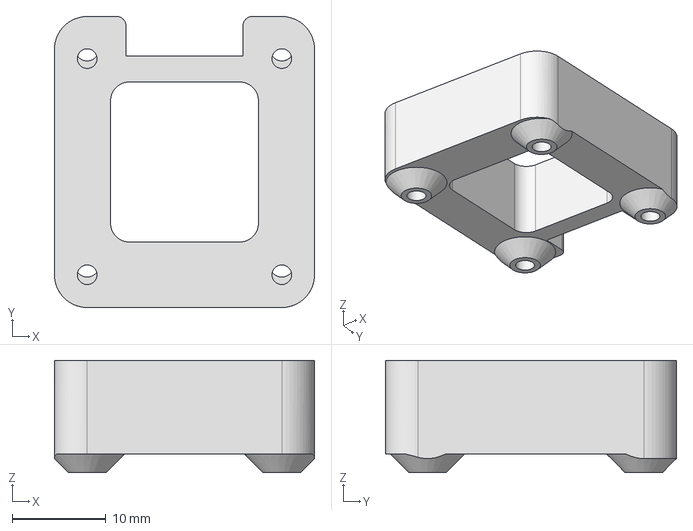
[picture p112: CAD file, 2026-06-23]
CAD/common/pcb-case/screen_stand.stp
27.8 x 31.1 x 12.0 mm
