pavluchenkor/iDryer-X/CAD/common/scale-module/for 3D printing/scale.stp

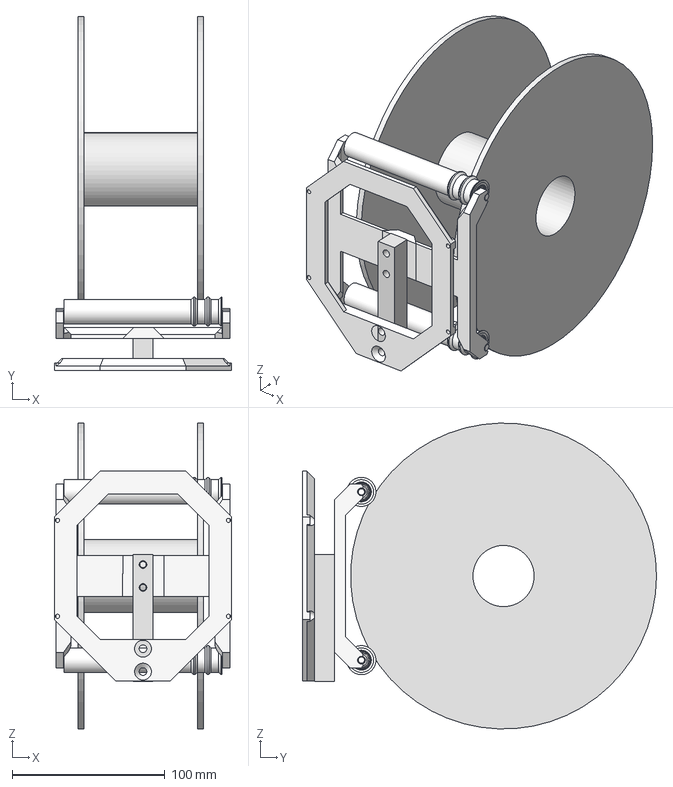
[picture p113: CAD file, 2026-06-23]
CAD/common/scale-module/for 3D printing/scale.stp
116.0 x 231.4 x 199.9 mm
Платформа
Деталь17
Ось
Ось_1
695ZZ x 4
Деталь19 x 2
Катушка мелкая
Датчик
