pavluchenkor/iDryer-X/CAD/common/scale-module/for cutting metal/SpoolHolderWeightModule_v1_3_2.STEP

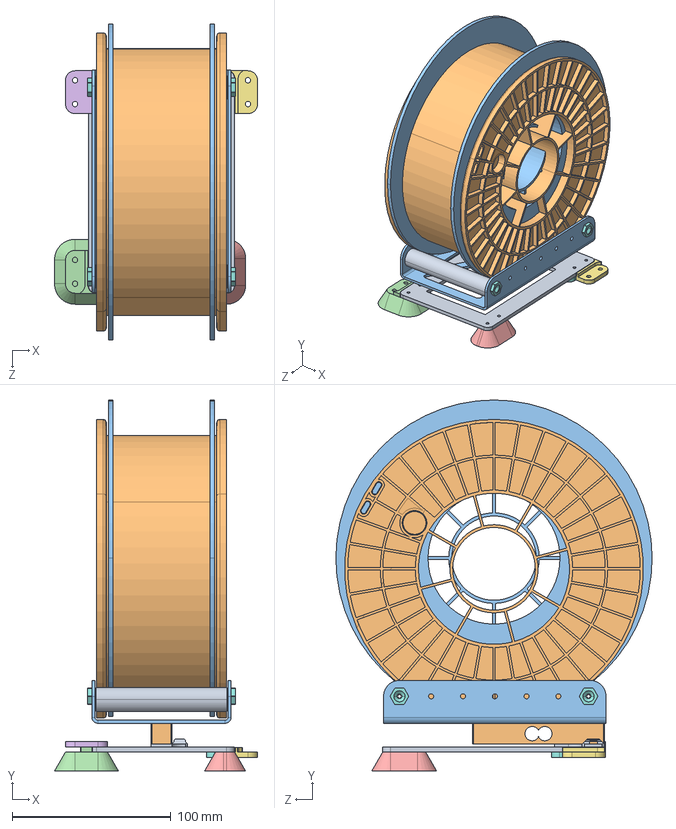
[picture p114: CAD file, 2026-06-23]
CAD/common/scale-module/for cutting metal/SpoolHolderWeightModule_v1_3_2.STEP
127.7 x 233.4 x 199.0 mm
Base_Single_v1_2
Sensor
Rollers_Holder_v1_3
bearing_686zz x 4
Anchor_v1_5 x 4
Roller_tube_v1_2 x 2
FD plast spool
eSun_Spool_black
Leg_connecting^SpoolHolderWeightModule_v1_3
Leg_single^SpoolHolderWeightModule_v1_3
Connector_flat_v1_3
Connector_cs_v1_3
Leg_low^SpoolHolderWeightModule_v1_3
Sensor_wire_holder^SpoolHolderWeightModule_v1_3
