pavluchenkor/iDryer-X/CAD/common/scale-module/spool_holder_module_3slots.igs

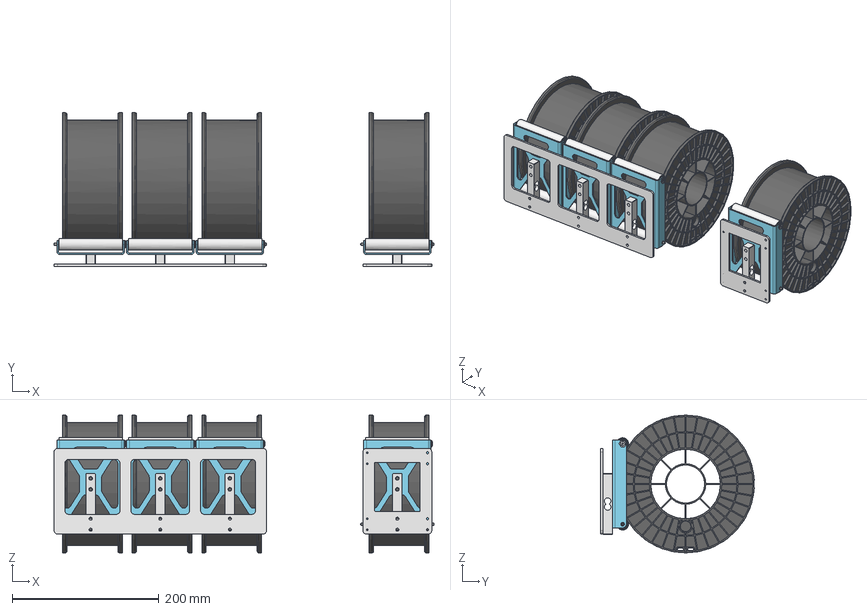
[picture p115: CAD file, 2026-06-23]
CAD/common/scale-module/spool_holder_module_3slots.igs
518.4 x 209.6 x 188.0 mm
