pavluchenkor/iDryer-X/CAD/v3/iDryer_set2.3mf

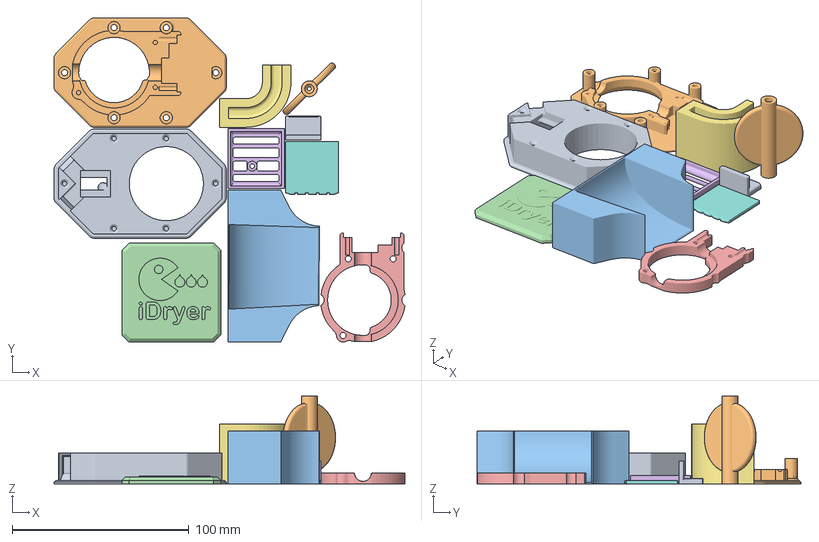
[picture p116: CAD file, 2026-06-23]
CAD/v3/iDryer_set2.3mf
198.7 x 183.5 x 49.7 mm
Заслонка датчик на кронштейне.stl
Заслонка задняя без лого.stl
Поворотная вставка.stl
LogoPlate без отверстий.stl
Заслонка внутрення.stl
Решетка.stl
Шаблон гибки трубок.stl
шпатель.stl
Рейсмус разметочный 10мм.stp
Заслонка шторка.stl
