pavluchenkor/iDryer-X/CAD/common/air-damper-air-damper-v0/STL/air_damper_front.stl

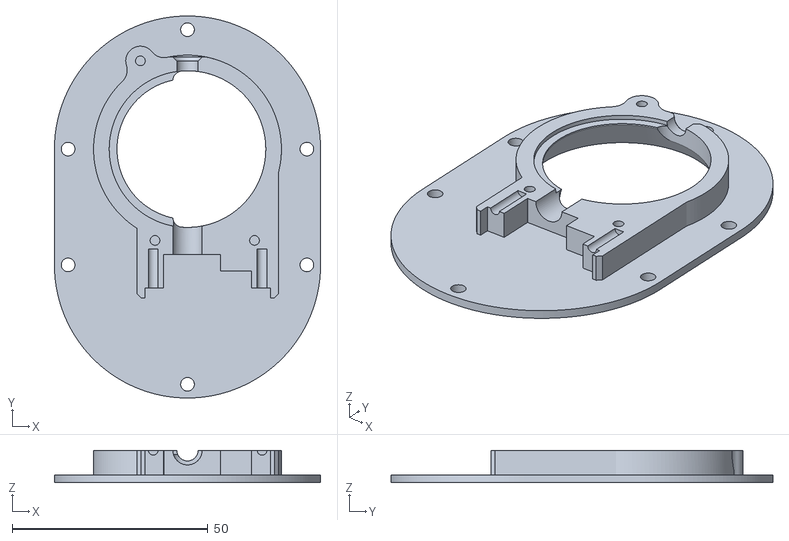
[picture p117: CAD file, 2026-06-23]
CAD/common/air-damper-air-damper-v0/STL/air_damper_front.stl
68.0 x 97.6 x 8.25
