pavluchenkor/iDryer-X/CAD/common/scale-module/for cutting metal/Base_Single_v1_2.DXF

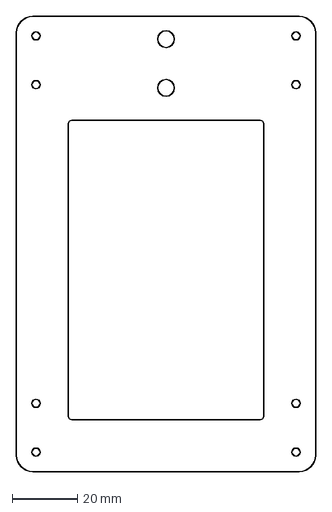
[picture p118: CAD file, 2026-06-23]
CAD/common/scale-module/for cutting metal/Base_Single_v1_2.DXF
92.0 x 140.0 mm
