pavluchenkor/iDryer-X/CAD/v3/panel_x3.3mf

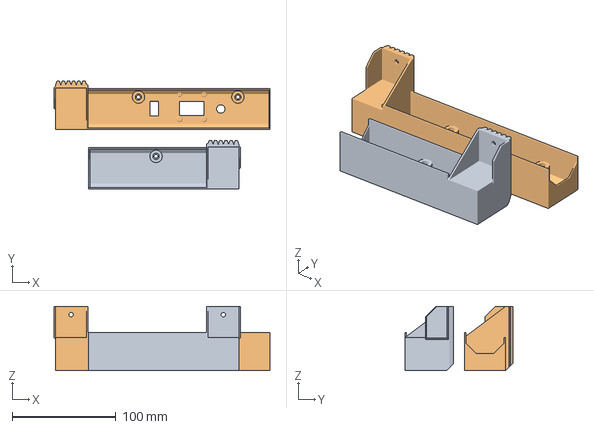
[picture p119: CAD file, 2026-06-23]
CAD/v3/panel_x3.3mf
208.5 x 104.2 x 62.0 mm
__панель1.stp
__панель3.stp
