pavluchenkor/iDryer-X/CAD/common/air-damper-air-damper-v0/STL/air_damper_diffuser.stl

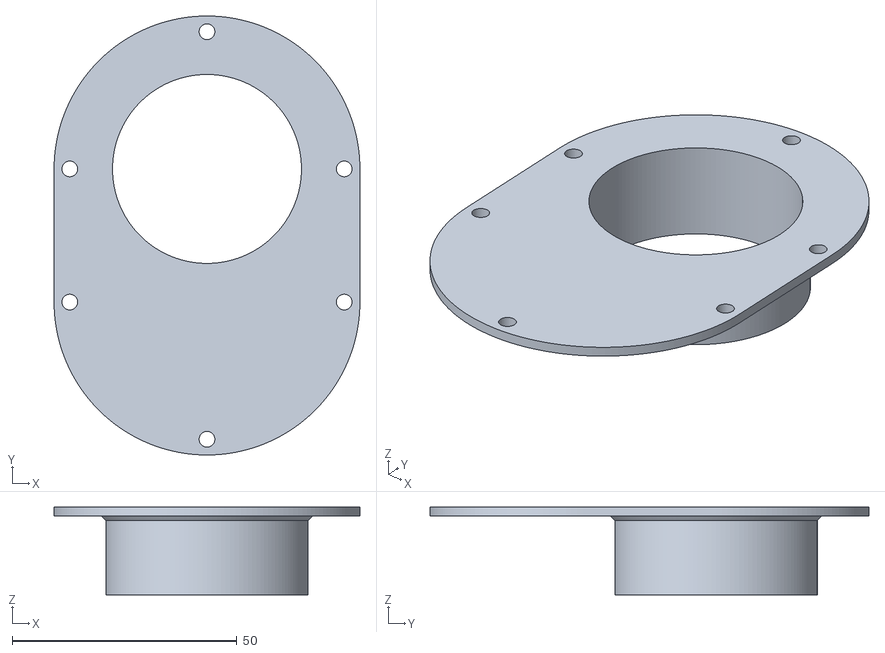
[picture p120: CAD file, 2026-06-23]
CAD/common/air-damper-air-damper-v0/STL/air_damper_diffuser.stl
68.0 x 97.6 x 19.5
