pavluchenkor/iDryer-X/CAD/common/scale-module/for cutting metal/Rollers_Holder_v1_3.DXF

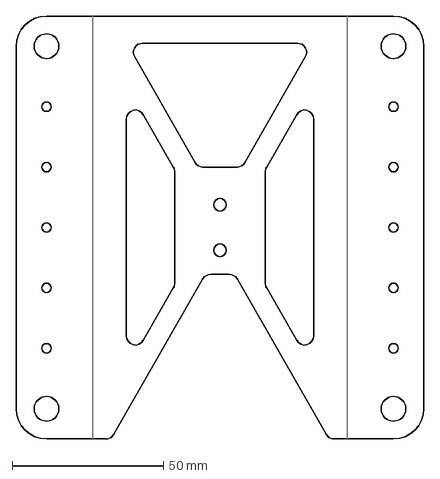
[picture p121: CAD file, 2026-06-23]
CAD/common/scale-module/for cutting metal/Rollers_Holder_v1_3.DXF
134.8 x 140.0 mm
