pavluchenkor/iDryer-X/CAD/common/scale-module/spool_holder_bending_final.stp

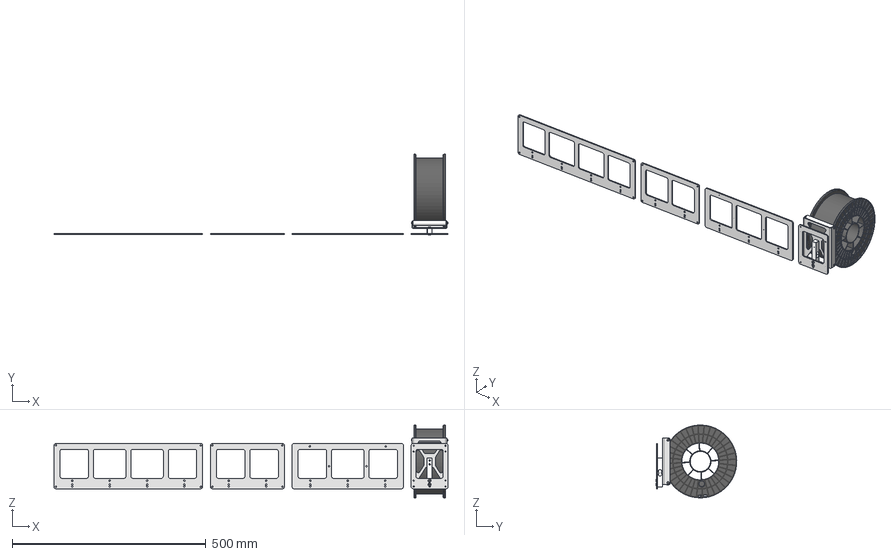
[picture p122: CAD file, 2026-06-23]
CAD/common/scale-module/spool_holder_bending_final.stp
1016.8 x 207.8 x 187.9 mm
Основание под одну катушку
FD plast spool
Ролик 623 x 2
Узкие весы гибка 623
Датчик
skf_bearing_623_2_1 x 4
ISO 7380-1 - M4 x 12 x 2
ISO 7380-1 - M3 x 8 x 4
ISO 10642 - M4 x 12 x 2
основание весов
Основание весов 2 кат
основание весов 3 кат
