pavluchenkor/iDryer-X/CAD/v3/panel_x2.3mf

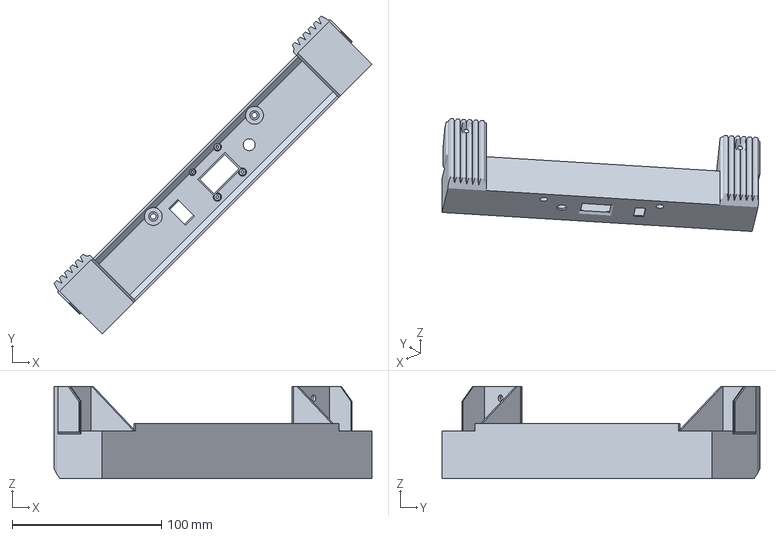
[picture p123: CAD file, 2026-06-23]
CAD/v3/panel_x2.3mf
213.3 x 213.3 x 62.0 mm
