pavluchenkor/iDryer-X/CAD/v3/iDryer_set1.3mf

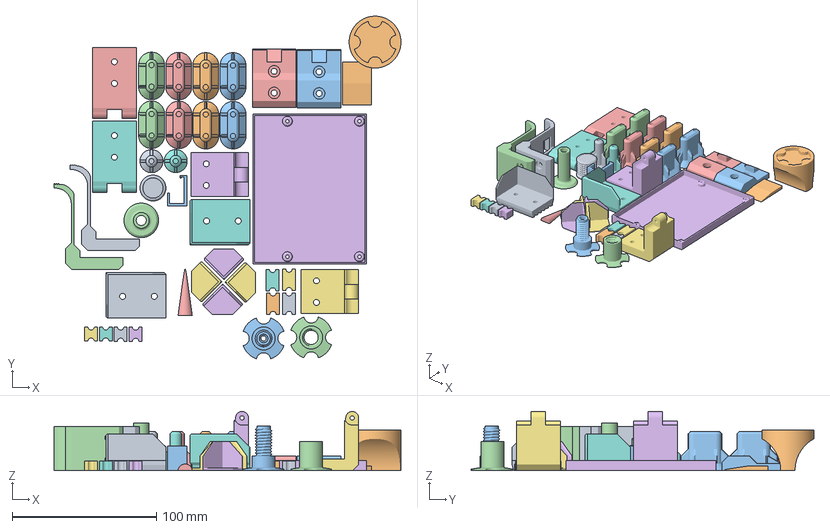
[picture p124: CAD file, 2026-06-23]
CAD/v3/iDryer_set1.3mf
240.8 x 237.9 x 41.0 mm
Knob 2.1.stp
Клин под дверь 3мм.stl
Держатель клемника.stl
Кабельный ввод печатный.stp
Кабельный ввод печатный клин.stp
Уголок защитный на клей.stp x 4
Дюбель одинарный.stp x 2
Дюбель двойной новый.stp x 8
Опора + Уголок.stp x 2
Корпус контроллера.stl
проставка на тензо датчик межосевое 15мм PA PP.stl x 4
Защелка крючок.stp x 2
Защелка.stp x 2
петля на корпус.stp x 2
петля на дверь.stp x 2
Выход филамента ключ.stp
Выход филамента 2.stp
Выход филамента 1.stp
проставка на тензо датчик межосевое 10мм.stp x 4
