pavluchenkor/iDryer-X/CAD/v3/LogoPlate.3mf

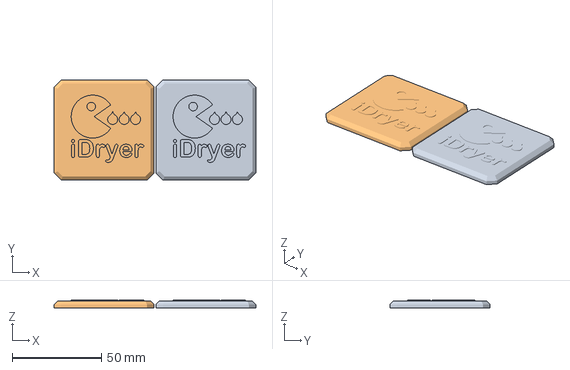
[picture p125: CAD file, 2026-06-23]
CAD/v3/LogoPlate.3mf
113.0 x 56.0 x 4.60 mm
LogoPlate без отверстий.stl x 2
