pavluchenkor/iDryer-X/CAD/v3/panel_x4.3mf

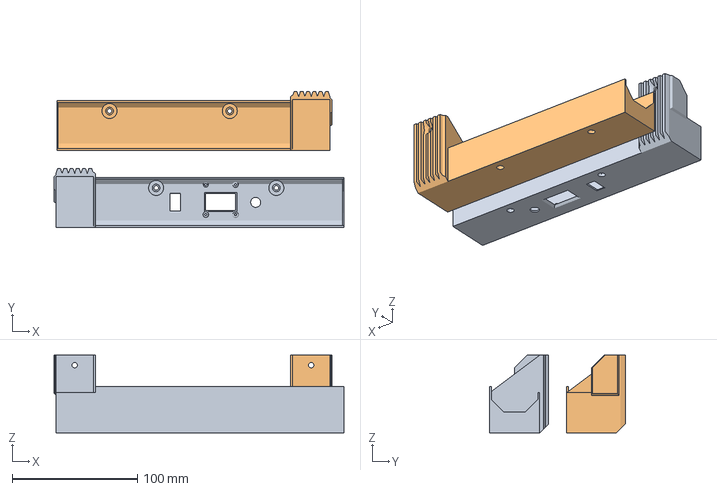
[picture p126: CAD file, 2026-06-23]
CAD/v3/panel_x4.3mf
231.5 x 108.4 x 62.0 mm
__панель1.stp
__панель2.stp
