pavluchenkor/iDryer-X/CAD/common/scale-module/SpoolHolderWeightModule.STEP

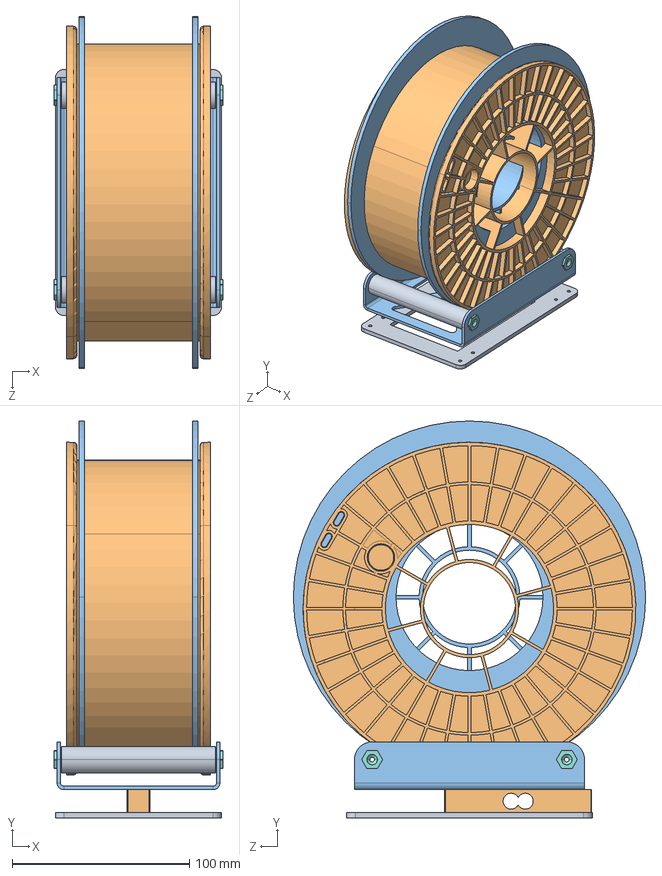
[picture p127: CAD file, 2026-06-23]
CAD/common/scale-module/SpoolHolderWeightModule.STEP
95.3 x 224.3 x 199.0 mm
Base_Single^SpoolHolderWeightModule
Sensor
Rollers_Holder
bearing_686zz x 4
Anchor x 4
Roller_tube^SpoolHolderWeightModule x 2
FD plast spool
eSun_Spool_black
