pavluchenkor/iDryer-X/(list of files, cad)

Other CAD files:
CAD/v3/DWG-LASERCUT/x2.dwg
CAD/v3/DWG-PIR/x3.dwg
CAD/v3/DWG-LASERCUT/spoolholder.dwg
CAD/v3/DWG-PIR/x4.dwg
CAD/v3/DWG-LASERCUT/x4.dwg
CAD/v3/DWG-PIR/x2.dwg
CAD/v3/DWG-LASERCUT/x3.dwg
CAD/v1/PIR_box_assembly.stp
CAD/v1/knife_fixture.stp
