pavluchenkor/iDryer-X/docs/de/v3/pcb-manual.md

# Montagehandbuch für den Regler r2.1

Mit einer einfachen Abfolge von Schritten erhalten Sie in etwa 40-60 Minuten ein vollständig montiertes Gerät.
Sie benötigen folgende Werkzeuge und Zubehör:

- Multimeter
- Lötkolben
- Lötdraht
- Lötpaste/Kolophonium
- Seitenschneider/Kneifzange
- Alkohol zum Reinigen der Leiterplatte nach dem Löten
- Kleine Bürste (z. B. Zahnbürste) zum Reinigen der Leiterplatte nach dem Löten
- Praktisch ist auch eine „dritte Hand" oder ein Schraubstock

!!! warning "Vor der Montage ist es notwendig, die Ausgangsspannung des MP1584-Wandlers auf 5,1 V einzustellen und den Frequenzwahlwiderstand am hx711 umzulöten"

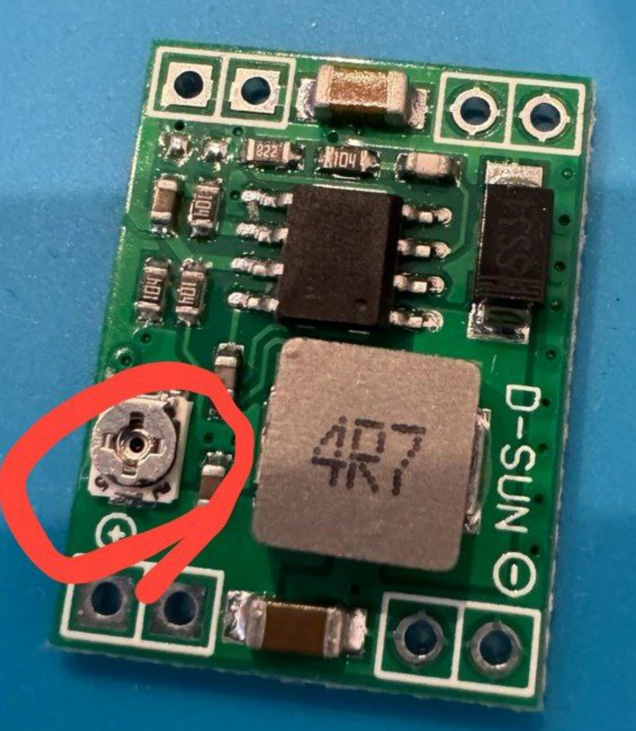
[picture p128: docs/img/pcb-manual/163940.png]

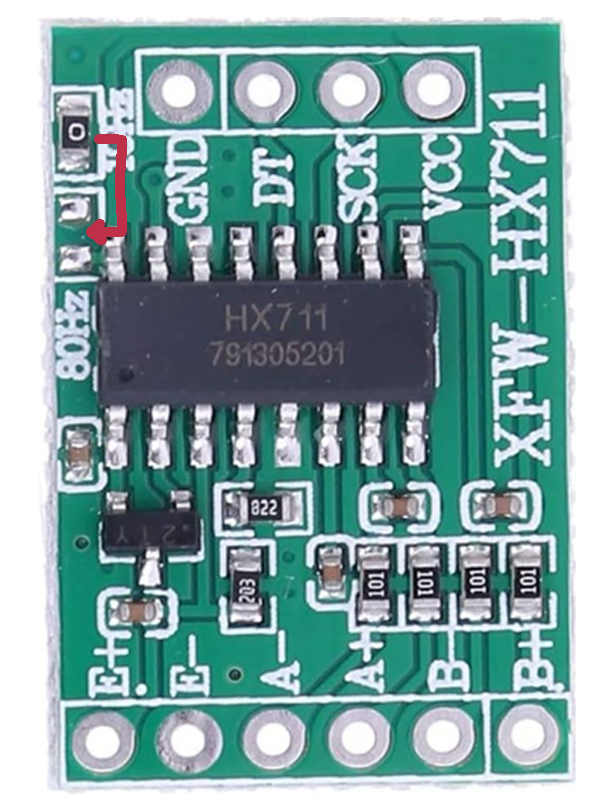
[picture p129: docs/img/pcb-manual/1647101.png]


### Montageschritte

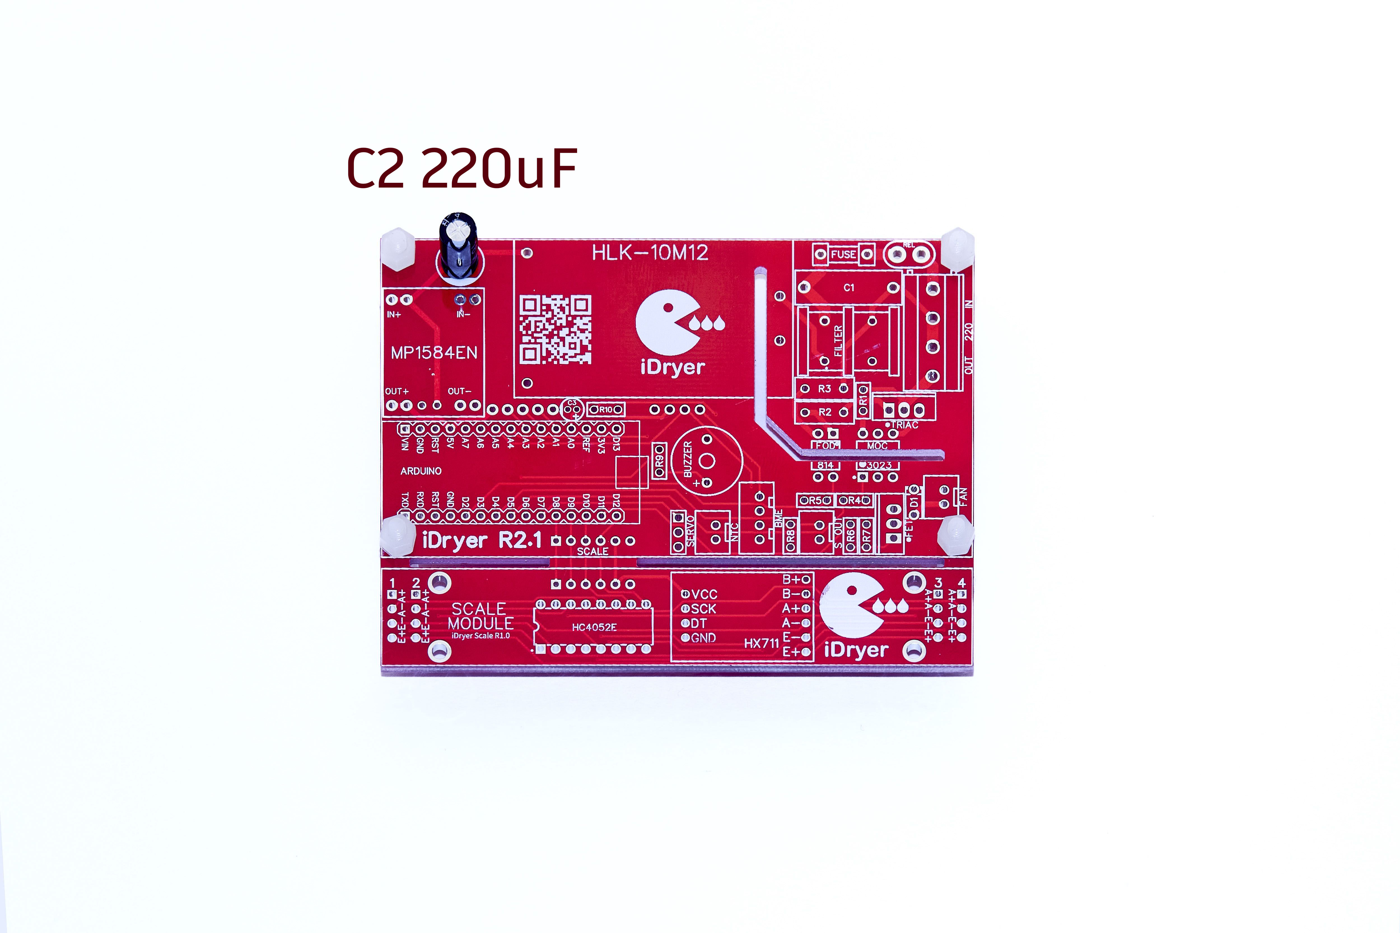
[picture p130: docs/img/pcb-manual/IMG_1411.jpg]

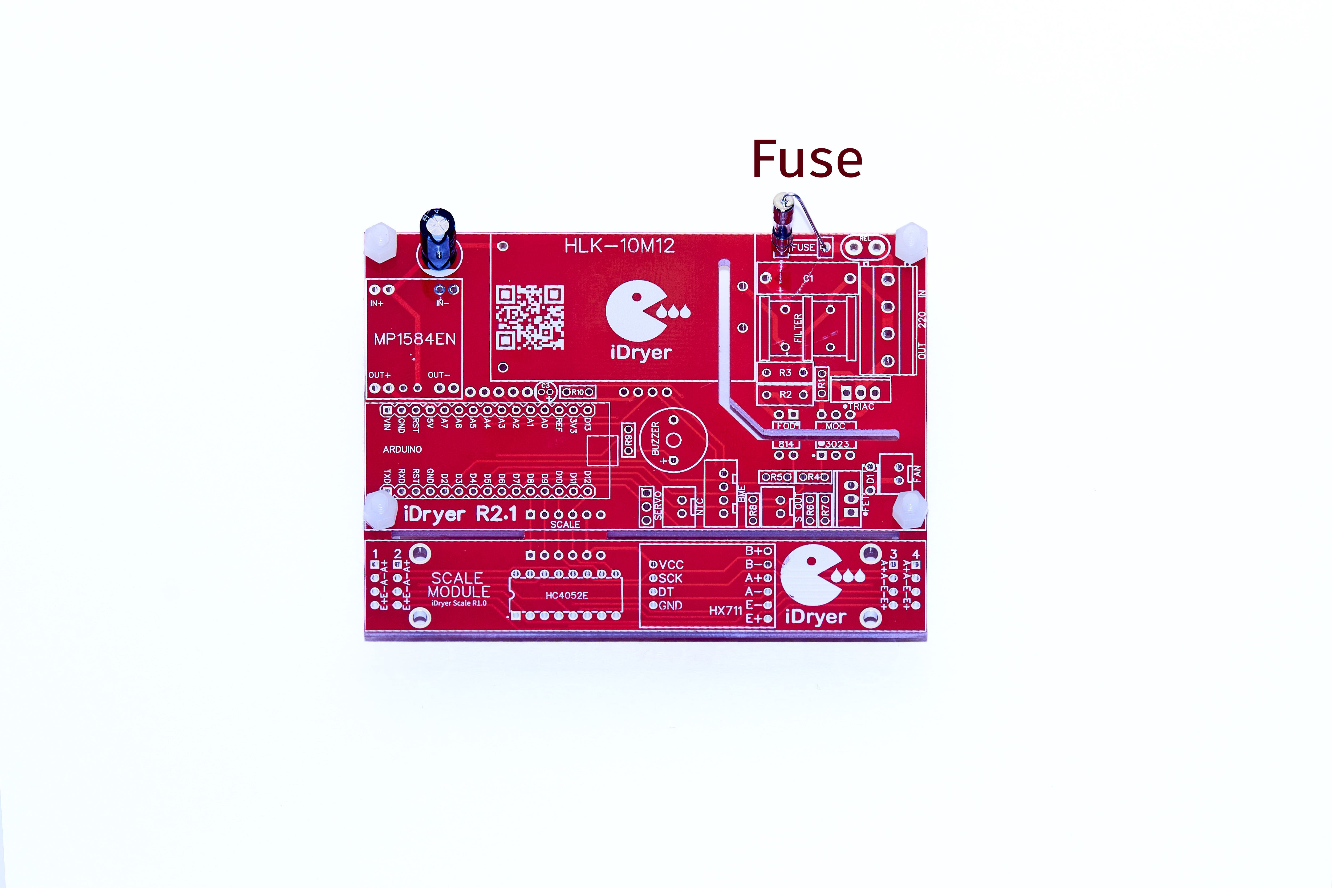
[picture p131: docs/img/pcb-manual/IMG_1412.jpg]

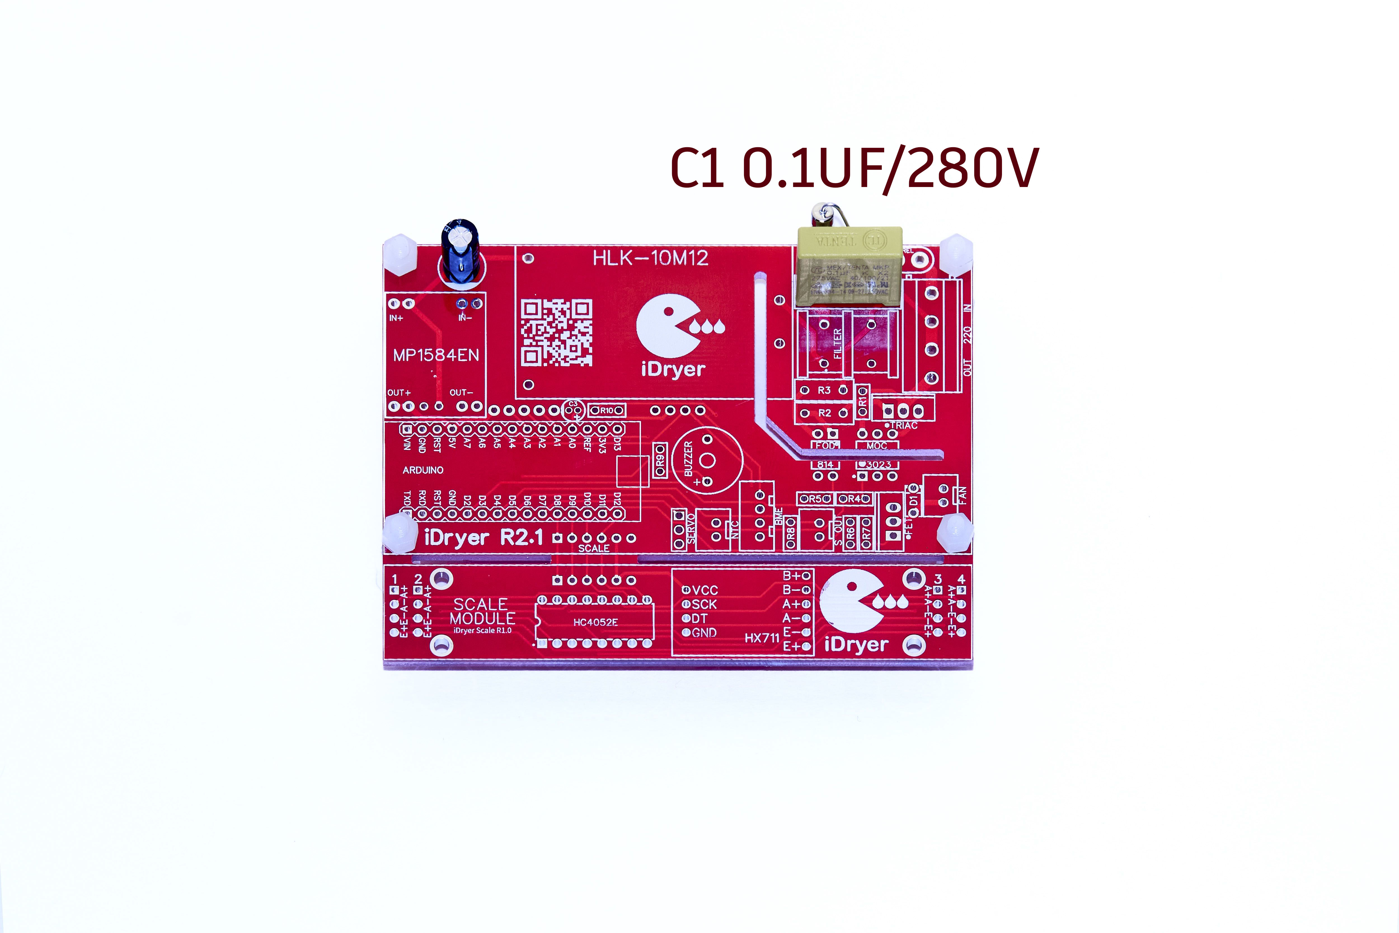
[picture p132: docs/img/pcb-manual/IMG_1413.jpg]

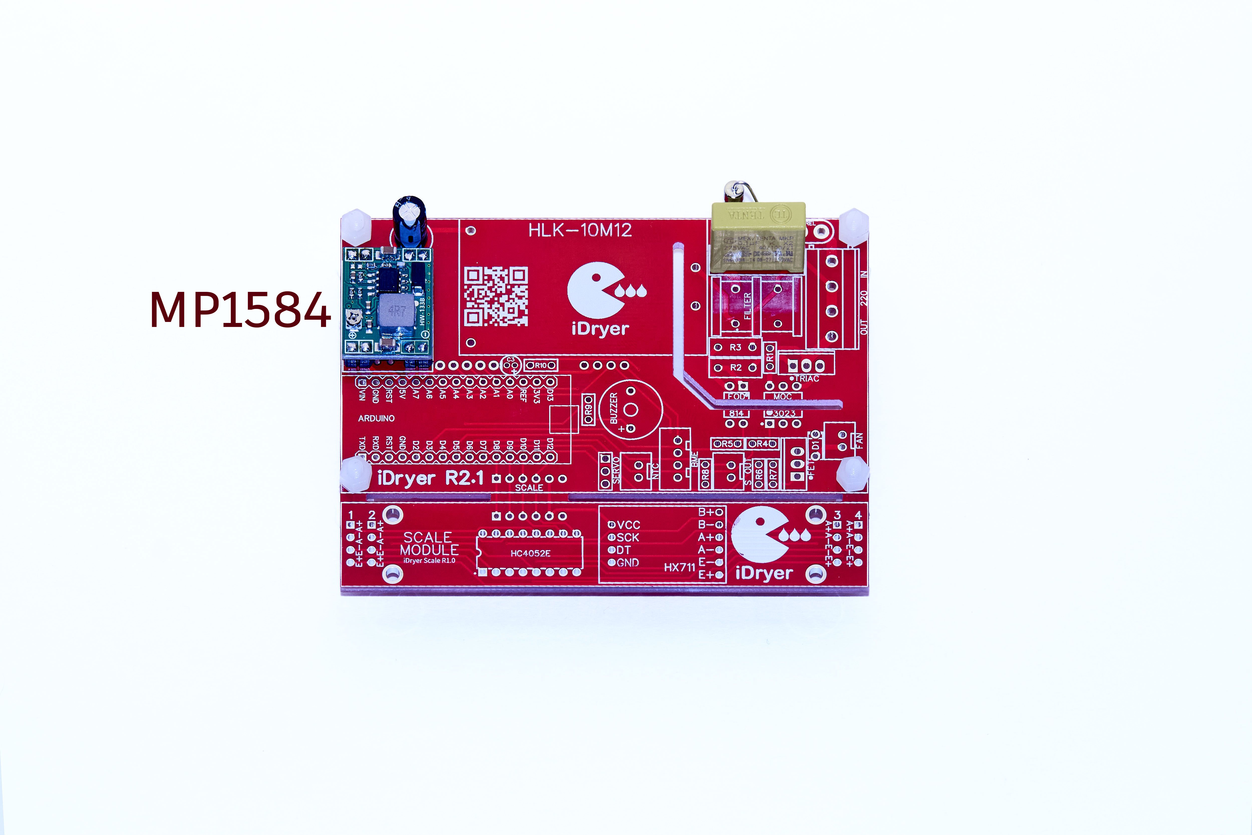
[picture p133: docs/img/pcb-manual/IMG_1414.jpg]

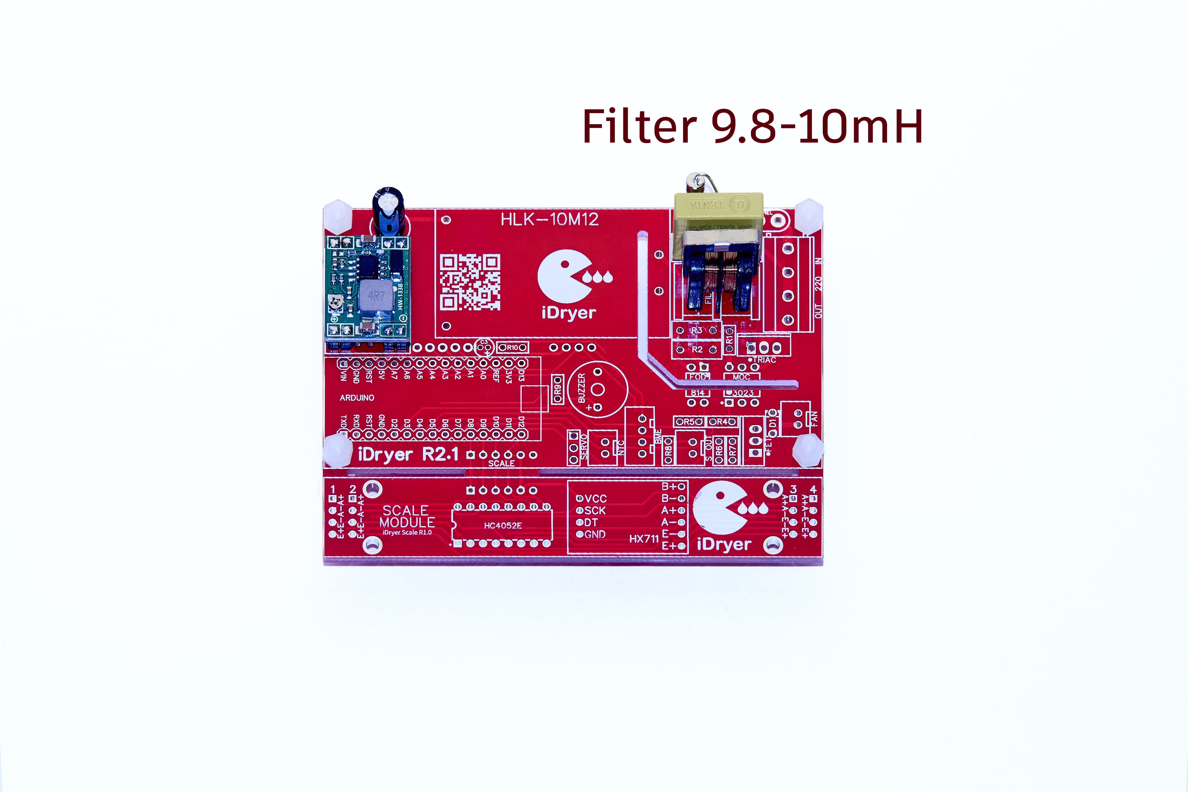
[picture p134: docs/img/pcb-manual/IMG_1415.jpg]

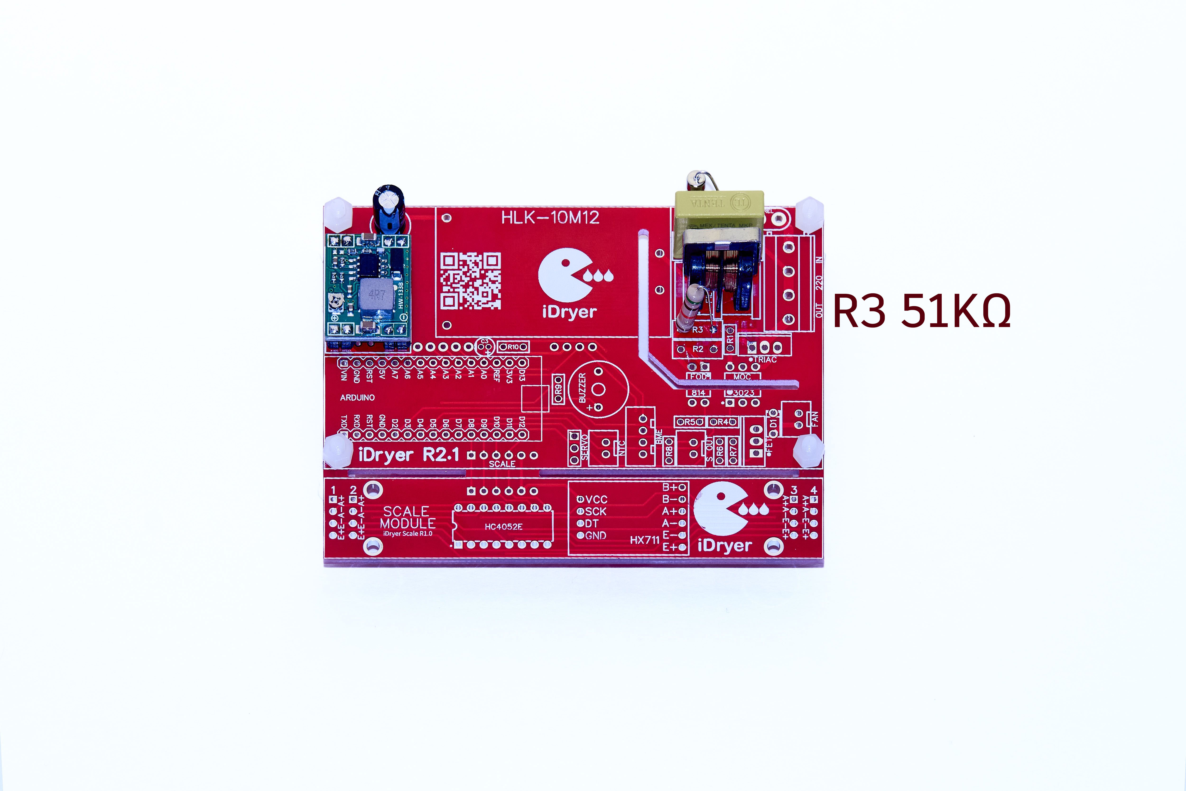
[picture p135: docs/img/pcb-manual/IMG_1416.jpg]

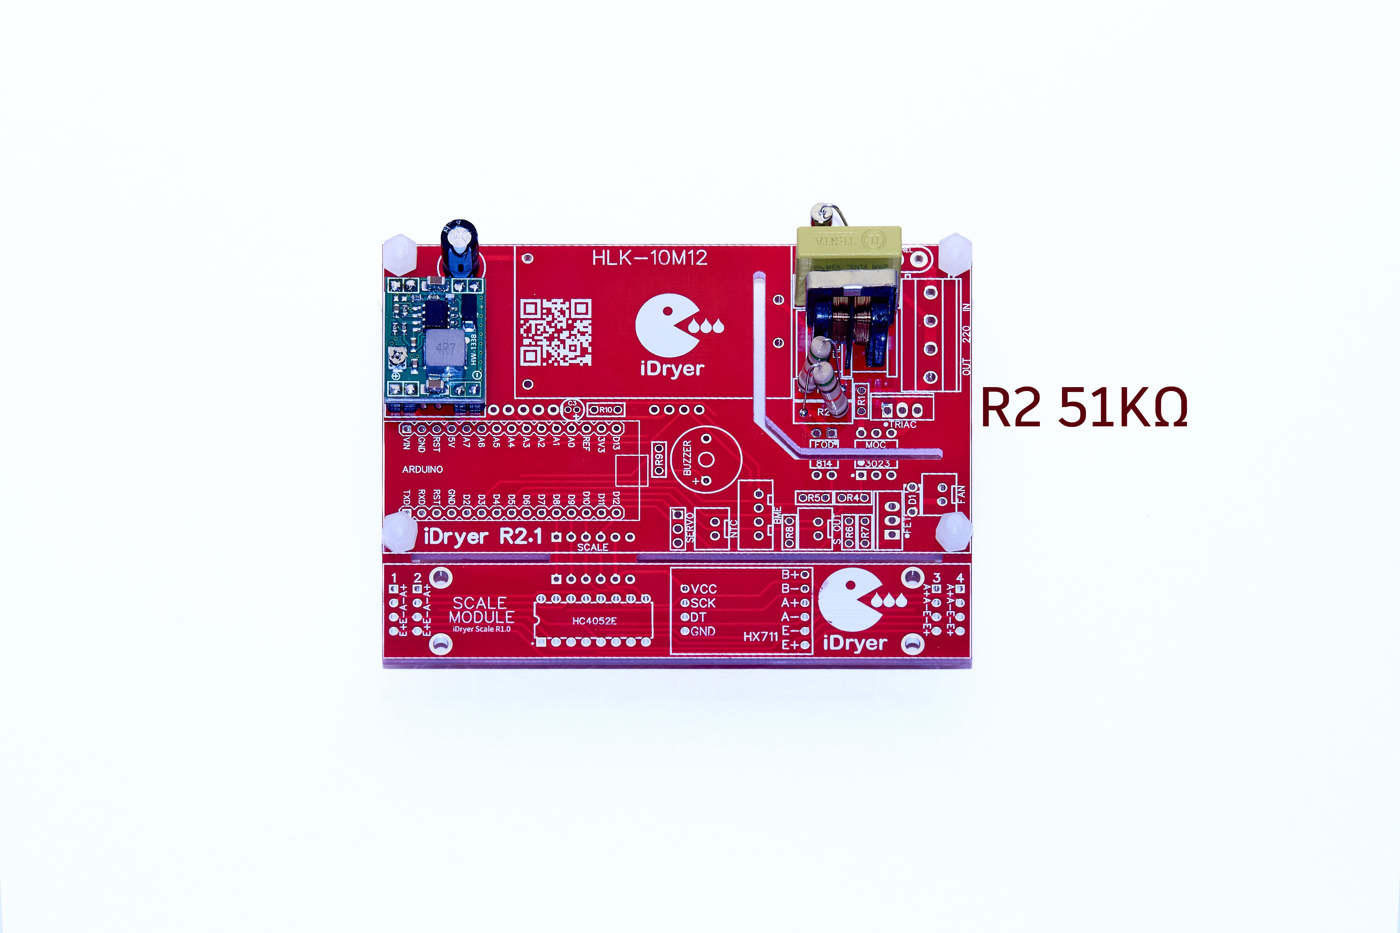
[picture p136: docs/img/pcb-manual/IMG_1417.jpg]

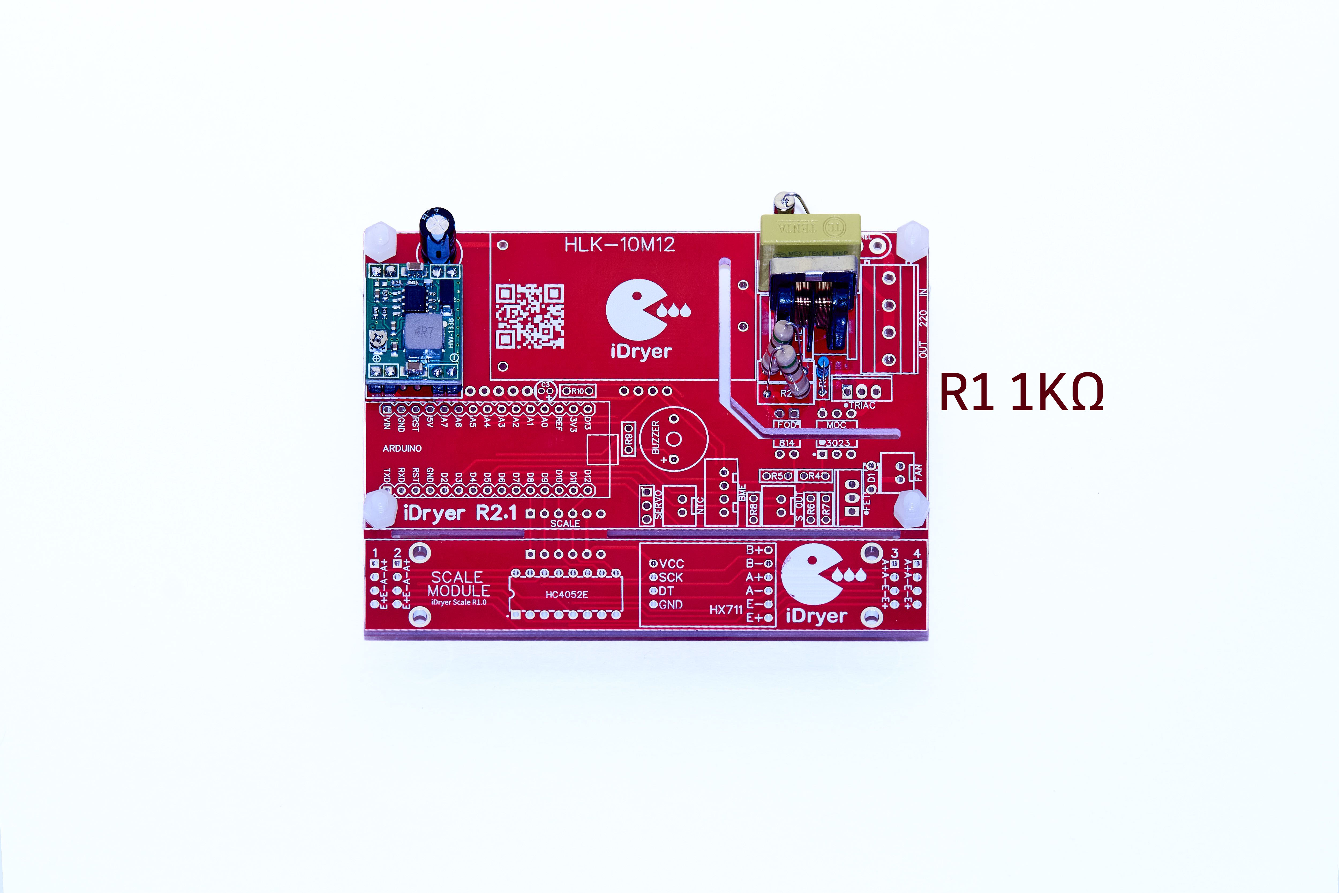
[picture p137: docs/img/pcb-manual/IMG_1418.jpg]

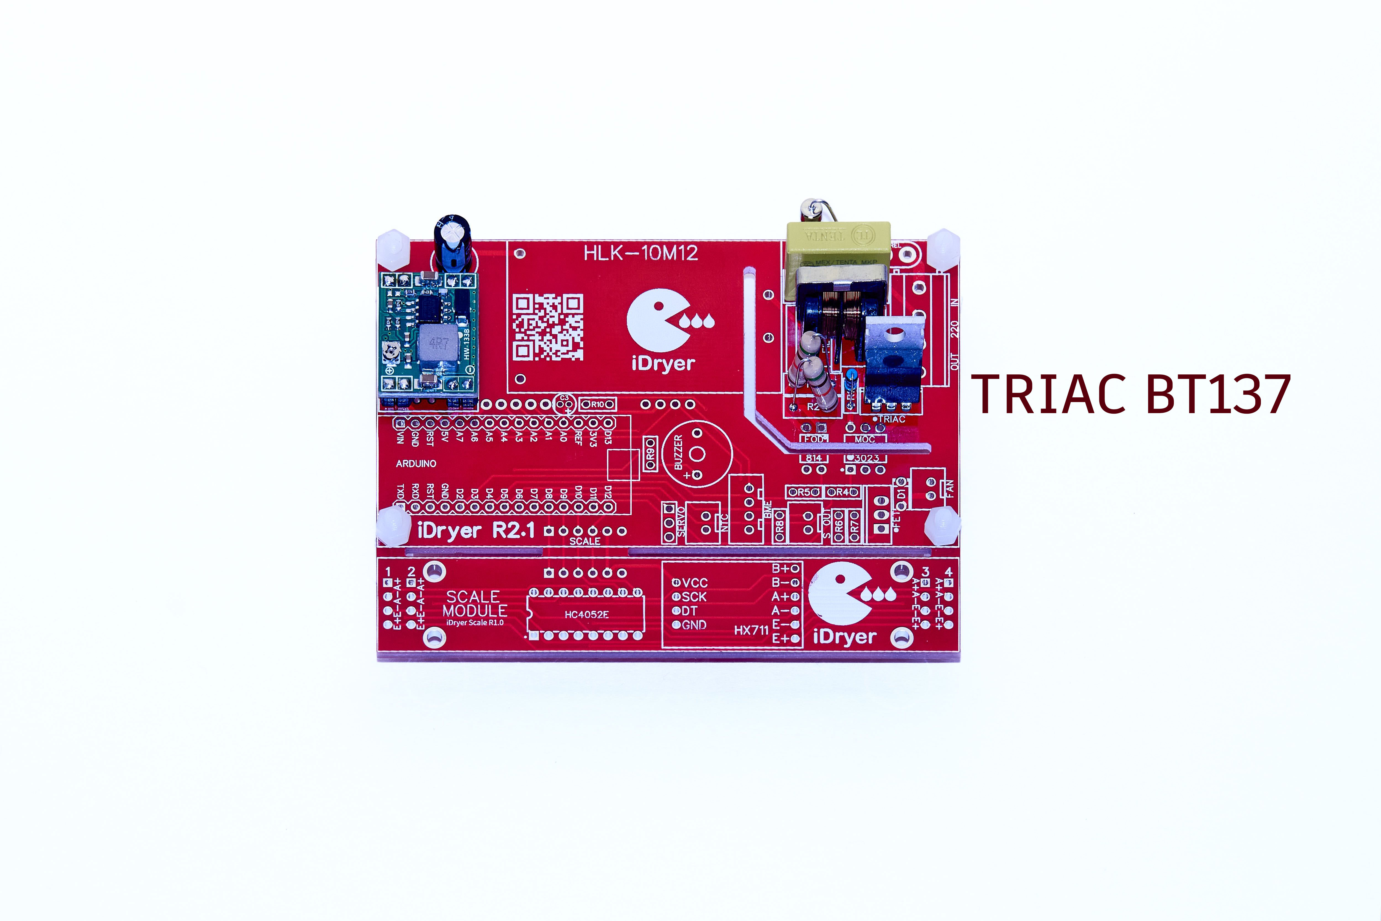
[picture p138: docs/img/pcb-manual/IMG_1419.jpg]

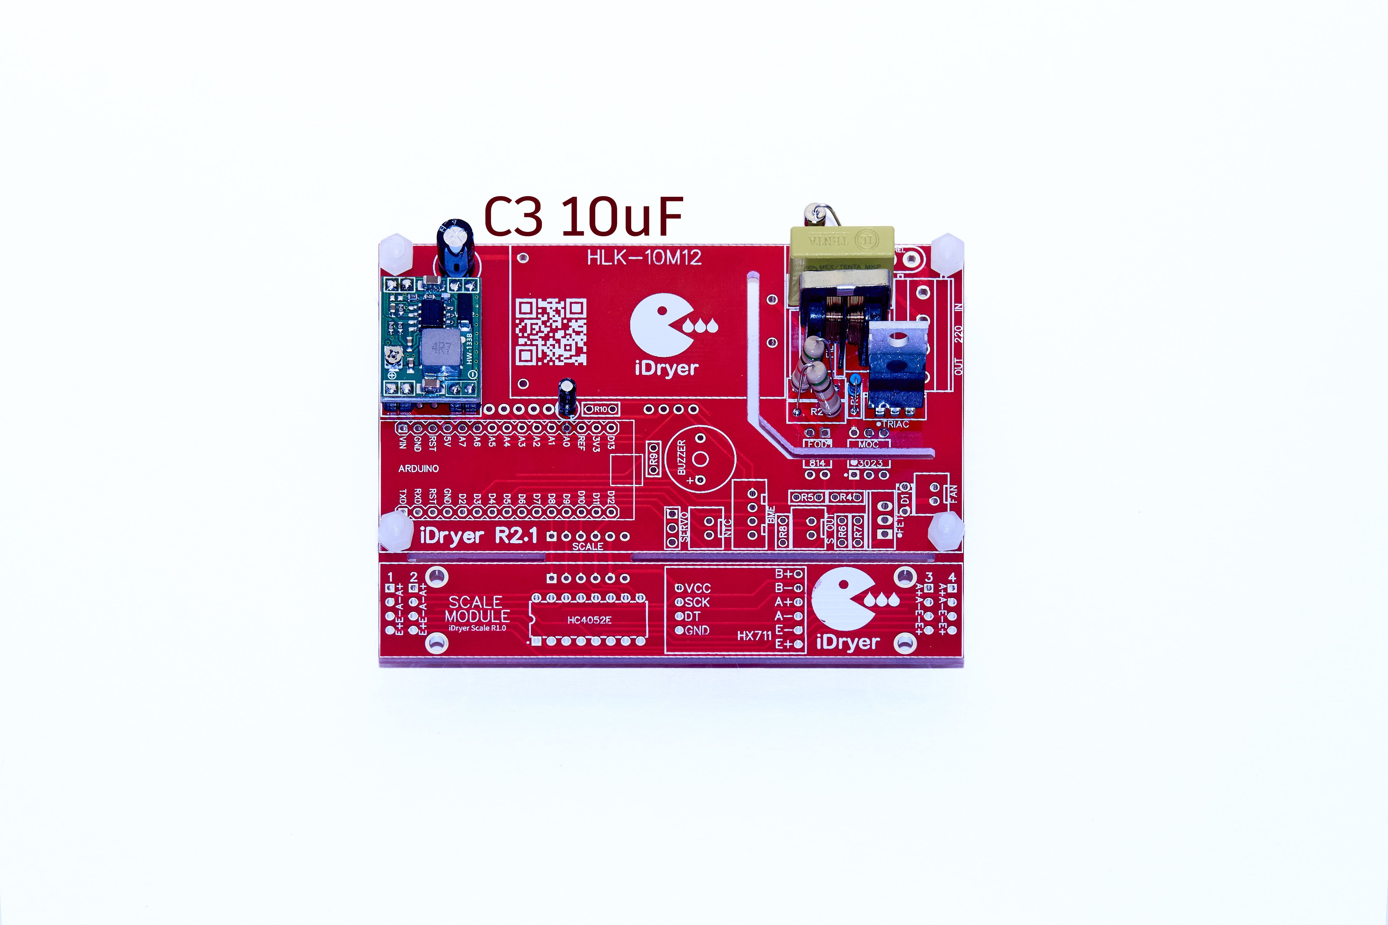
[picture p139: docs/img/pcb-manual/IMG_1420.jpg]

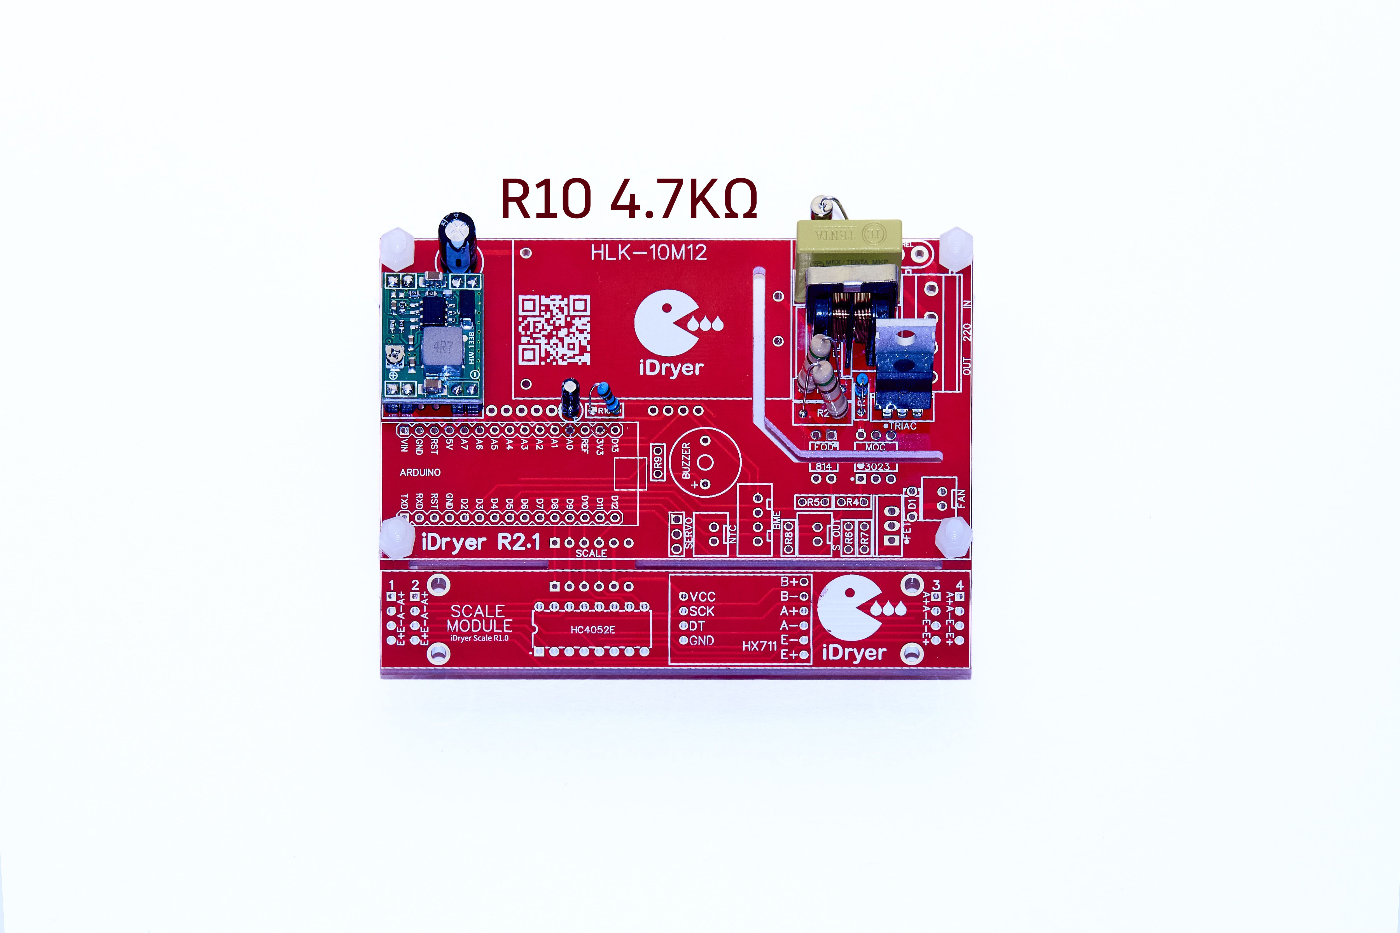
[picture p140: docs/img/pcb-manual/IMG_1421.jpg]

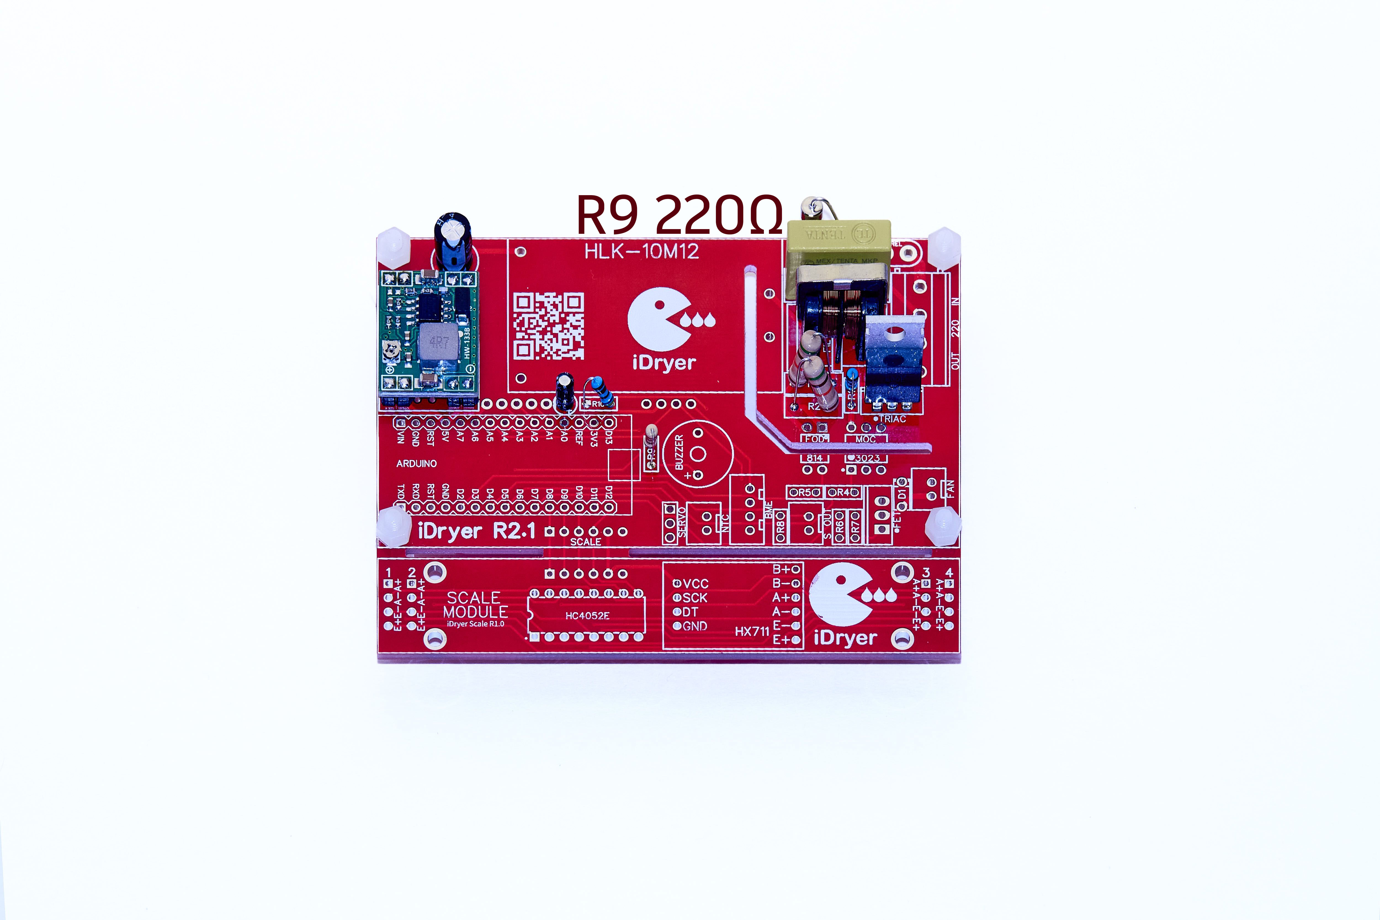
[picture p141: docs/img/pcb-manual/IMG_1422.jpg]

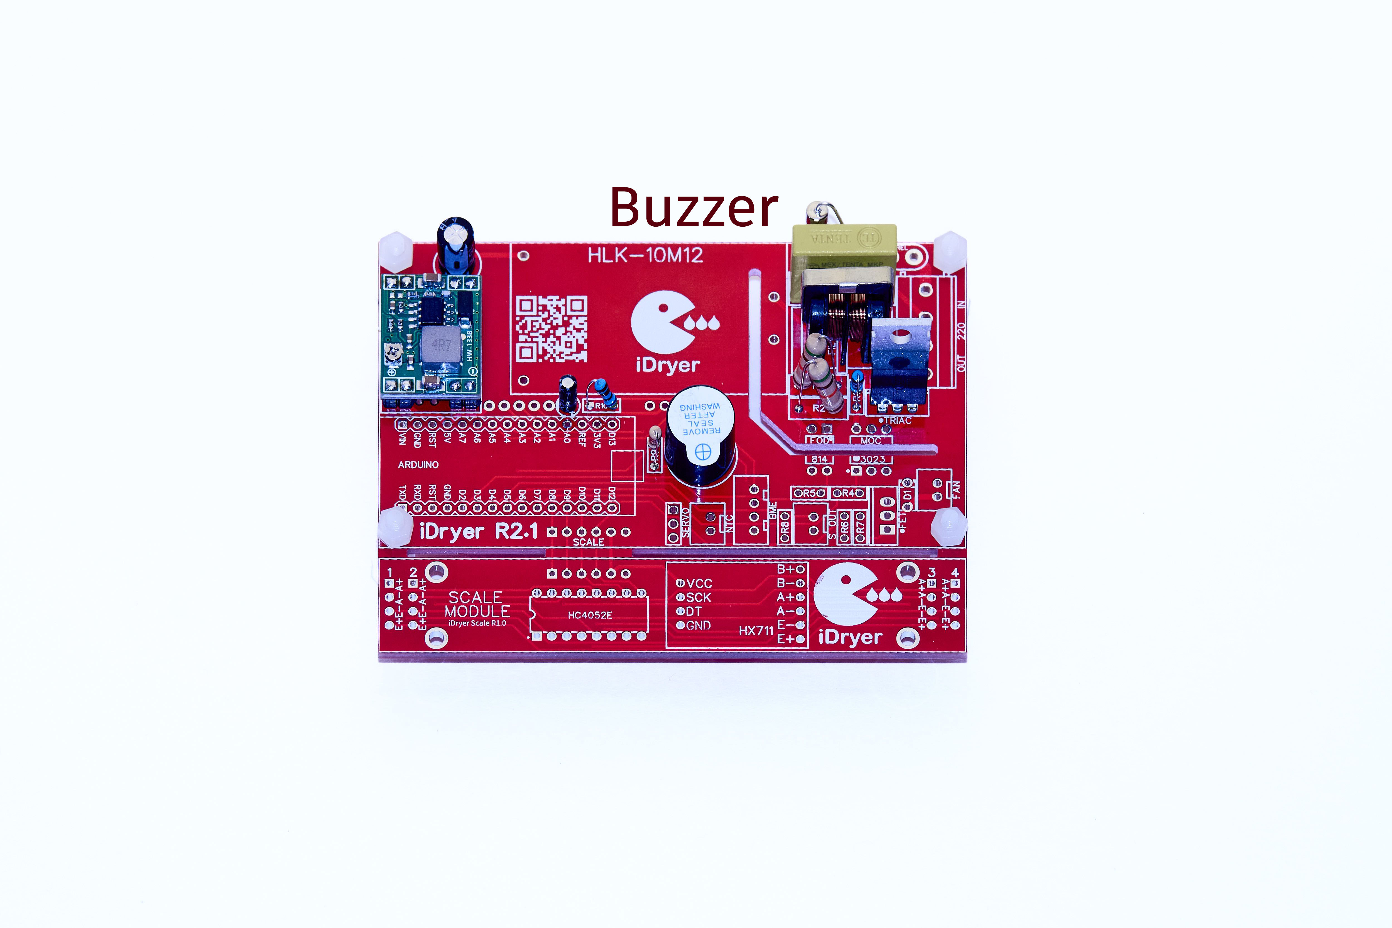
[picture p142: docs/img/pcb-manual/IMG_1423.jpg]

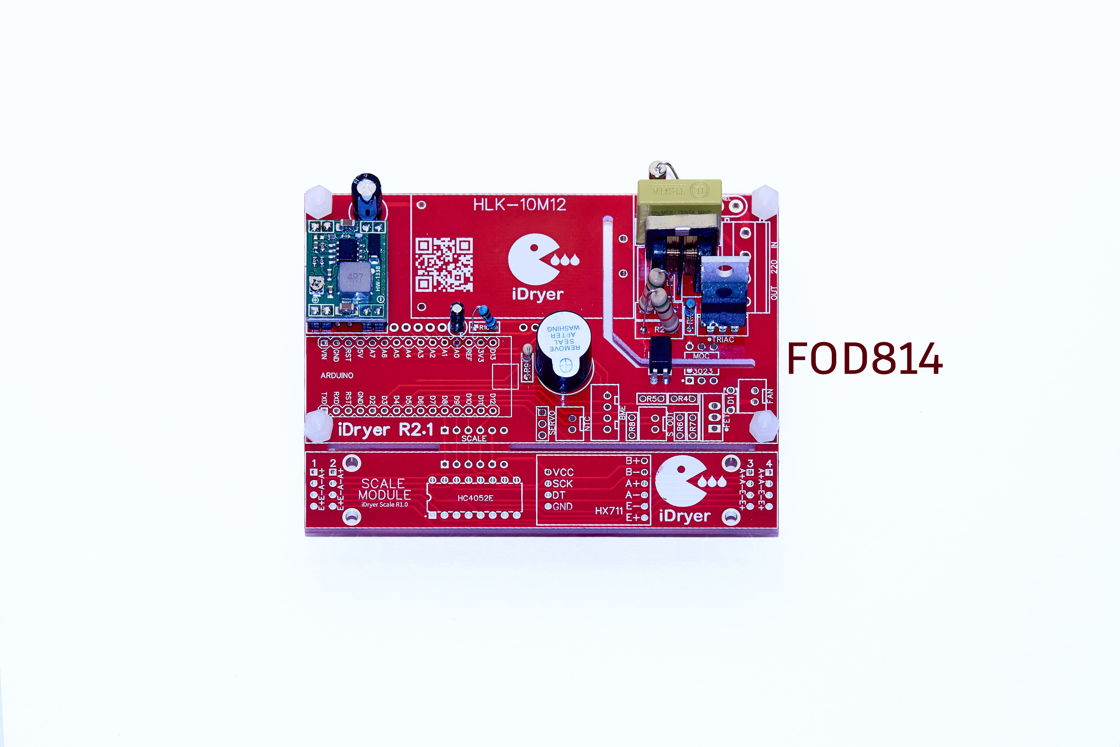
[picture p143: docs/img/pcb-manual/IMG_1424.jpg]

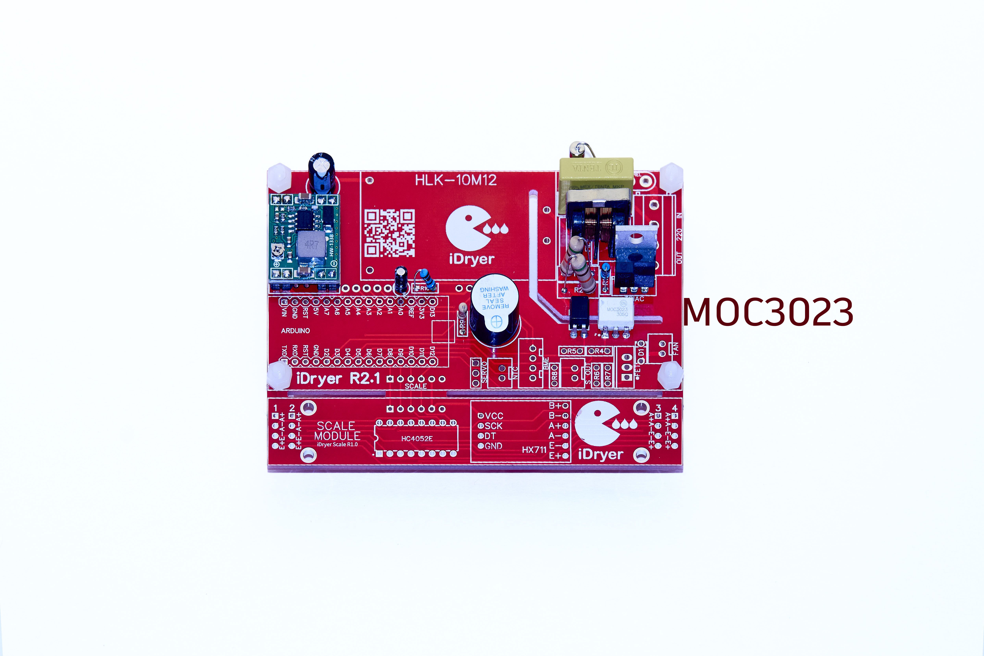
[picture p144: docs/img/pcb-manual/IMG_1425.jpg]

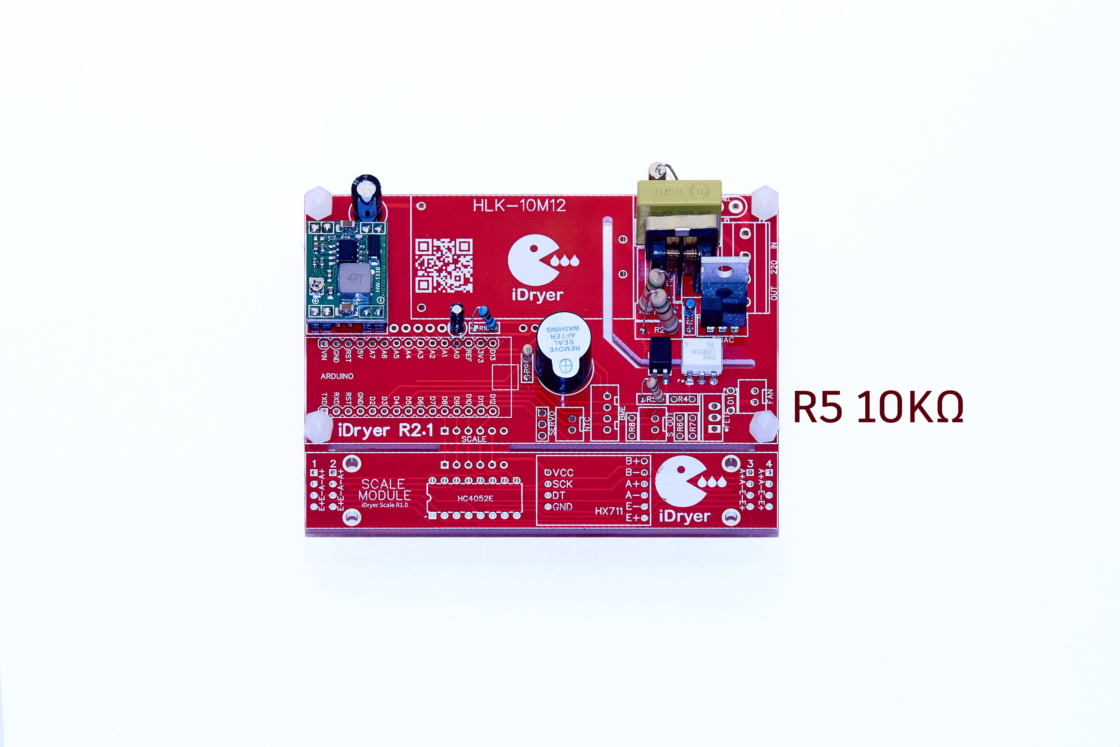
[picture p145: docs/img/pcb-manual/IMG_1426.jpg]

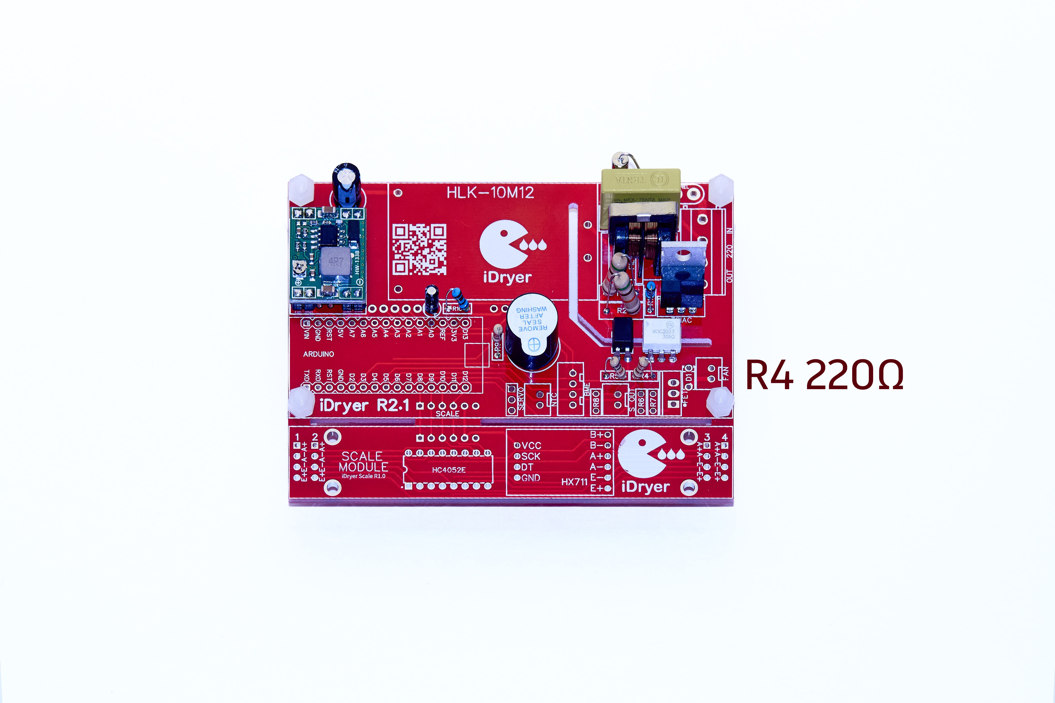
[picture p146: docs/img/pcb-manual/IMG_1427.jpg]

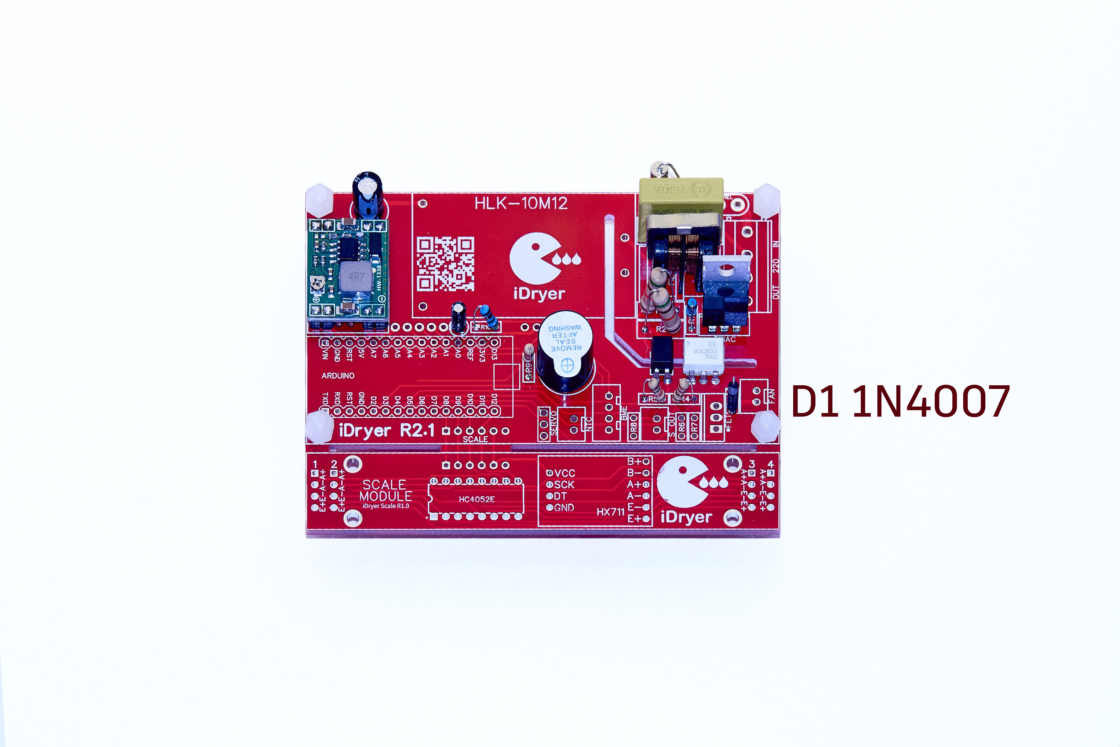
[picture p147: docs/img/pcb-manual/IMG_1428.jpg]

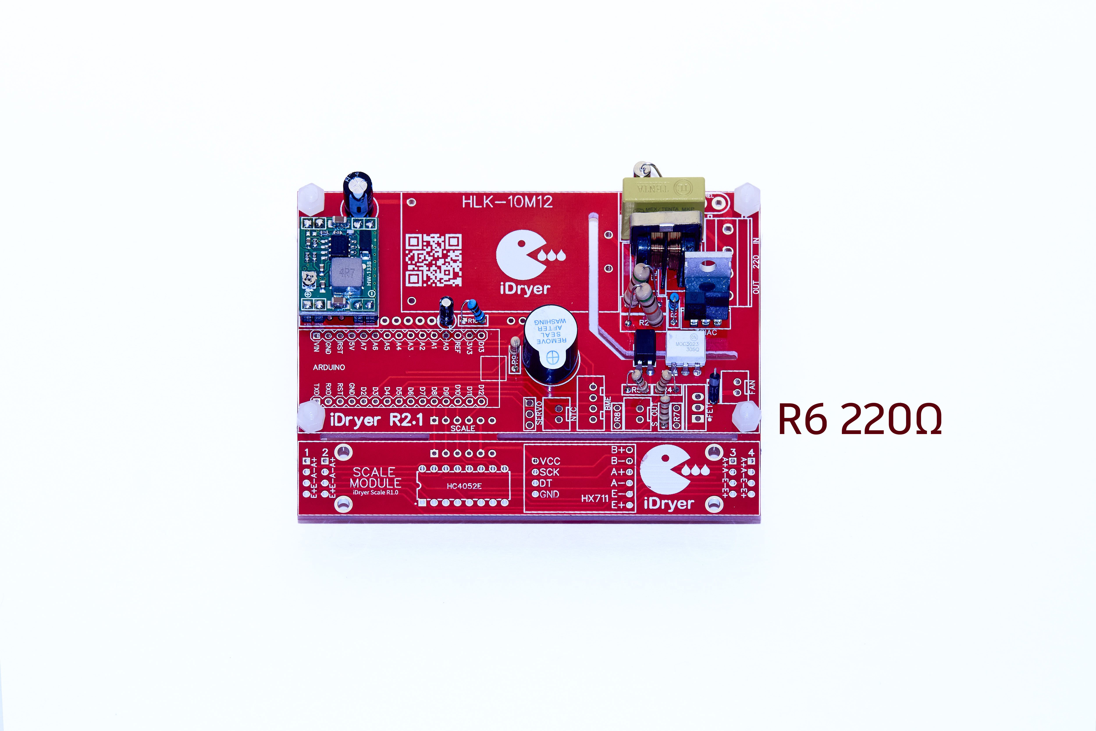
[picture p148: docs/img/pcb-manual/IMG_1429.jpg]

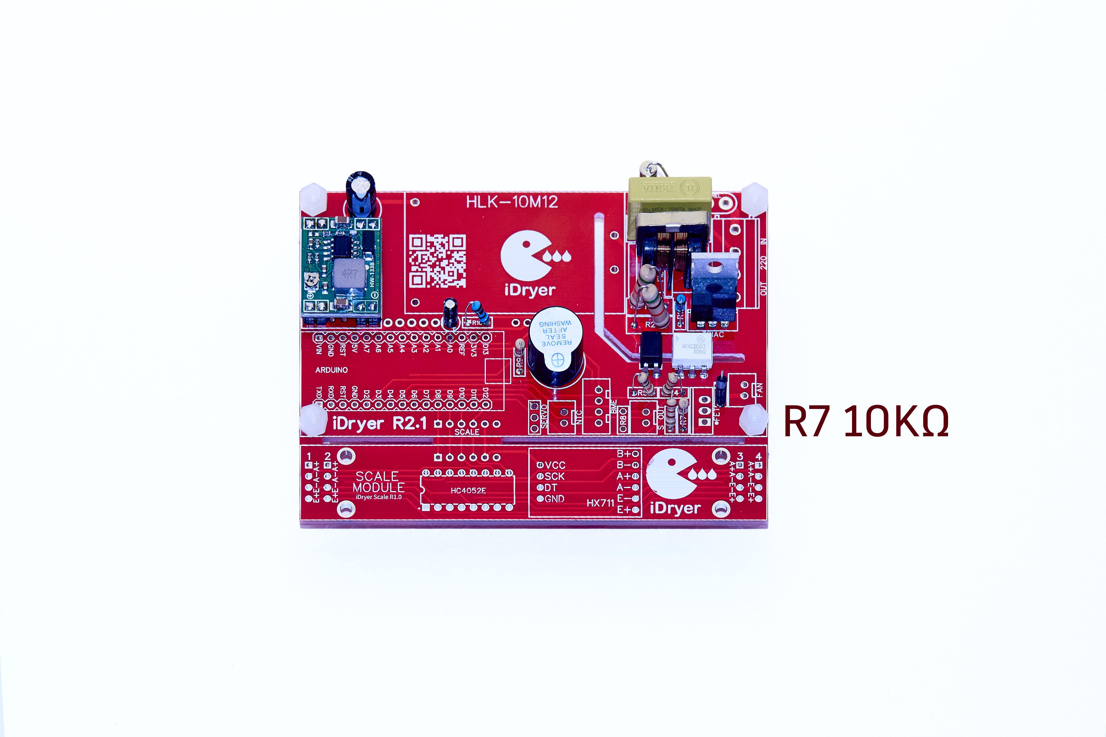
[picture p149: docs/img/pcb-manual/IMG_1430.jpg]

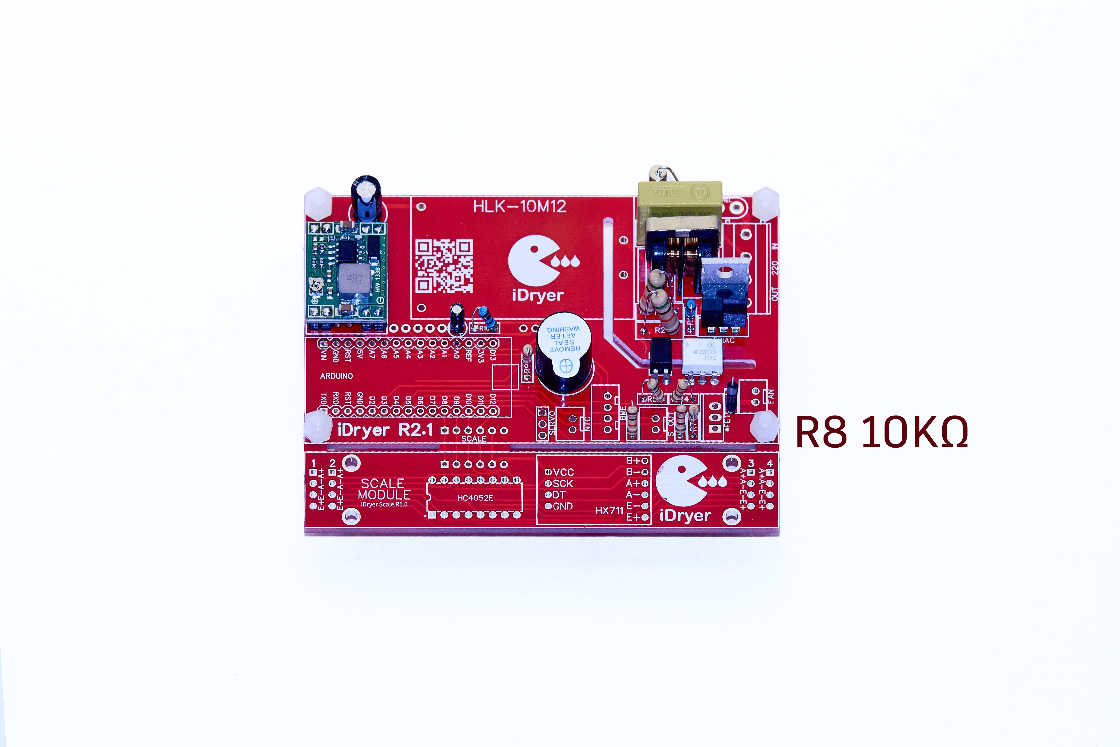
[picture p150: docs/img/pcb-manual/IMG_1431.jpg]

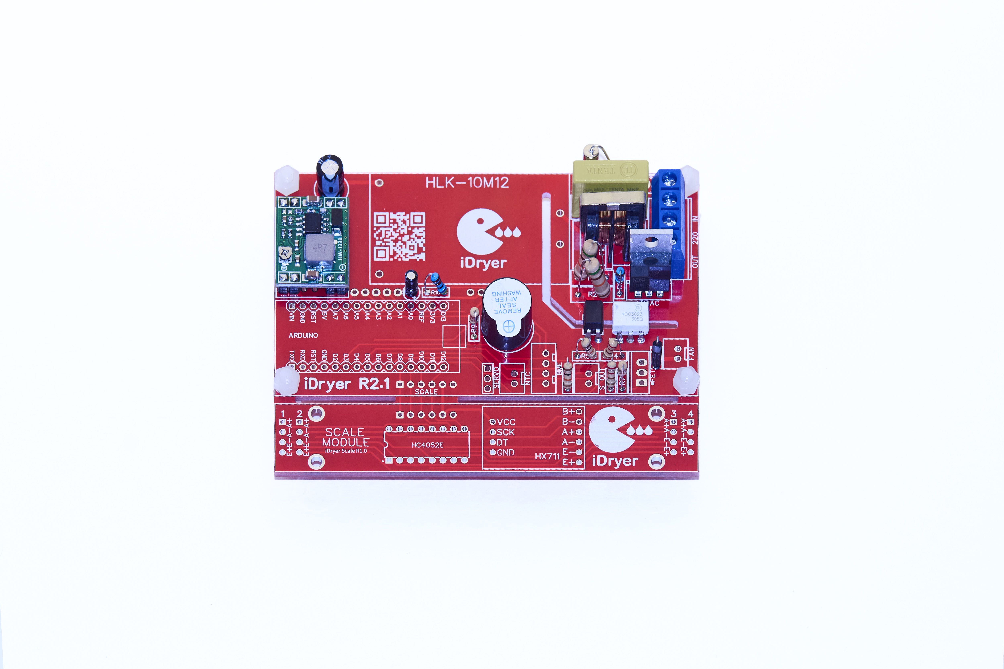
[picture p151: docs/img/pcb-manual/IMG_1432.jpg]

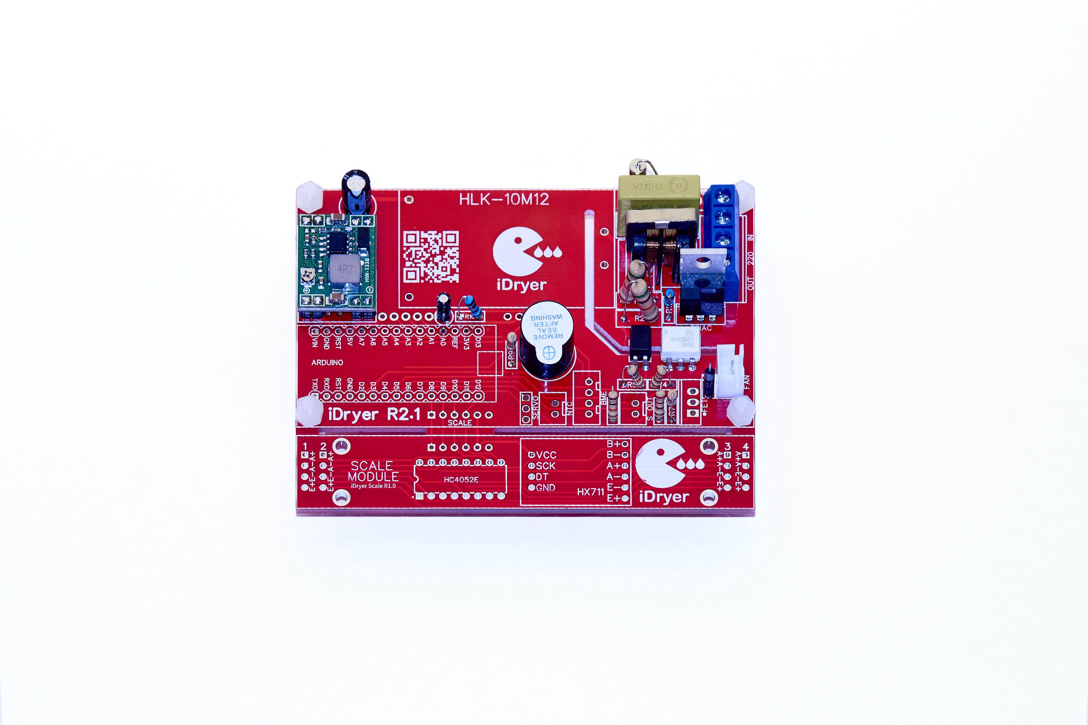
[picture p152: docs/img/pcb-manual/IMG_1433.jpg]

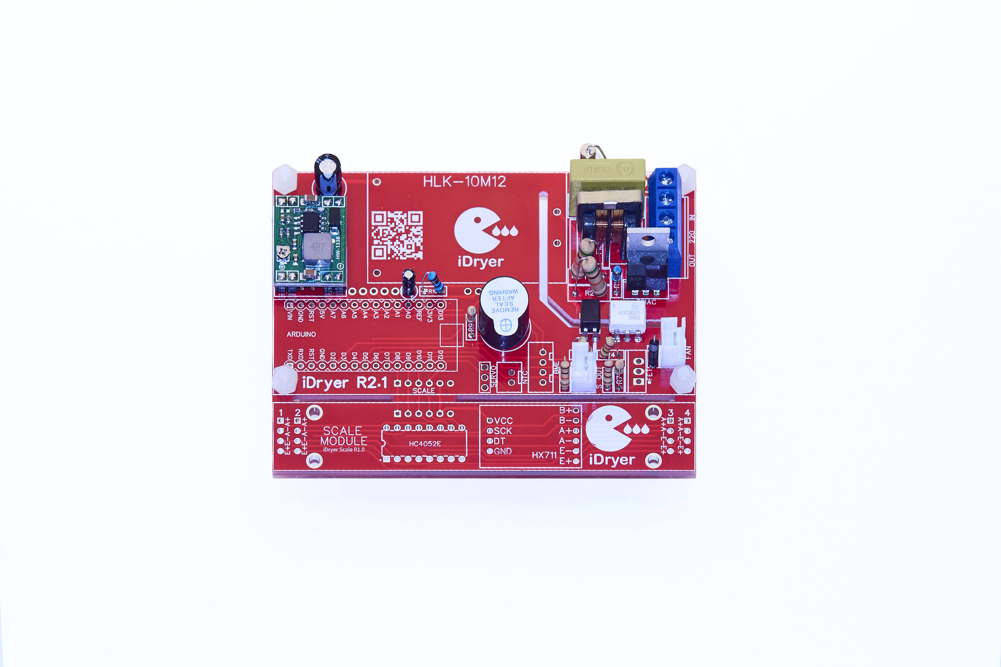
[picture p153: docs/img/pcb-manual/IMG_1434.jpg]

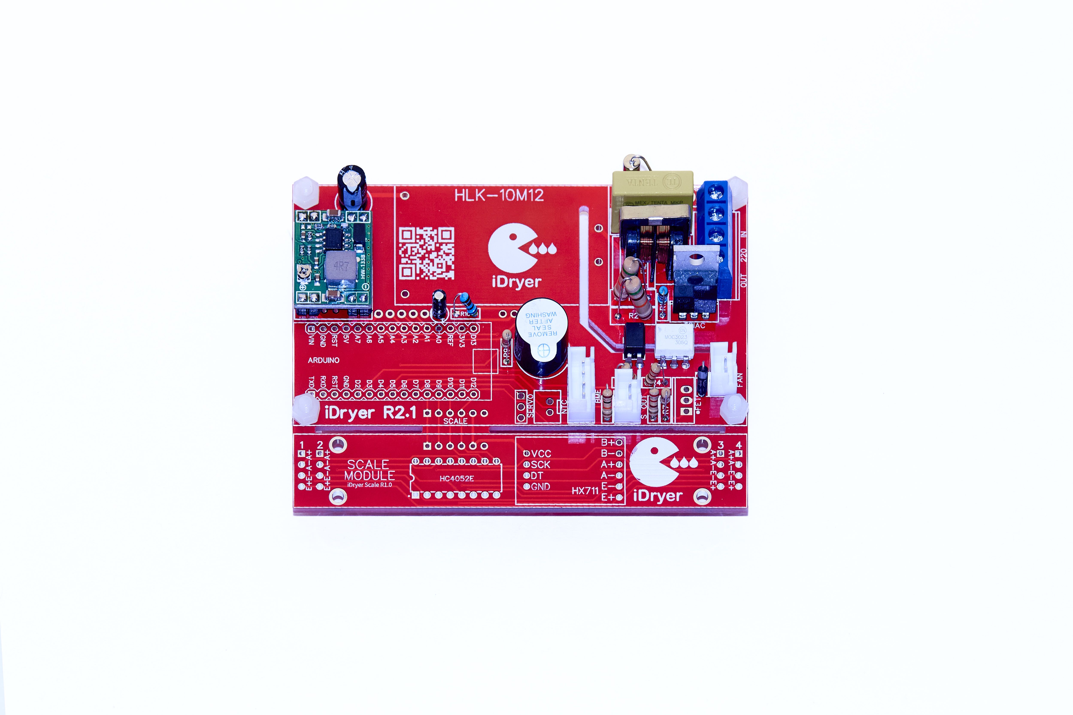
[picture p154: docs/img/pcb-manual/IMG_1435.jpg]

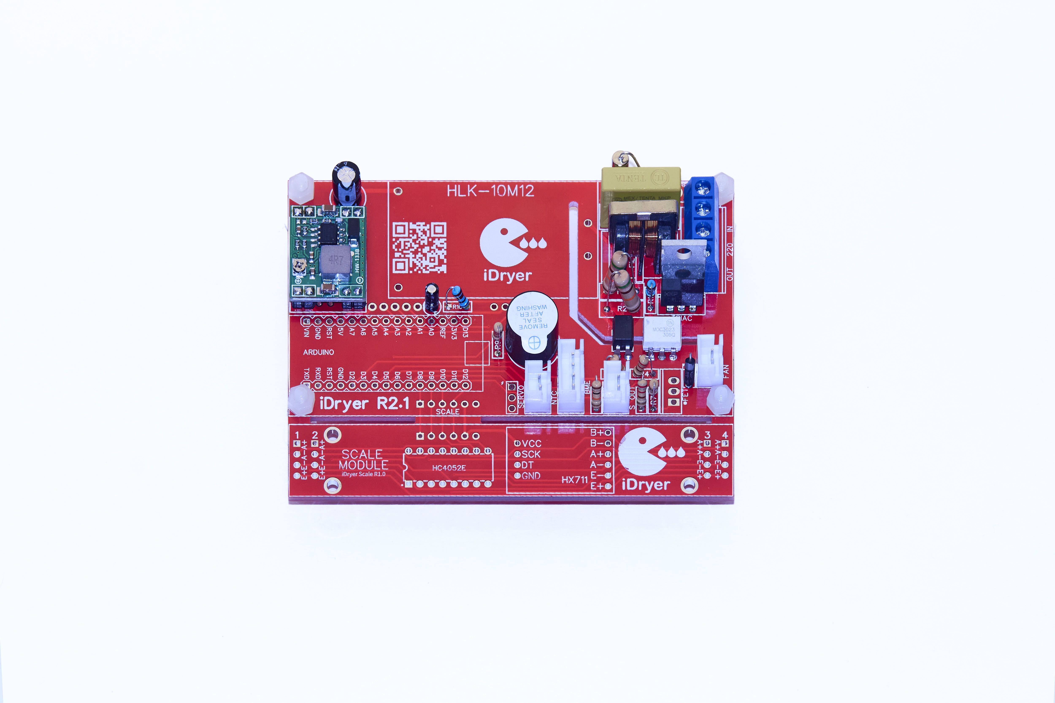
[picture p155: docs/img/pcb-manual/IMG_1436.jpg]

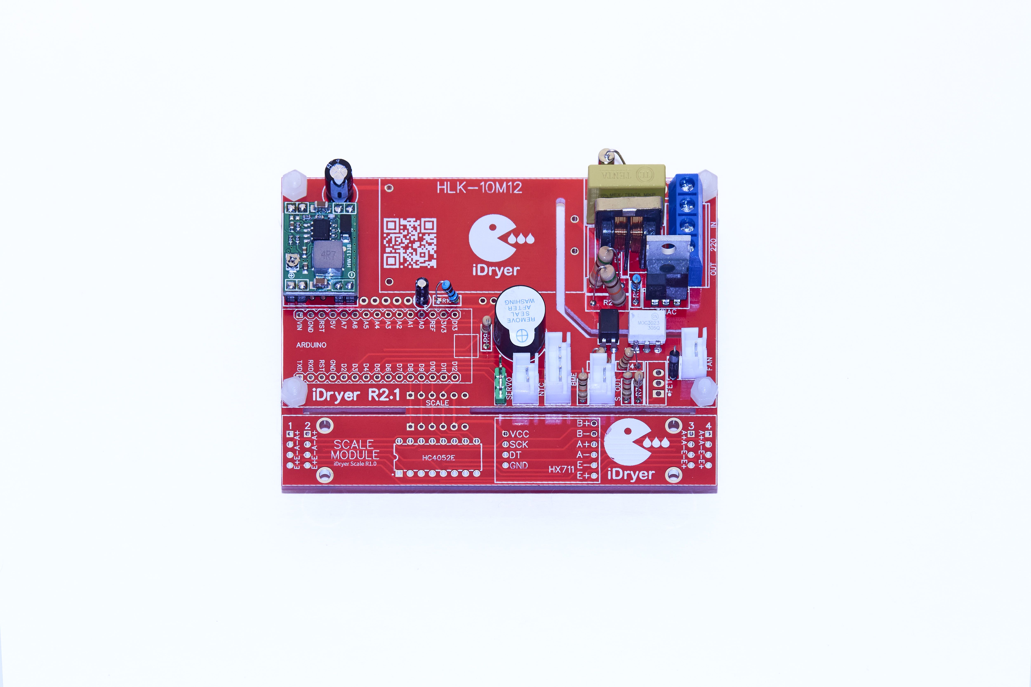
[picture p156: docs/img/pcb-manual/IMG_1437.jpg]

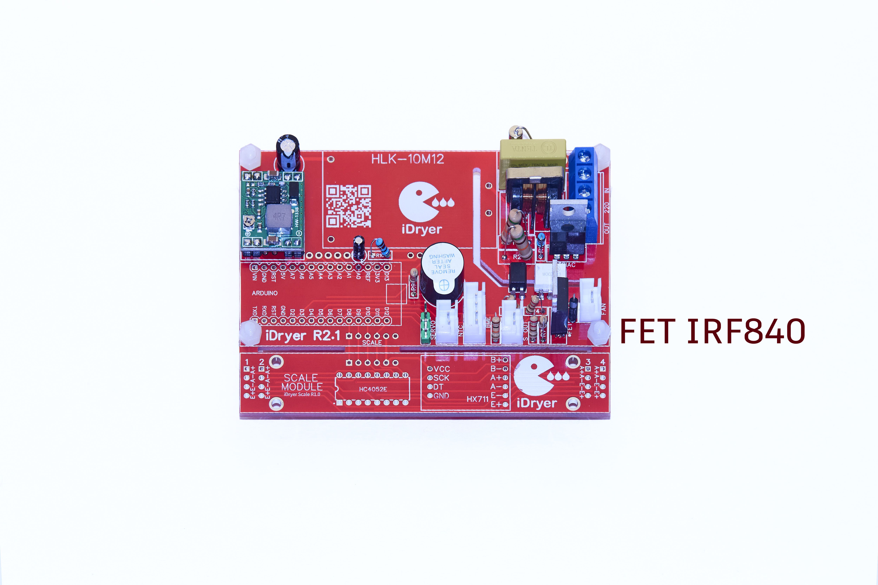
[picture p157: docs/img/pcb-manual/IMG_1438.jpg]

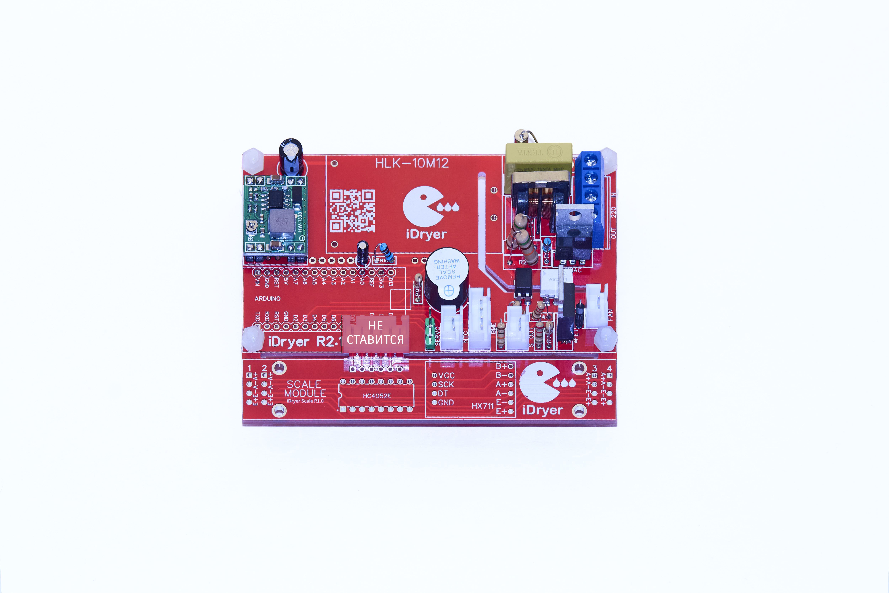
[picture p158: docs/img/pcb-manual/IMG_1439.jpg]

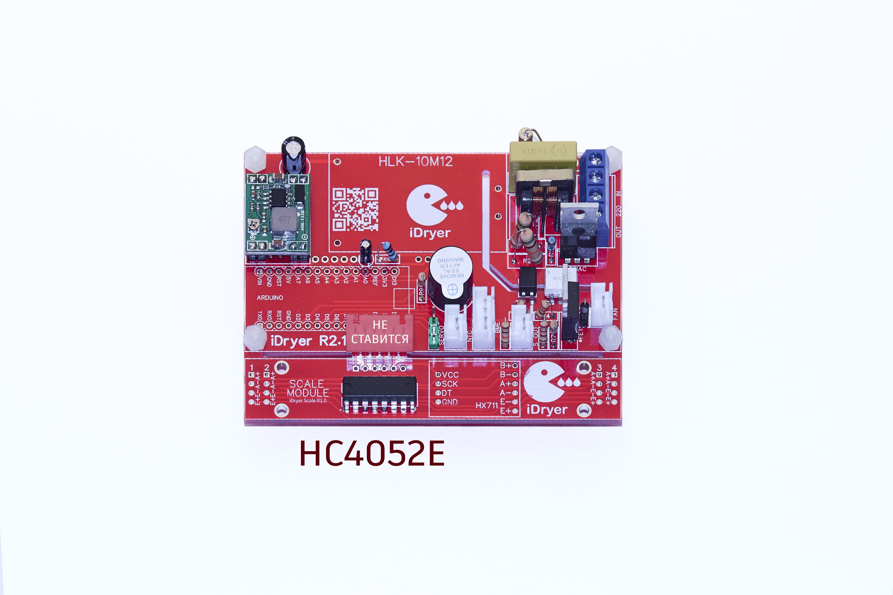
[picture p159: docs/img/pcb-manual/IMG_1440.jpg]

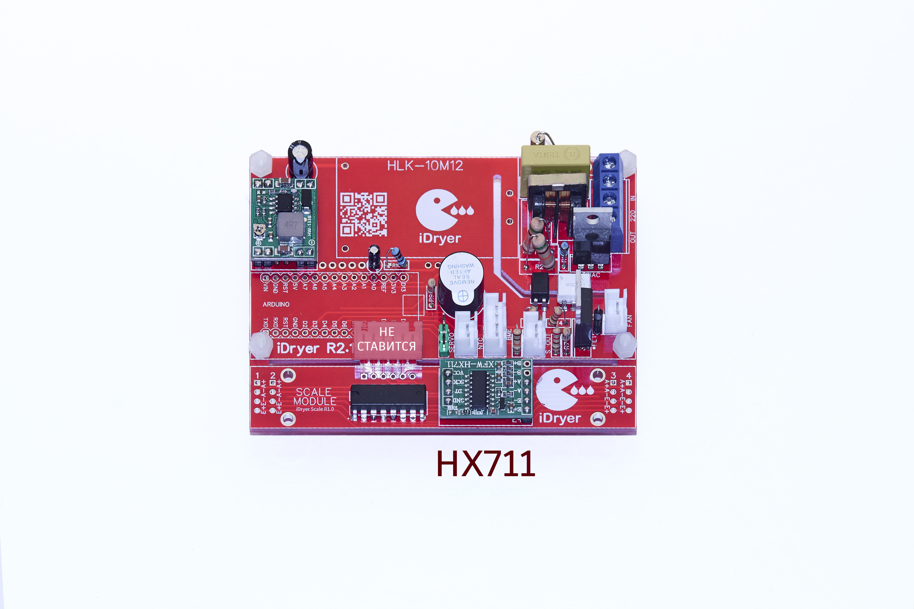
[picture p160: docs/img/pcb-manual/IMG_1441.jpg]

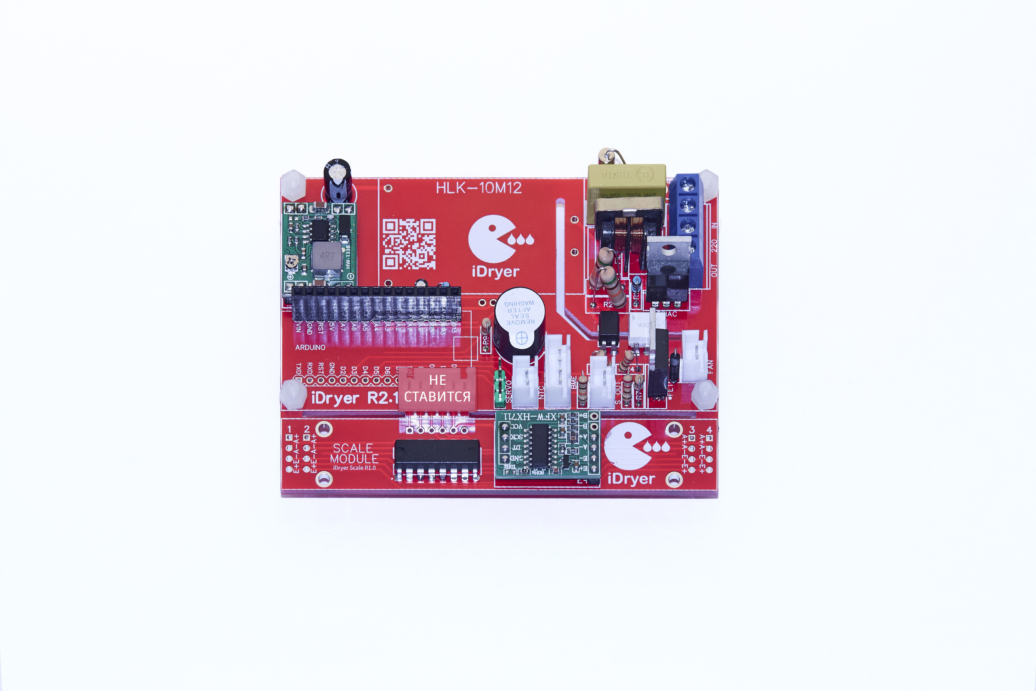
[picture p161: docs/img/pcb-manual/IMG_1442.jpg]

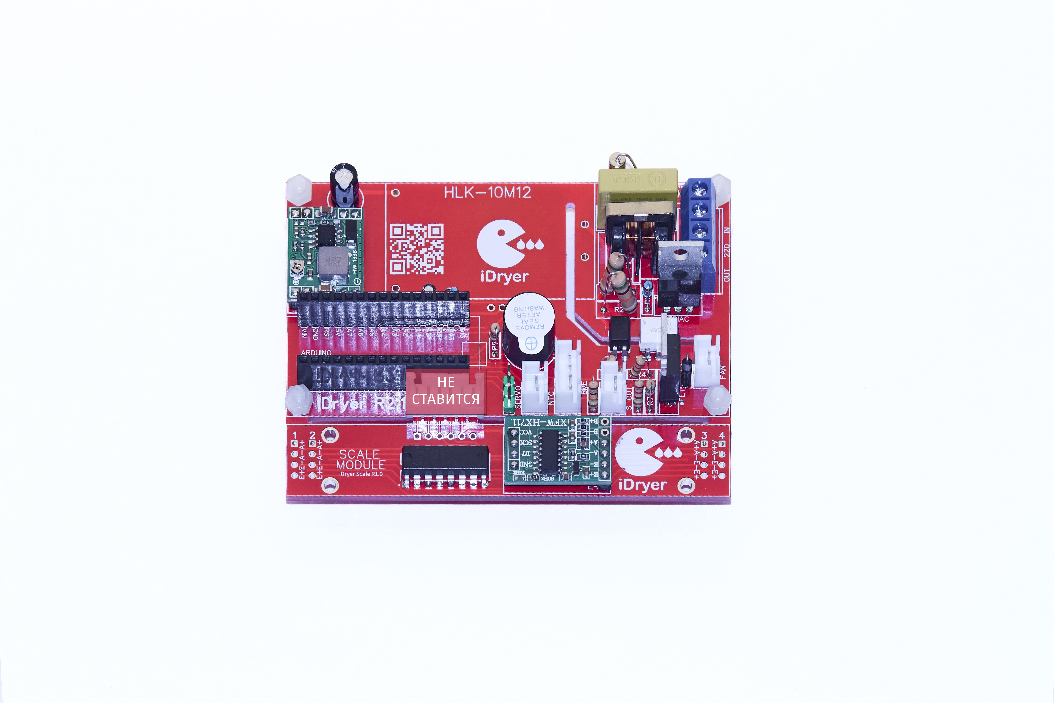
[picture p162: docs/img/pcb-manual/IMG_1443.jpg]

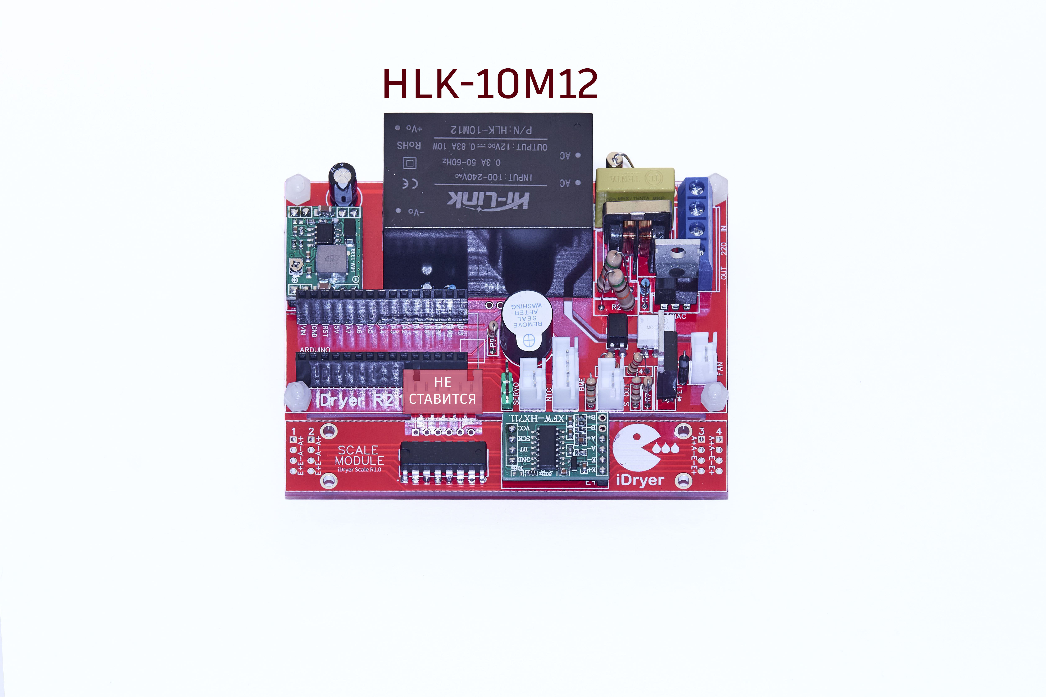
[picture p163: docs/img/pcb-manual/IMG_1444.jpg]

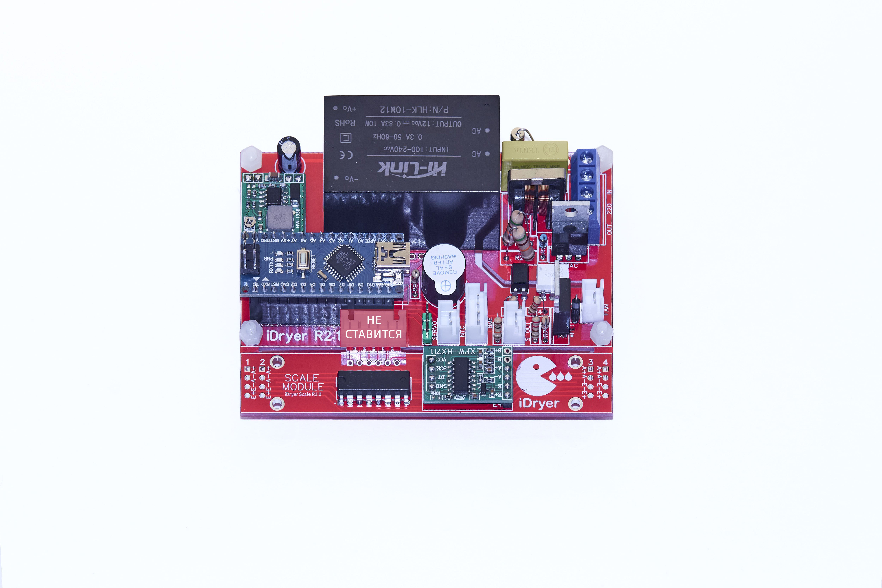
[picture p164: docs/img/pcb-manual/IMG_1445.jpg]

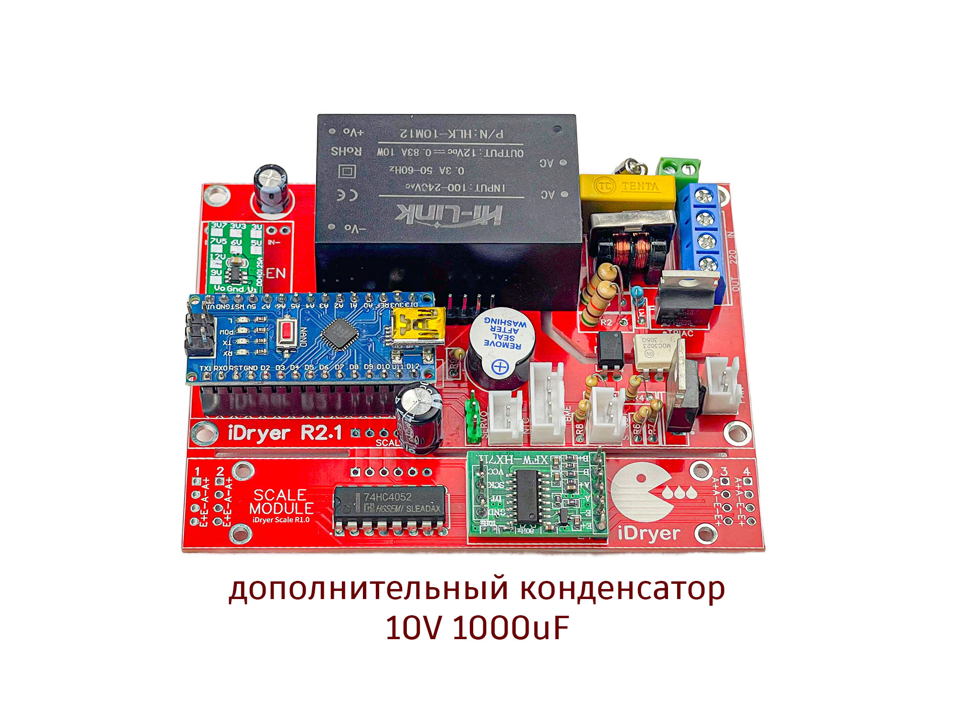
[picture p165: docs/img/pcb-manual/IMG_3080.jpg]


!!! info "Stiftleisten"
    In der aktuellen Montagevariante werden für die Verbindung des Displays und des Encoders Stiftleisten mit 4 bzw. 5 Pins auf die Leiterplatte gelötet.
    Für die Verbindung werden auf einer Seite mit Steckern versehene Drähte verwendet (BLS/Dupont/schwarz), die in den Encoder und das Display gelötet werden. Falls erforderlich, kann die werkseitig installierte Stiftleiste aus dem Encoder ausgelötet werden.

    Der BME280-Sensor wird auf die im Bausatz enthaltenen Drähte gelötet, das Kabel zum Sensor - Stecker (weiß) zur Leiterplatte

!!! danger "Überprüfen Sie die Orientierung der ICs und der Bestückungsdruck"
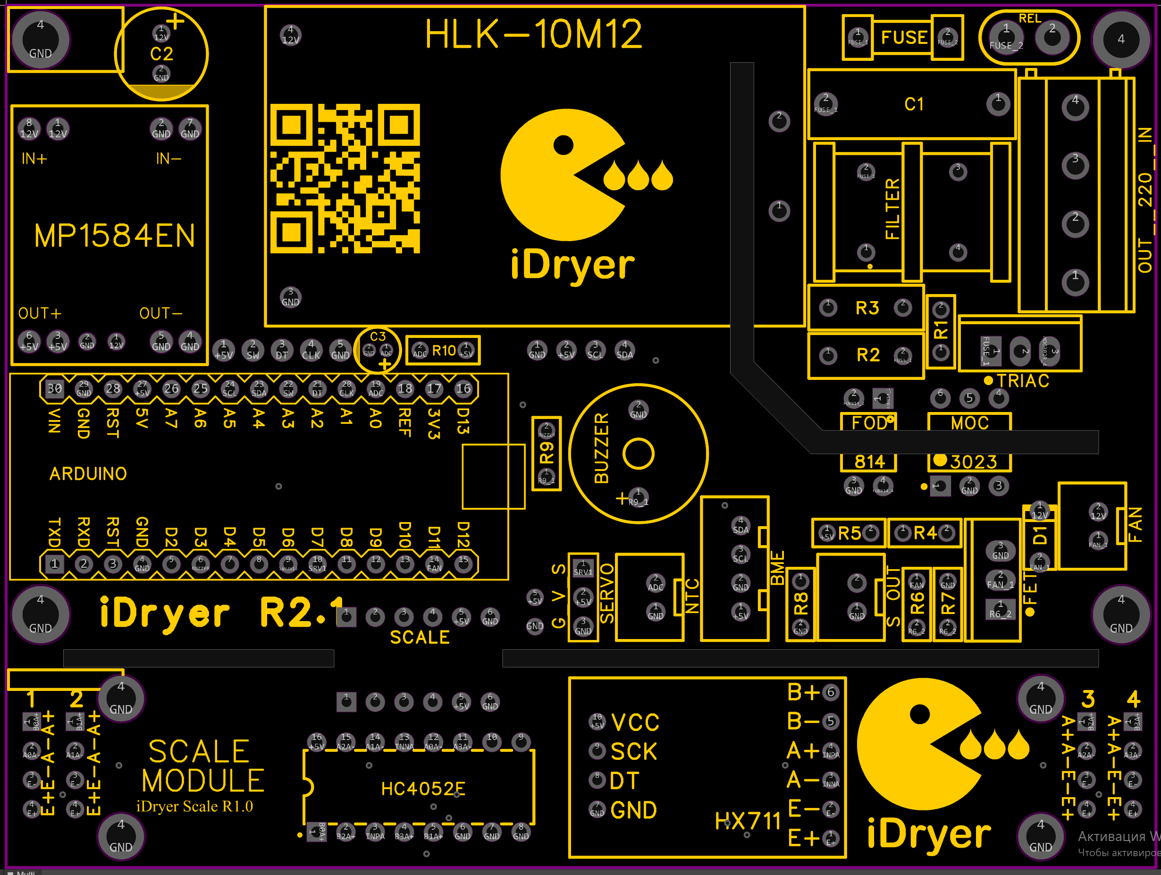
[picture p166: docs/img/pcb-manual/021.png]


### Verbindung des Thermoschalters und des Schalters
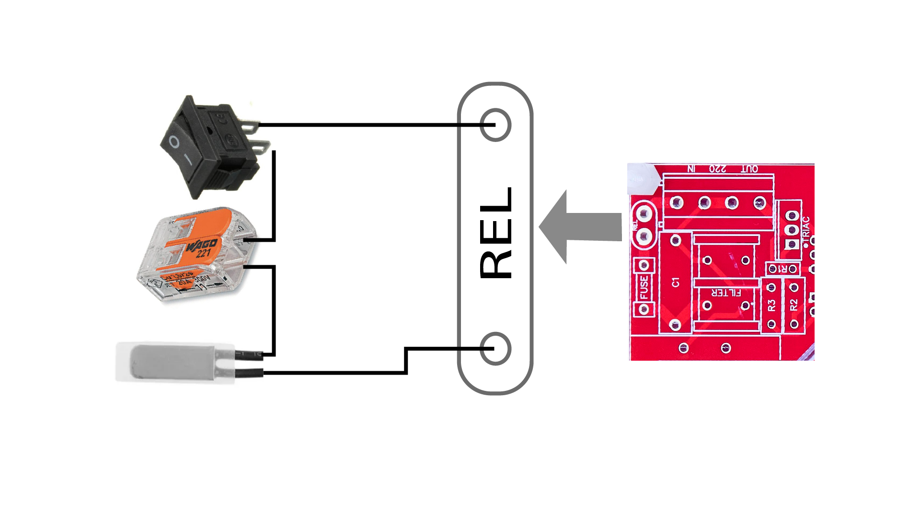
[picture p167: docs/img/pcb-manual/con_1.png]


### Montage des Displays und des Encoders auf der Leiterplatte

so muss es gemacht werden, wenn der Regler in einem separaten Gehäuse montiert wird
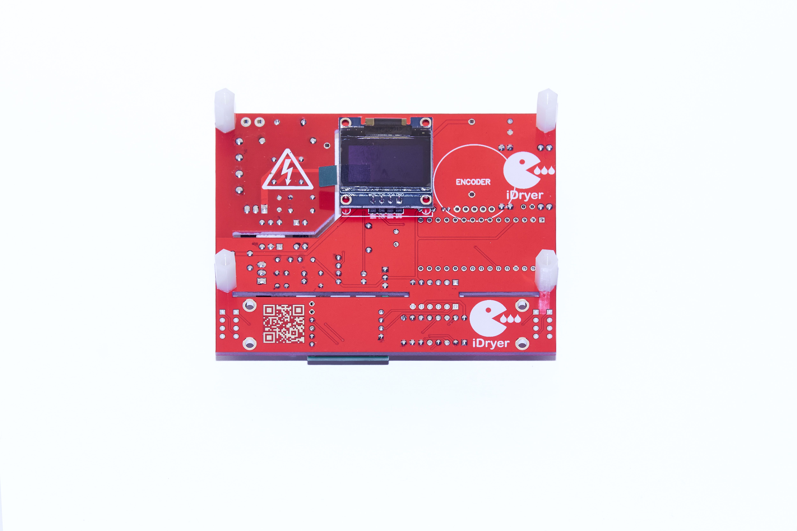
[picture p168: docs/img/pcb-manual/IMG_1447.jpg]

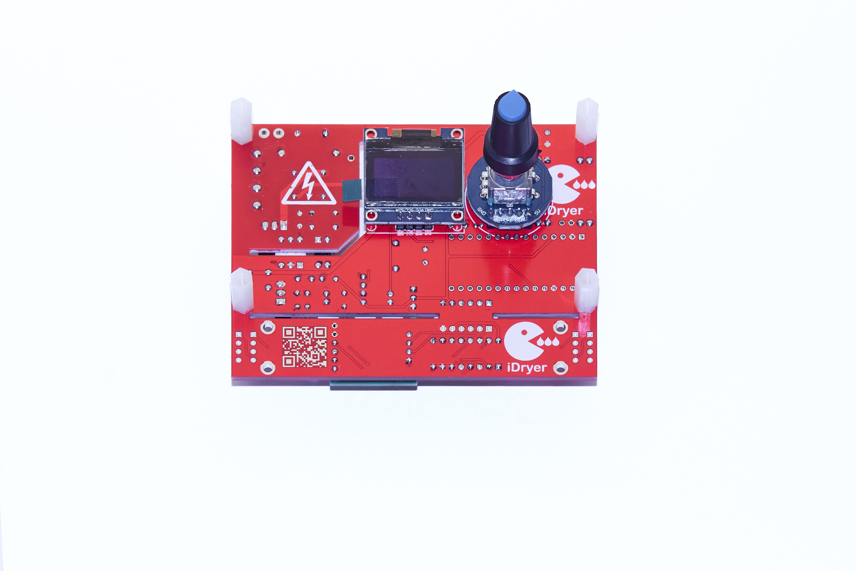
[picture p169: docs/img/pcb-manual/IMG_1448.jpg]
