pavluchenkor/iDryer-X/(commit log)

2026-06-24 docs: add BOM for iDryer X v3
2026-06-29 docs: update navigation labels to use 'CAD' for parts across multiple languages
2026-06-30 docs: remove redundant PCB images from assembly manuals
2026-06-30 docs: remove redundant assembly instructions from PCB documentation
2026-10-02 docs: fix power consumption units (W instead of W/hour)
