pavluchenkor/iDryer-X/(notices)

Notices in the files:
README.md:
License: GPL-3.0-or-later
