pavluchenkor/iDryer-X/docs/img/overview/iDryer.png

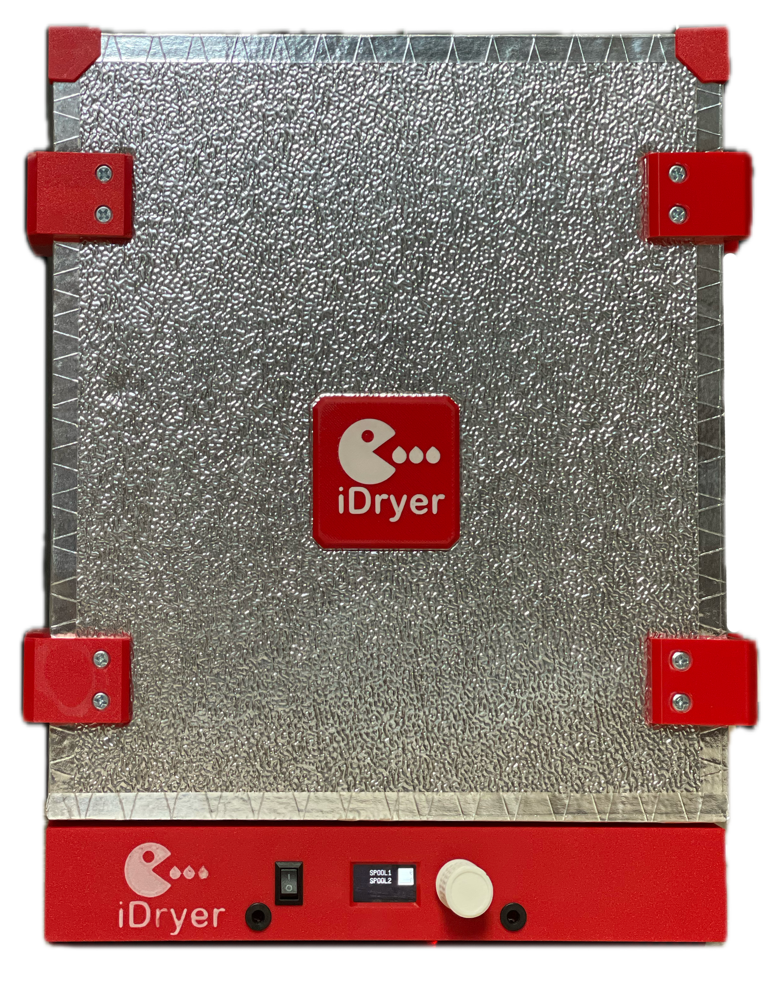
[picture p2: docs/img/overview/iDryer.png]
docs/img/overview/iDryer.png
